Karpuls/E0005-esp32-s3-5v-controller/fab/E0005_revA/README.md

# E0005 ESP32-S3 5 V controller board, rev A: fabrication package

- Source: `E0005_controller.kicad_pcb` at commit `50c434e` (sha256 prefix `6ef8de77dd03ea71`), KiCad 10.99 (Backplane bp.4).
- Generated on 2026-10-28 by `build/scripts/fab_export.sh`. The script is deterministic: re-running it gives the same files apart from timestamps.
- Routing is final and approved by PlaceRoute at `50c434e`. That includes the USB pair at JLC's 90 Ω width (`c871ee5`) and the same-net via-in-pad fixes F-1/F-2 (`50c434e`).
- Gerber review: [`docs/gerber_review.md`](docs/gerber_review.md).

## Board
- **4 layers, 1.6 mm finished, 1 oz outer / 0.5 oz inner**, stackup **JLC04161H-3313**:
  - L1 0.035;
  - prepreg 3313 0.0994;
  - L2 0.0152;
  - core 1.265;
  - L3 0.0152;
  - prepreg 0.0994;
  - L4 0.035 mm.
- Layer use:
  - **F.Cu**: parts, most signals, power pours.
  - **In1**: solid GND, no tracks.
  - **In2**: V5 plane (west column and north port band), 3V3 plane, short slow-signal lanes.
  - **B.Cu**: signals, GND pour, holder lugs, B.Cu V5 strap, MID pours.
- **125 × 73 mm**, R3 corners, 4 × M3 holes (Ø3.2 mm plated, 4 mm corner inset).
- **Vias are tented** (board setting: tenting front and back), so there are no mask openings on vias. The only exceptions are the EP thermal vias inside U2's and U15's exposed pads.
- Vias 0.6/0.3 mm. Minimum track 0.15 mm (signals). JLC clearance rules plus the owner's via-to-pad rule are in `E0005_controller.kicad_dru`.
- Drills:
  - Plated, 701:
    - 685 × 0.30 (vias);
    - 4 × 0.60 oval slots (J11 USB-C shell);
    - 4 × 0.80 (NTC leads);
    - 4 × 1.30 (holder lugs);
    - 4 × 3.20 (M3).
  - **Non-plated, 8:**
    - 2 × 0.65 (USB-C pegs);
    - 2 × 2.40 and 4 × 3.60 (Keystone 1121 holder locating pegs).
- **USB D+/D−:** 90 Ω differential, F.Cu over In1 GND. W 0.153 mm, S 0.20 mm, coplanar with a 0.30 mm gap to the pour (see Impedance control).
- Board checks (`reports/`):
  - **DRC: 0 errors, 0 unconnected, 0 schematic-parity issues** (all severities, zones refilled). The **only** violation is the accepted U1 `lib_footprint_mismatch` warning (local override of the ESP32-S3-WROOM-1 footprint).
  - **ERC: 0 violations** (all severities).

## Files
| Path | Content |
|---|---|
| `E0005_revA_gerbers_JLC.zip` | **Upload this to JLC.** It holds 11 Gerbers (F/In1/In2/B Cu, F/B Mask, F/B Paste, F/B Silk, Edge.Cuts), the PTH and NPTH Excellon drills, and the job file |
| `gerbers/` | The same files, unzipped |
| `assembly/E0005_revA_CPL_JLC.csv` | Placement in JLC CPL format (Designator, Mid X, Mid Y, Layer T/B, Rotation; mm, absolute board coordinates). **267 fitted parts**; DNP excluded |
| `assembly/E0005_revA_BOM_JLC.csv` | BOM in JLC column format (Comment, Designator, Footprint, Manufacturer, Manufacturer Part, LCSC Part #). LCSC numbers are filled only for the LCSC-sourced GH connectors. Use it only if JLC assembles; the build plan is hand assembly |
| `assembly/E0005_revA_pos_front.csv`, `_pos_back.csv`, `_pos_all.csv` | KiCad position files (CSV, mm), including DNP |
| `assembly/E0005_revA_assembly_top.pdf`, `_bottom.pdf` | Assembly drawings: Fab layer (outlines and references, pads sketched), courtyards and board outline, with the title block. The bottom view is mirrored; DNP parts are crossed out |
| `assembly/E0005_revA_DNP.txt` | DNP list: **R60** |
| `E0005_revA_BOM.csv` | **DigiKey BOM (primary)**, generated by `build/scripts/make_bom.py` from the schematic. See [BOM_README.md](BOM_README.md) |
| `docs/E0005_revA_schematic.pdf` | Schematic |
| `docs/gerber_review.md`, `docs/gerber_review/` | Gerber review with images rendered from the gerbers, and the measured numbers (`gerber_review.json`) |
| `3d/E0005_revA.step` | Board STEP with components (DNP left out) |
| `reports/` | DRC and ERC (`.rpt` and `.json`), drill report, and PTH/NPTH drill maps (Gerber X2) |

## JLC order settings
- Layers **4**; thickness **1.6 mm**; outer copper **1 oz**, inner **0.5 oz**.
- **Impedance control: yes, stackup JLC04161H-3313.**
- Via covering: **tented**.
- Surface finish **ENIG** (as E0003; the board file's stackup finish is ENIG too). Any mask colour (E0003: any).
- Size 125 × 73 mm. Material FR-4, TG as standard.
- Remove the order number, or specify its location. There is room on the bottom between the holders.
- Bottom side: through-hole parts only (BH1/BH2 holders, RT1/RT2 NTCs), so B.Paste is empty. **Hand assembly with a stencil** (spec: Build). The holders and NTCs are hand-soldered.

### Impedance control
**90 Ω differential** for the **USB_DP / USB_DN** pair:
- on **L1 (F.Cu)**, referenced to **L2 (In1, solid GND)**;
- **W 0.153 mm / S 0.20 mm**, coplanar with a **0.30 mm gap to the pour**;
- stackup **JLC04161H-3313** (L1–L2 prepreg 3313, 0.0994 mm).

The width comes from JLC's impedance calculator (owner, 2026-10-28): 6.02 mil coplanar at S 0.20 mm. The pair has no layer changes; only the J11 B6/B7 contacts are tied over by two small vias.

## Gerber render check (summary of [docs/gerber_review.md](docs/gerber_review.md))
- **Copper:** the 4 layers match the board renders. **In1 is solid GND**: its only voids are antipads, hole clearances and the edge pullback. The **antenna keep-out has 0 copper** on all layers.
- **Mask:** openings on pads only. 685 vias are tented, apart from the EP vias and findings F-1/F-2 from the preliminary run (fixed in routing; see the gerber review).
- **Silk:** legible. **"5V" is at every port J1–J5** ("5V Jn E0001" and "5V J5 E0002"). Nothing on pads. The bottom silk is mirrored correctly.
- **Outline:** 125.0 × 73.0 mm with R3 corners. J11's shell slots are plated 0.6 mm ovals.
- **Drills:** the holder pegs (Ø3.6 / Ø2.4) and USB-C pegs are NPTH; M3, lugs and NTCs are plated.

## Notes
- **3D models not available, footprint outline only:**
  - **D12** (`Diode_SMD:D_0402_1005Metric`, TPD1E10B09);
  - **F1** (`Fuse:Fuse_Littelfuse-NANO2-451_453`);
  - **U15** (`Package_DFN_QFN:TDFN-14-1EP_3x3mm_P0.4mm_EP1.78x2.35mm`, MAX17205).

  The KiCad 3D library on this machine has no STEP for these three footprints (checked in both the 10.0.6 and 10.99 bp.4 installs). **E0003 doesn't have them either:** it uses the same F1 and U15 footprints, but its `lib/E0003_mech.3dshapes` holds only the Keystone 1121 model, and `fab/E0003_revA/3d/E0003_revA.step` has no fuse or TDFN body. The STEP is otherwise complete: board, the other parts, and the holders with cells.
- Rotations in the CPL are KiCad's. If JLC assembles, check the rotation preview at order time, as usual.

## Open before ordering
See [PREORDER.md](PREORDER.md).
