Karpuls/E0005-esp32-s3-5v-controller/fab/E0005_revA/reports/E0005_revA_drill_report.txt

Drill report for E0005_controller.kicad_pcb
Created on 2026-10-28T16:46:57

Copper Layer Stackup:
    =============================================================
    L1 :  F.Cu                      front
    L2 :  In1.Cu                    in1
    L3 :  In2.Cu                    in2
    L4 :  B.Cu                      back

Drill file 'E0005_controller-PTH.drl' contains
    plated through holes:
    =============================================================
    T1  0.300mm  0.0118"  (685 holes))
    T2  0.600mm  0.0236"  (4 holes)  (with 4 slots)
    T3  0.800mm  0.0315"  (4 holes))
    T4  1.300mm  0.0512"  (4 holes))
    T5  3.200mm  0.1260"  (4 holes))

    Total plated holes count 701

Drill file 'E0005_controller-NPTH.drl' contains
    unplated through holes:
    =============================================================
    T1  0.650mm  0.0256"  (2 holes))
    T2  2.400mm  0.0945"  (2 holes))
    T3  3.600mm  0.1417"  (4 holes))

    Total unplated holes count 8
