Karpuls/E0005-esp32-s3-5v-controller/docs/images/E0005_place_bottom.png

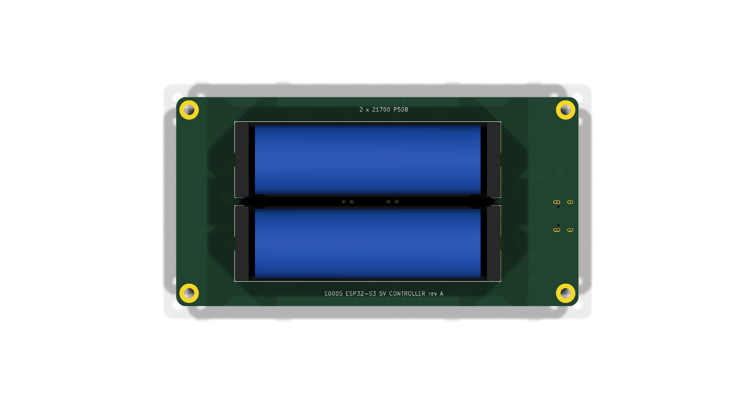
docs/images/E0005_place_bottom.png
