Karpuls/E0005-esp32-s3-5v-controller/docs/images/E0005_place_top.png

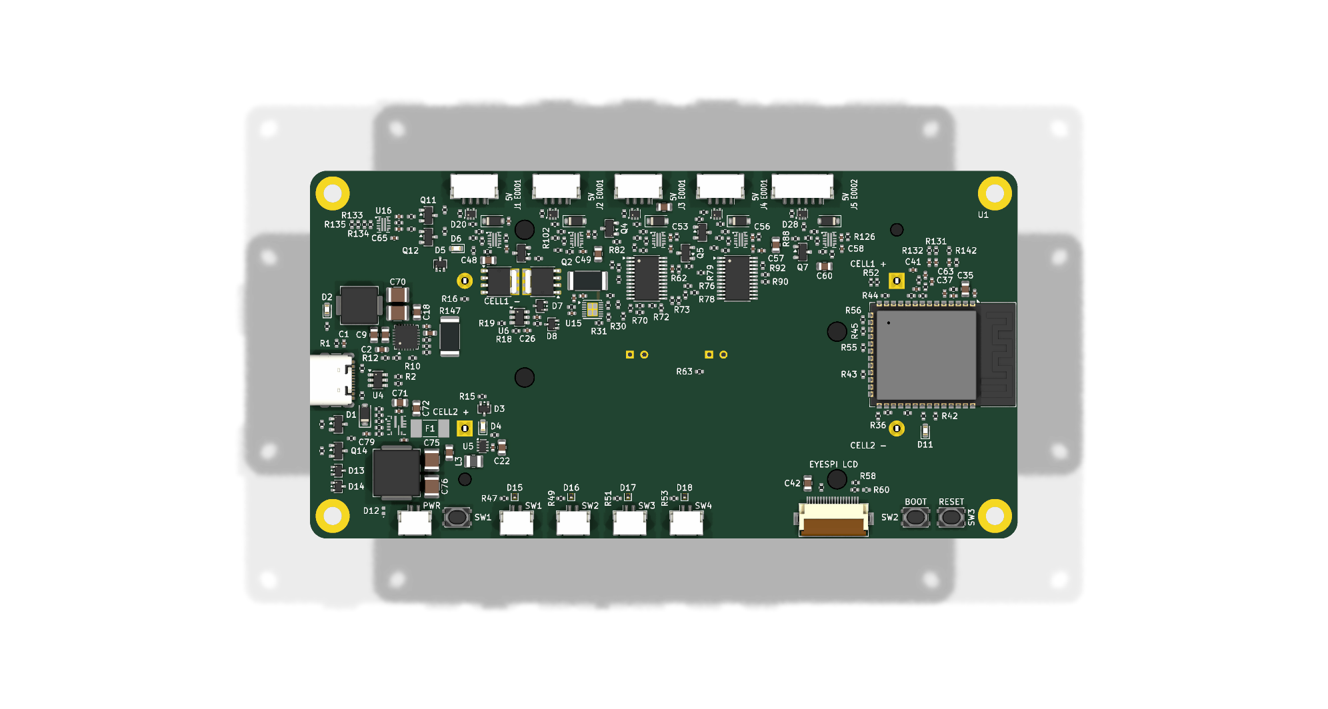
docs/images/E0005_place_top.png
