Karpuls/E0005-esp32-s3-5v-controller/fab/E0005_revA/docs/gerber_review/gerber_B_mask_vias.png

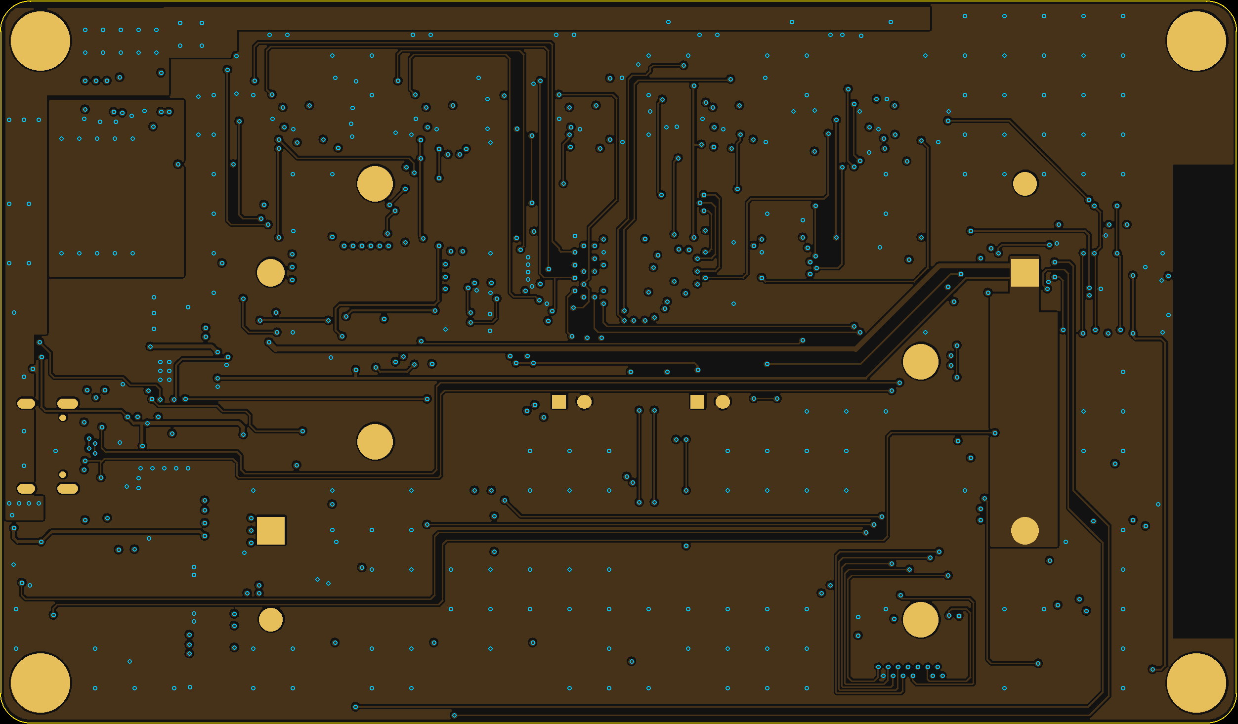
fab/E0005_revA/docs/gerber_review/gerber_B_mask_vias.png
