Karpuls/E0005-esp32-s3-5v-controller/bom/new_parts_digikey.csv

MPN | Manufacturer | SupplierPN | Stock | Lifecycle | UnitUSD | Checked | Note
BQ25887RGER | Texas Instruments | 296-53517-1-ND | 10911 | Active | 5.61 | 2026-10-27 | Cut tape 296-53517-1-ND (DigiKey API resolves it to the BQ25887RGER product page, 10 911 in stock; T&R is 296-53517-2-ND). Replaces RGET (T&R only, 211 pcs, MOQ 250) per PlaceRoute.
TPS56637RPAR | Texas Instruments | 296-TPS56637RPARTR-ND | 14313 | Active | 2.71 | 2026-10-27 | Only the T&R listing returned (14 313, MOQ 3000); cut tape (CT) PN not confirmed by the lookup: check at order time
IHLP2525CZER1R0M01 | Vishay Dale | 541-1006-1-ND | 38987 | Active | 1.11 | 2026-10-27 | 1 uH 11 A rated / 22 A sat, 10 mOhm max (TR 541-1006-2-ND)
RMCF2512FT39R0 | Stackpole Electronics Inc | RMCF2512FT39R0CT-ND | 34038 | Active | 0.25 | 2026-10-27 | 39R 1% 1 W 2512 (TR RMCF2512FT39R0TR-ND)
SMF5.0A | Littelfuse Inc. | F5748CT-ND | 21423 | Active | 0.50 | 2026-10-27 | common part E0001/E0002
TPD1E10B09DPYR | Texas Instruments | 296-30405-1-ND | 48491 | Active | 0.65 | 2026-10-27 | 9 V bidirectional ESD, X1SON-2 0402 (TR 296-30405-2-ND)
RC0402FR-07374RL | YAGEO | YAG3137CT-ND | 131070 | Active | 0.10 | 2026-10-27
RC0402FR-07300RL | YAGEO | 311-300LRCT-ND | 190616 | Active | 0.10 | 2026-10-27
RC0402FR-0714K3L | YAGEO | YAG2983CT-ND | 0 | Active | 0.10 | 2026-10-27 | STOCK 0: not used (FB divider changed to 69.8k/10k)
RC0402FR-0769K8L | YAGEO | YAG3216CT-ND | 174137 | Active | 0.10 | 2026-10-27
RC0402FR-07200KL | YAGEO | 311-200KLRCT-ND | 1264282 | Active | 0.10 | 2026-10-27
RC0402FR-0753K6L | YAGEO | 311-53.6KLRCT-ND | 86892 | Active | 0.10 | 2026-10-27
RC0402FR-076K65L | YAGEO | YAG3219CT-ND | 237279 | Active | 0.11 | 2026-10-27
RC0402FR-072K32L | YAGEO | YAG3100CT-ND | 105858 | Active | 0.10 | 2026-10-27
RC0402FR-07249KL | YAGEO | 311-249KLRCT-ND | 93250 | Active | 0.10 | 2026-10-27
RC0402FR-07390KL | YAGEO | YAG3143CT-ND | 80565 | Active | 0.11 | 2026-10-27
RC0402FR-075K1L | YAGEO | 311-5.10KLRCT-ND | 599923 | Active | 0.10 | 2026-10-27
GRM1555C1H101JA01D | Murata Electronics | 490-5922-1-ND | 107905 | Active | 0.11 | 2026-10-27 | 100 pF C0G (TR 490-5922-2-ND)
AO3401A | Alpha & Omega Semiconductor Inc. | 785-1001-1-ND | 321804 | Active | 0.52 | 2026-10-27 | common part (E0001/E0002); -30 V, VGS +-12 V, Vth -1.3 V max
RC0402FR-07402KL | YAGEO | YAG3151CT-ND | 514706 | Active | 0.11 | 2026-10-27 | port EN/UVLO (SPEC v1.1)
IHLP3232DZER3R3M11 | Vishay Dale | 541-1352-1-ND | 5904 | Active | 1.29 | 2026-10-27 | 3.3 uH 10.5 A rated / 9.7 A sat, 14.9 mOhm max, 8.64 x 8.18 x 4.0 mm; TPS56637 datasheet part (TR 541-1352-2-ND)
