Karpuls/E0005-esp32-s3-5v-controller/fab/E0005_revA/3d/E0005_revA.step

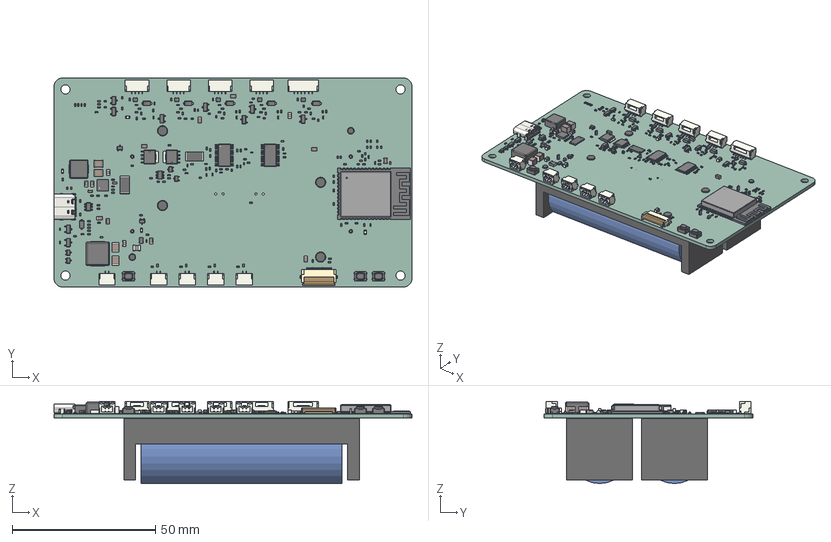
[picture p24: CAD file, 2026-10-28]
fab/E0005_revA/3d/E0005_revA.step
125.0 x 73.0 x 28.7 mm
R_0402_1005Metric x 134
L_Vishay_IHLP-3232
SOT-23 x 9
C_0402_1005Metric x 36
SW_SPST_PTS810 x 3
LED_0603_1608Metric x 4
USB_C_Receptacle_16P_TopMnt_Horizontal_GCT_USB4105-xx-A
C_0603_1608Metric x 2
SOT_553 x 5
SOT-23-6 x 2
TSSOP-24_4.4x7.8mm_P0.65mm x 2
SOT-323_SC-70 x 6
C_0805_2012Metric x 14
D_SOD_123F x 6
D_SOD-882 x 4
lock
pins
C_1210_3225Metric x 4
adbeea53-9c39-11ed-93f0-dde97e994e83_part x 2
adbeea54-9c39-11ed-93f0-dde97e994e83_part x 2
adbeea55-9c39-11ed-93f0-dde97e994e83_part x 2
JST_SM02B_GHS_TB x 5
L_1008_2520Metric
ESP32-S3-WROOM-1
JST_SM04B_GHS_TB x 4
JST_SM06B_GHS_TB
L_Vishay_IHLP-2525
R_2512_6332Metric x 2
Texas_RGE0024H_VQFN-24-1EP_4x4mm_P0.5mm_EP2.7x2.7mm
SOT-583-8
holder_fixed x 2
cell_P50B_fixed x 2
lug_neg_fixed x 2
lug_pos_fixed x 2
E0005_controller_PCB
