Karpuls/E0005-esp32-s3-5v-controller/fab/E0005_revA/assembly/E0005_revA_assembly_bottom.pdf

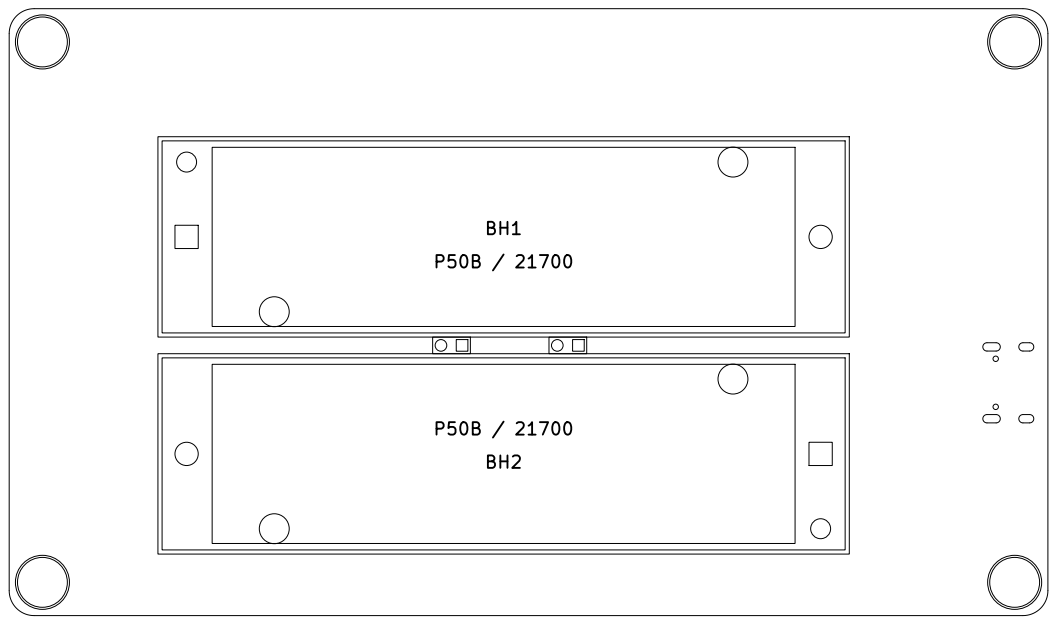
[picture p25: page 1]

4 layers 1.6 mm, JLC04161H-3313, 1 oz outer / 0.5 oz inner

Size: A4 | Rev: A
KiCad E.D.A. 10.99.0-unknown | Id: 1/1
