Karpuls/E0005-esp32-s3-5v-controller/fab/E0005_revA/docs/E0005_revA_schematic.pdf

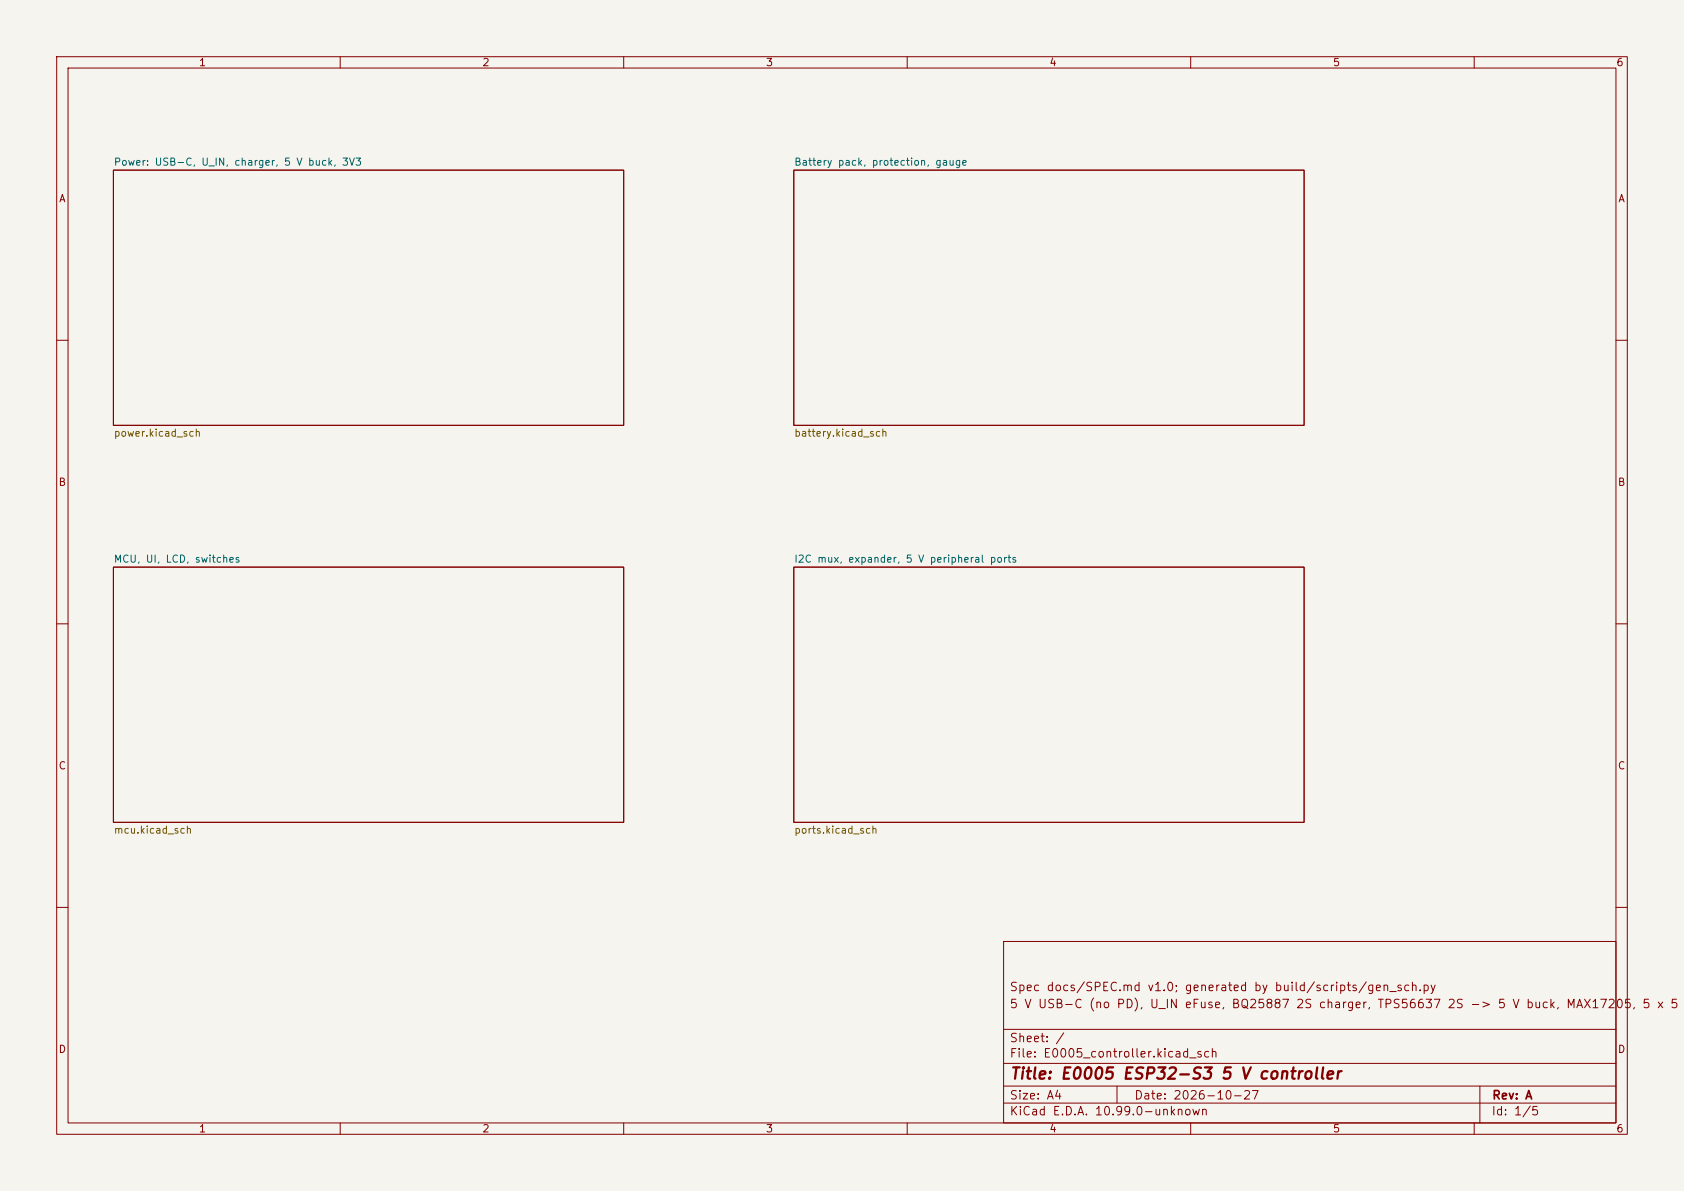
[picture p26: page 1]

Power: USB-C, U_IN, charger, 5 V buck, 3V3

Battery pack, protection, gauge battery.kicad_sch

power.kicad_sch
MCU, UI, LCD, switches mcu.kicad_sch

I2C mux, expander, 5 V peripheral ports

Spec docs/SPEC.md v1.0; generated by build/scripts/gen_sch.py
5 V USB-C (no PD), U_IN eFuse, BQ25887 2S charger, TPS56637 2S -> 5 V buck, MAX17205, 5 x 5 V ports

Size: A4 | Rev: A
KiCad E.D.A. 10.99.0-unknown | Id: 1/5

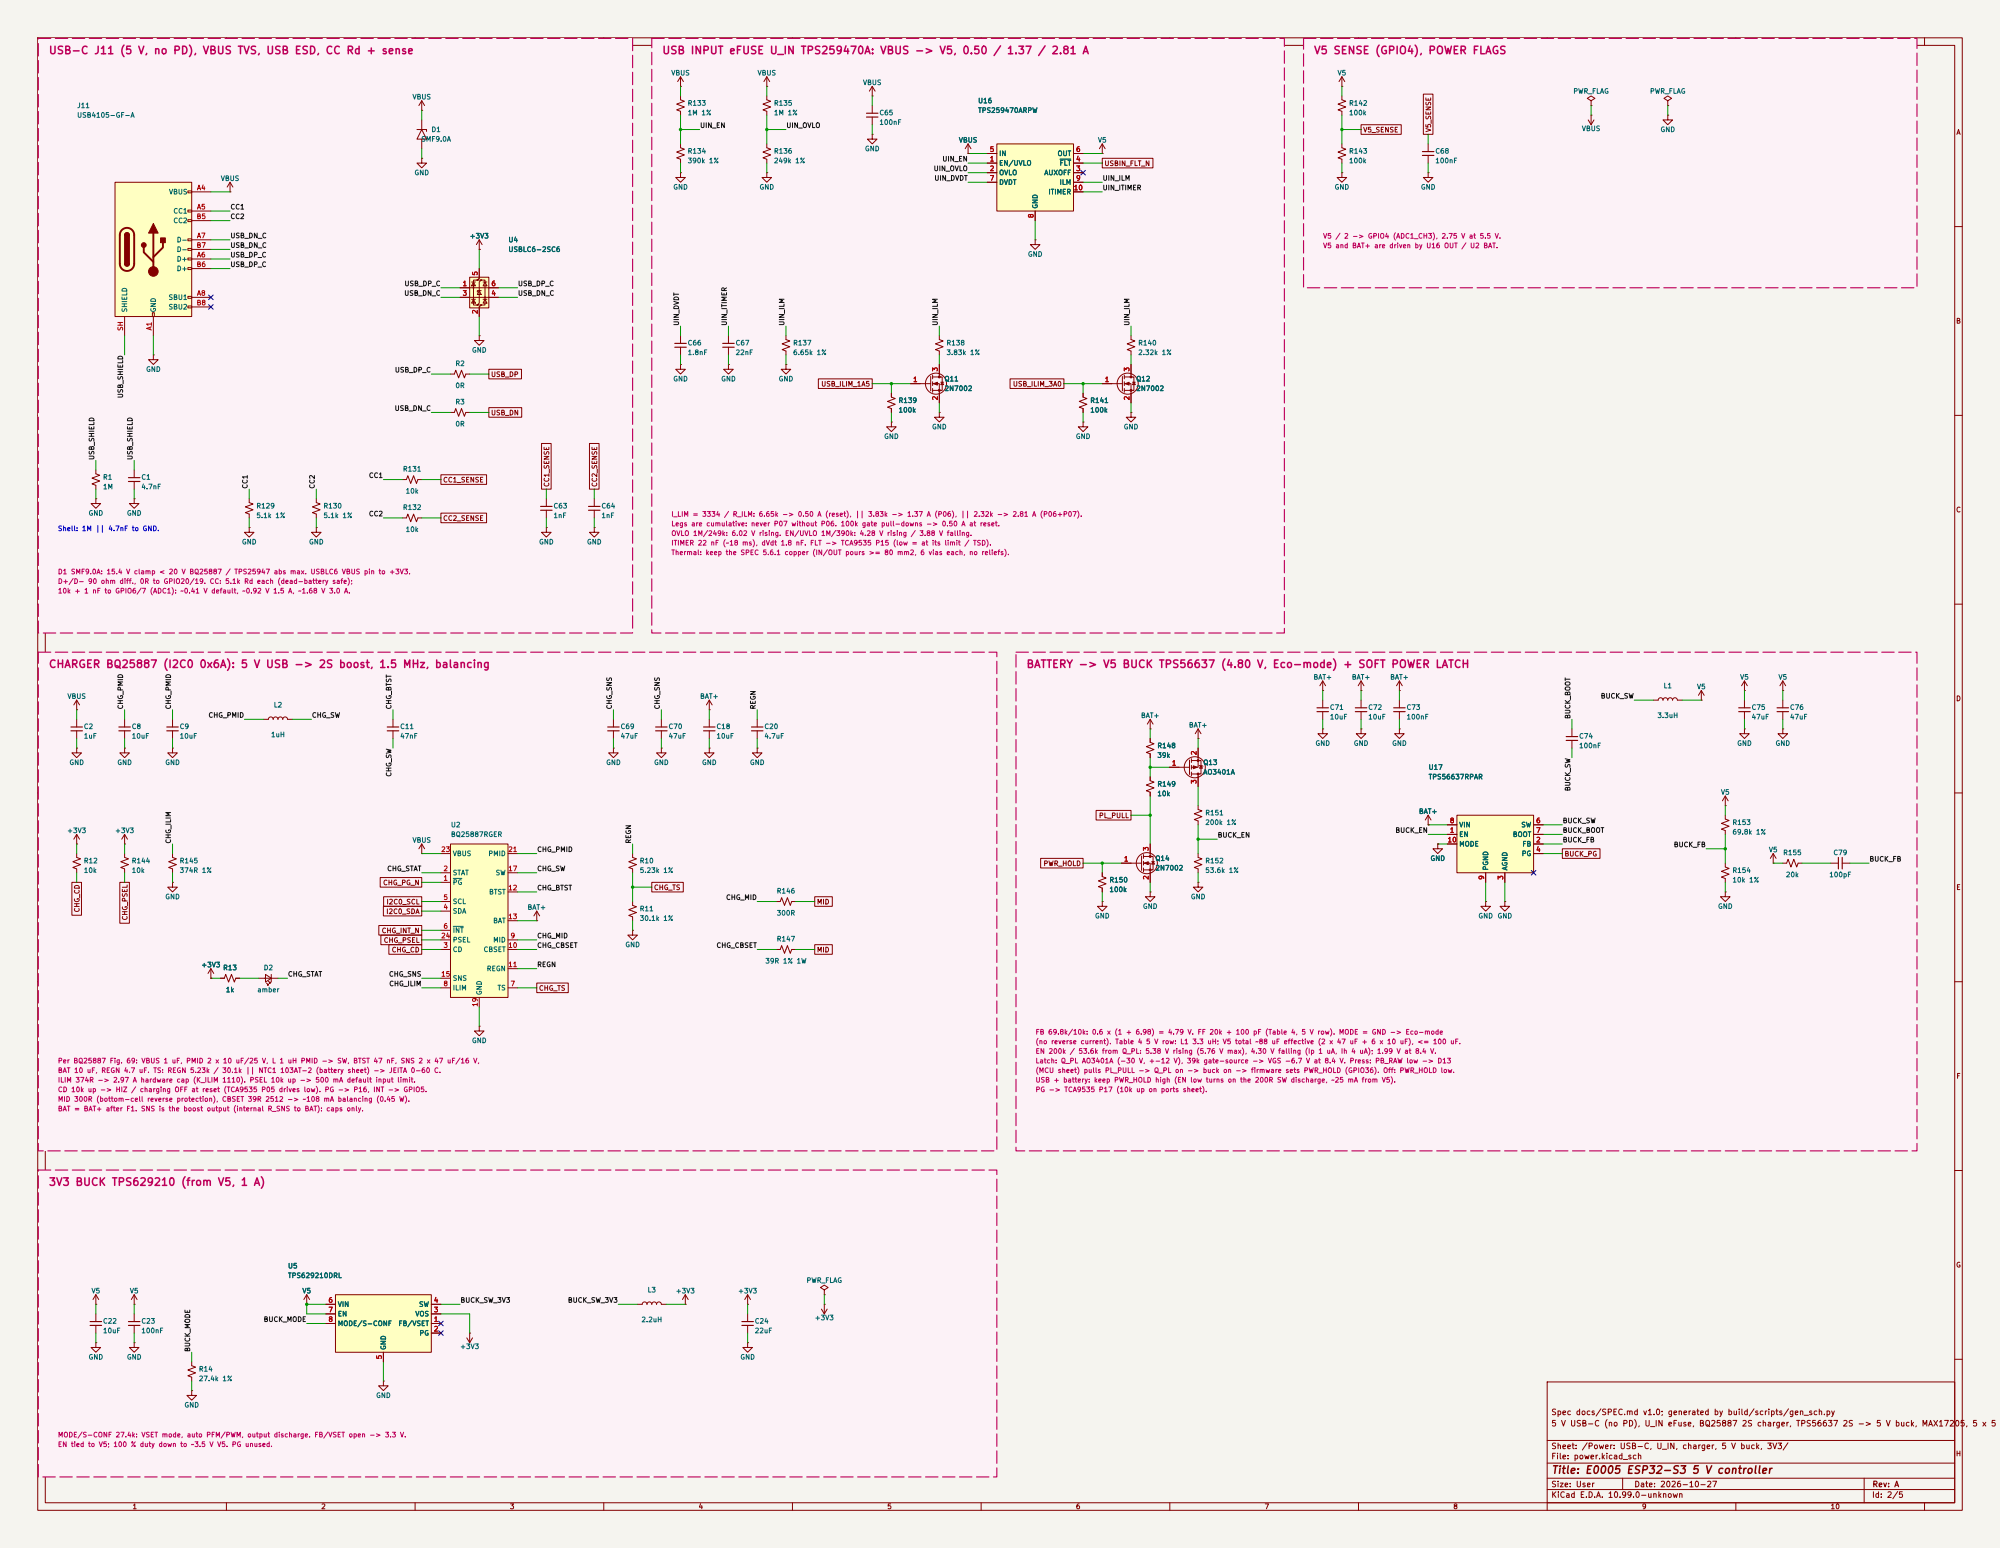
[picture p27: page 2]

V5 / 2 -> GPIO4 (ADC1_CH3), 2.75 V at 5.5 V. V5 and BAT+ are driven by U16 OUT / U2 BAT. V5 SENSE (GPIO4), POWER FLAGS
100k V5 GND

I_LIM = 3334 / R_ILM: 6.65k -> 0.50 A (reset), || 3.83k -> 1.37 A (P06), || 2.32k -> 2.81 A (P06+P07).
Legs are cumulative: never P07 without P06. 100k gate pull-downs -> 0.50 A at reset.
ITIMER 22 nF (~18 ms), dVdt 1.8 nF. FLT -> TCA9535 P15 (low = at its limit / TSD). OVLO 1M/249k: 6.02 V rising. EN/UVLO 1M/390k: 4.28 V rising / 3.88 V falling.

Shell: 1M || 4.7nF to GND. 10k + 1 nF to GPIO6/7 (ADC1): ~0.41 V default, ~0.92 V 1.5 A, ~1.68 V 3.0 A. D+/D- 90 ohm diff., 0R to GPIO20/19. CC: 5.1k Rd each (dead-battery safe); D1 SMF9.0A: 15.4 V clamp < 20 V BQ25887 / TPS25947 abs max. USBLC6 VBUS pin to +3V3.

Thermal: keep the SPEC 5.6.1 copper (IN/OUT pours >= 80 mm2, 6 vias each, no reliefs).

CHARGER BQ25887 (I2C0 0x6A): 5 V USB -> 2S boost, 1.5 MHz, balancing

BATTERY -> V5 BUCK TPS56637 (4.80 V, Eco-mode) + SOFT POWER LATCH

FB 69.8k/10k: 0.6 x (1 + 6.98) = 4.79 V. FF 20k + 100 pF (Table 4, 5 V row). MODE = GND -> Eco-mode

Per BQ25887 Fig. 69: VBUS 1 uF, PMID 2 x 10 uF/25 V, L 1 uH PMID -> SW, BTST 47 nF, SNS 2 x 47 uF/16 V, BAT 10 uF, REGN 4.7 uF. TS: REGN 5.23k / 30.1k || NTC1 103AT-2 (battery sheet) -> JEITA 0-60 C. CD 10k up -> HIZ / charging OFF at reset (TCA9535 P05 drives low). PG -> P16, INT -> GPIO5.
(MCU sheet) pulls PL_PULL -> Q_PL on -> buck on -> firmware sets PWR_HOLD (GPIO36). Off: PWR_HOLD low. EN tied to V5; 100 % duty down to ~3.5 V V5. PG unused. MODE/S-CONF 27.4k: VSET mode, auto PFM/PWM, output discharge. FB/VSET open -> 3.3 V. 3V3 BUCK TPS629210 (from V5, 1 A)
FGH
ILIM 374R -> 2.97 A hardware cap (K_ILIM 1110). PSEL 10k up -> 500 mA default input limit. MID 300R (bottom-cell reverse protection), CBSET 39R 2512 -> ~108 mA balancing (0.45 W). BAT = BAT+ after F1. SNS is the boost output (internal R_SNS to BAT): caps only.

PG -> TCA9535 P17 (10k up on ports sheet).

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

Sheet: /Power: USB-C, U_IN, charger, 5 V buck, 3V3/
File: power.kicad_sch
Title: E0005 ESP32-S3 5 V controller

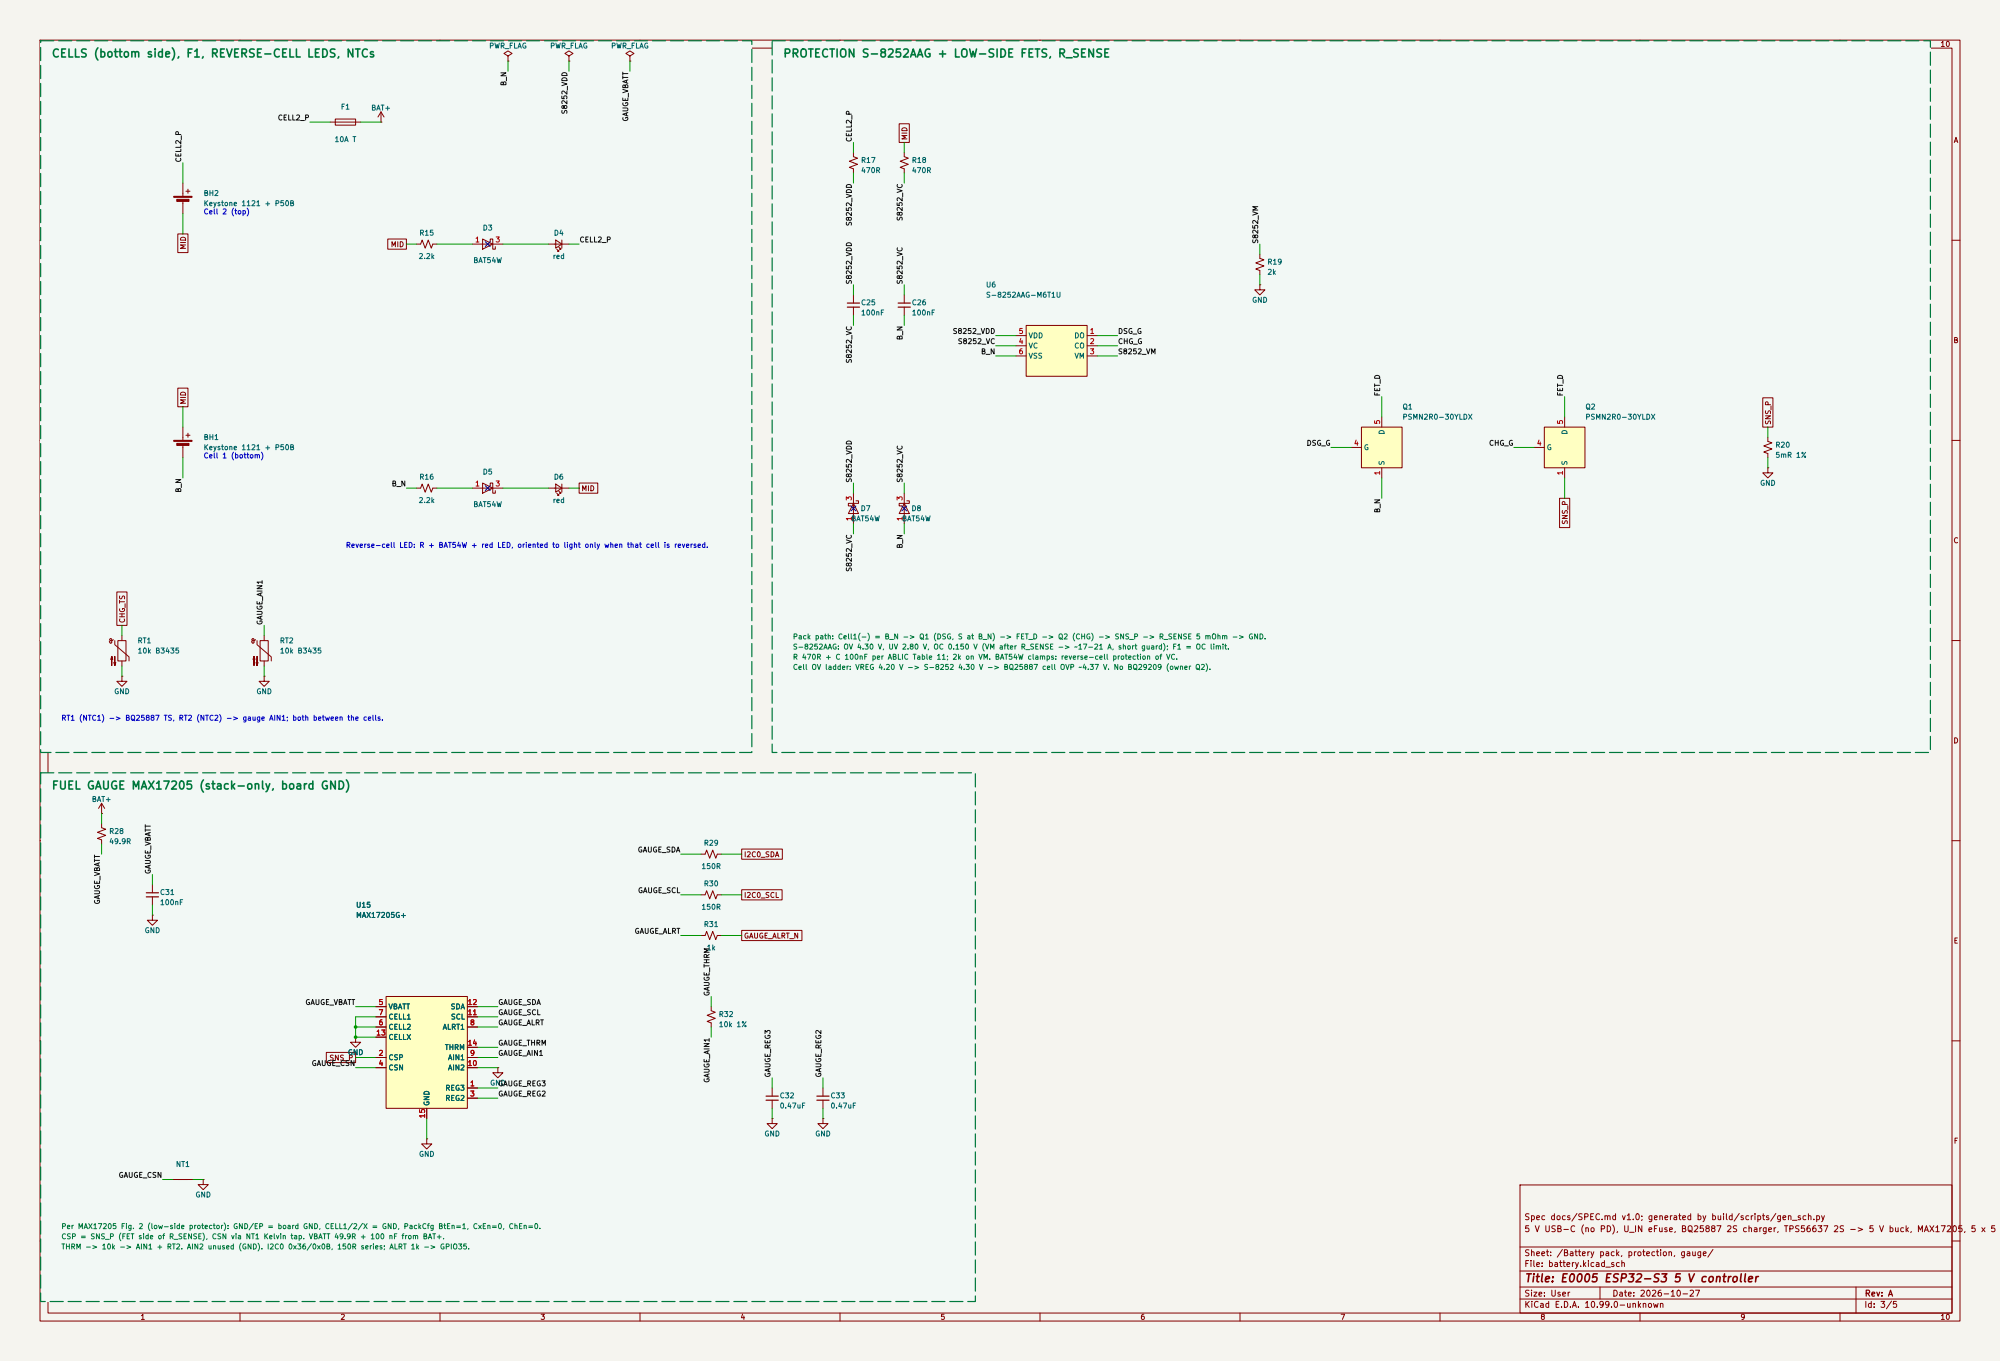
[picture p28: page 3]

R 470R + C 100nF per ABLIC Table 11; 2k on VM. BAT54W clamps: reverse-cell protection of VC. Cell OV ladder: VREG 4.20 V -> S-8252 4.30 V -> BQ25887 cell OVP ~4.37 V. No BQ29209 (owner Q2). RT1 (NTC1) -> BQ25887 TS, RT2 (NTC2) -> gauge AIN1; both between the cells. FUEL GAUGE MAX17205 (stack-only, board GND)

Spec docs/SPEC.md v1.0; generated by build/scripts/gen_sch.py GND

Per MAX17205 Fig. 2 (low-side protector): GND/EP = board GND, CELL1/2/X = GND, PackCfg BtEn=1, CxEn=0, ChEn=0. CSP = SNS_P (FET side of R_SENSE), CSN via NT1 Kelvin tap. VBATT 49.9R + 100 nF from BAT+. THRM -> 10k -> AIN1 + RT2. AIN2 unused (GND). I2C0 0x36/0x0B, 150R series; ALRT 1k -> GPIO35.

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

Sheet: /Battery pack, protection, gauge/
File: battery.kicad_sch

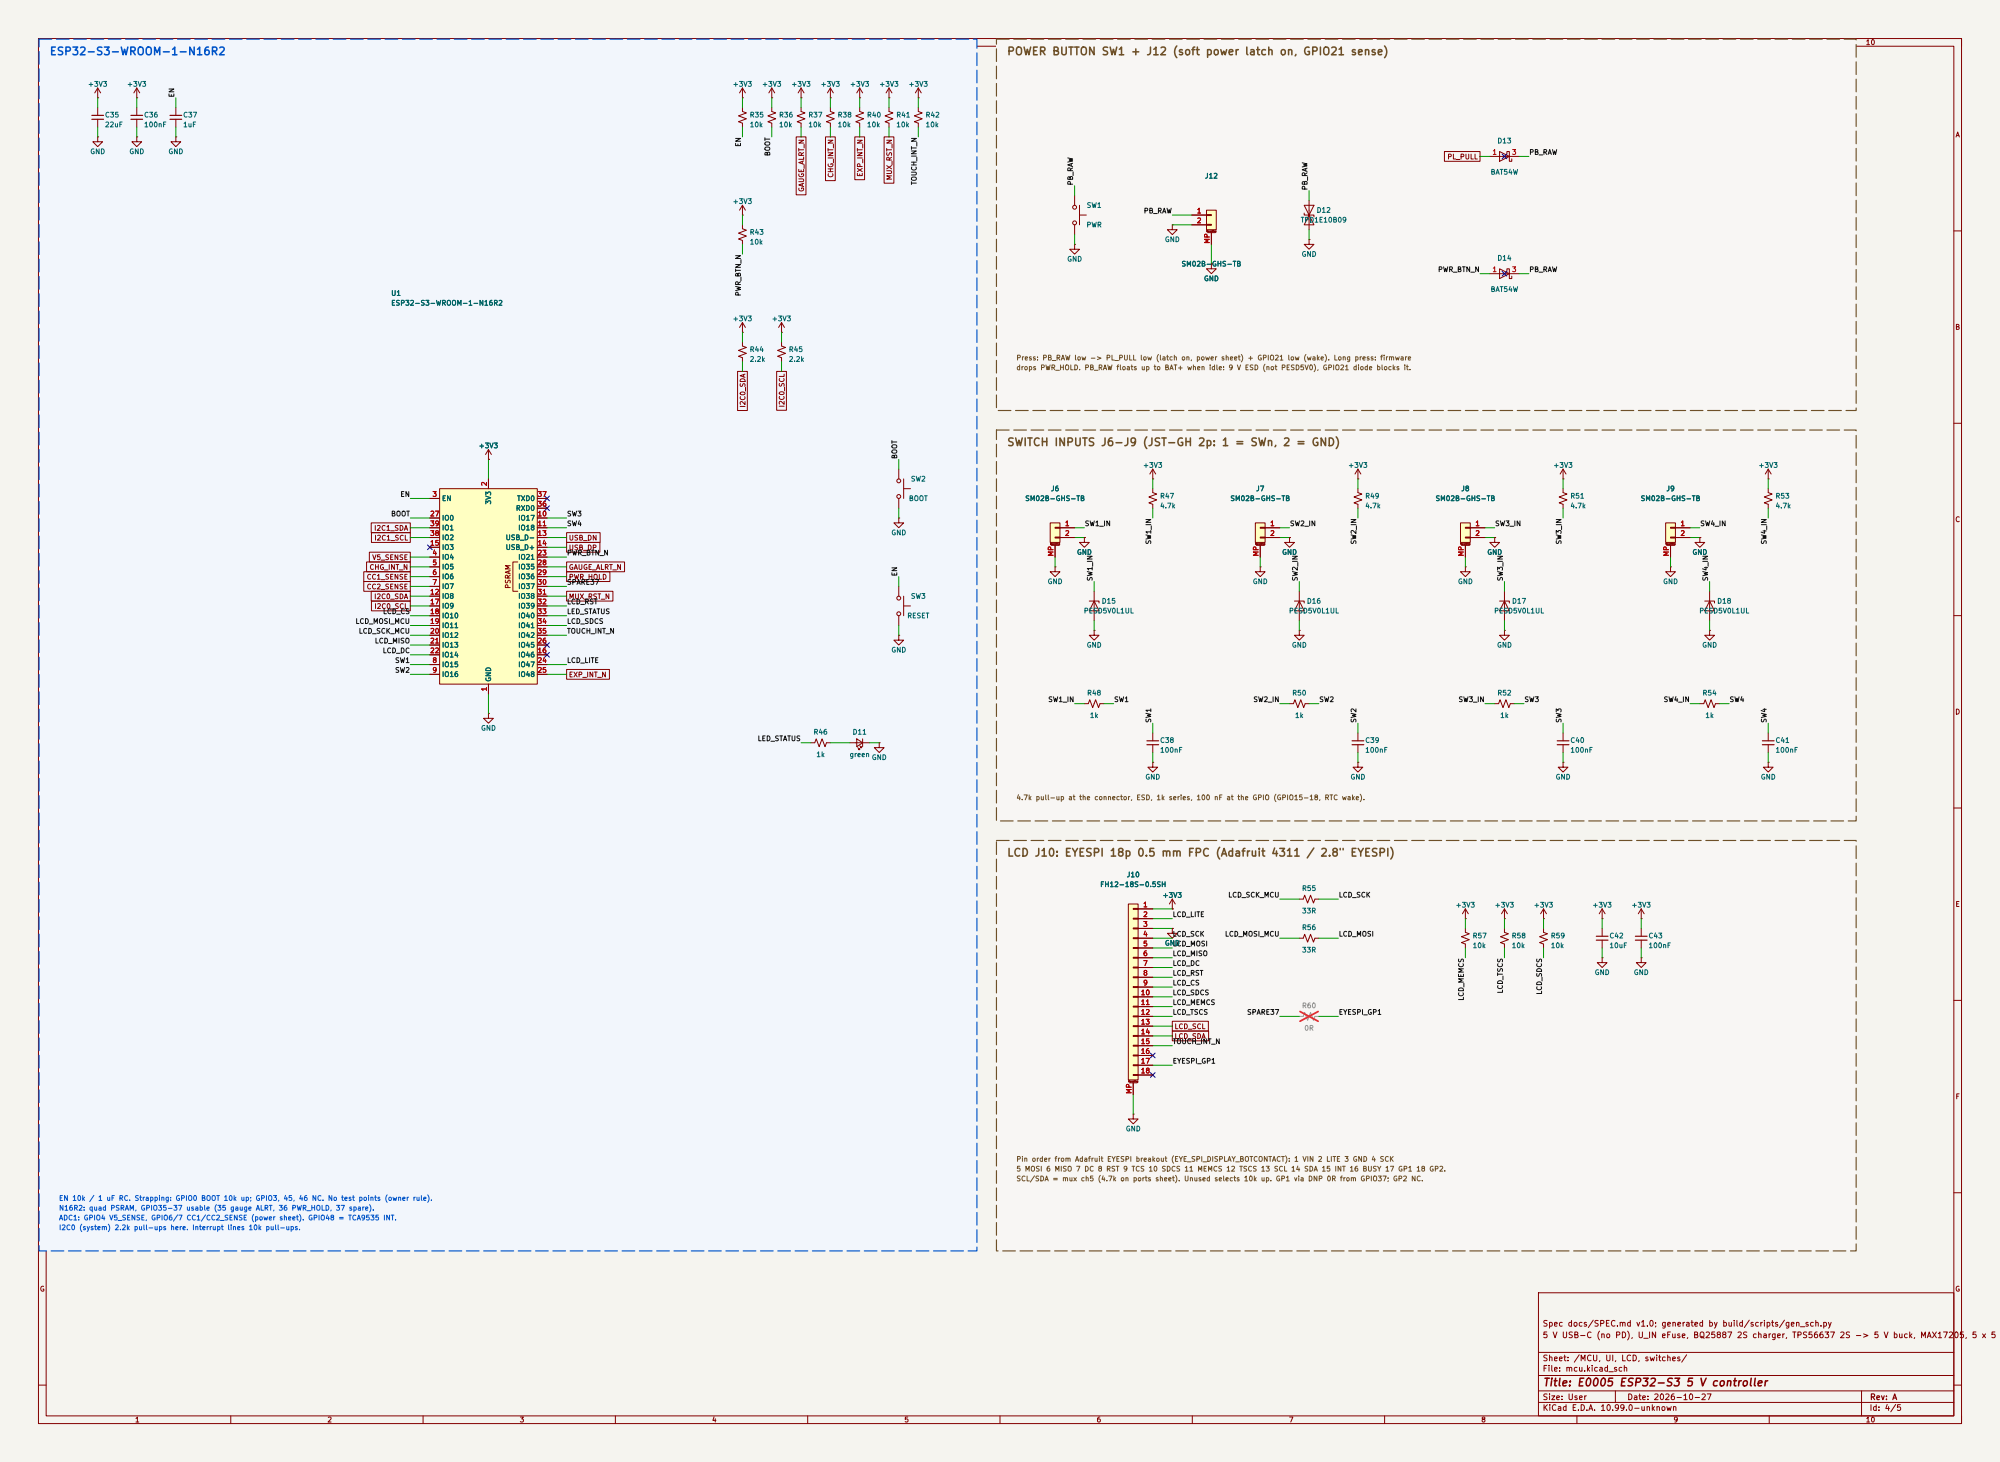
[picture p29: page 4]

POWER BUTTON SW1 + J12 (soft power latch on, GPIO21 sense)

Press: PB_RAW low -> PL_PULL low (latch on, power sheet) + GPIO21 low (wake). Long press: firmware drops PWR_HOLD. PB_RAW floats up to BAT+ when idle: 9 V ESD (not PESD5V0), GPIO21 diode blocks it. LCD J10: EYESPI 18p 0.5 mm FPC (Adafruit 4311 / 2.8" EYESPI)

SWITCH INPUTS J6-J9 (JST-GH 2p: 1 = SWn, 2 = GND)

SCL/SDA = mux ch5 (4.7k on ports sheet). Unused selects 10k up. GP1 via DNP 0R from GPIO37; GP2 NC. 5 MOSI 6 MISO 7 DC 8 RST 9 TCS 10 SDCS 11 MEMCS 12 TSCS 13 SCL 14 SDA 15 INT 16 BUSY 17 GP1 18 GP2. Pin order from Adafruit EYESPI breakout (EYE_SPI_DISPLAY_BOTCONTACT): 1 VIN 2 LITE 3 GND 4 SCK

EN 10k / 1 uF RC. Strapping: GPIO0 BOOT 10k up; GPIO3, 45, 46 NC. No test points (owner rule). N16R2: quad PSRAM, GPIO35-37 usable (35 gauge ALRT, 36 PWR_HOLD, 37 spare).

ADC1: GPIO4 V5_SENSE, GPIO6/7 CC1/CC2_SENSE (power sheet). GPIO48 = TCA9535 INT.
I2C0 (system) 2.2k pull-ups here. Interrupt lines 10k pull-ups.

Spec docs/SPEC.md v1.0; generated by build/scripts/gen_sch.py

Sheet: /MCU, UI, LCD, switches/
File: mcu.kicad_sch

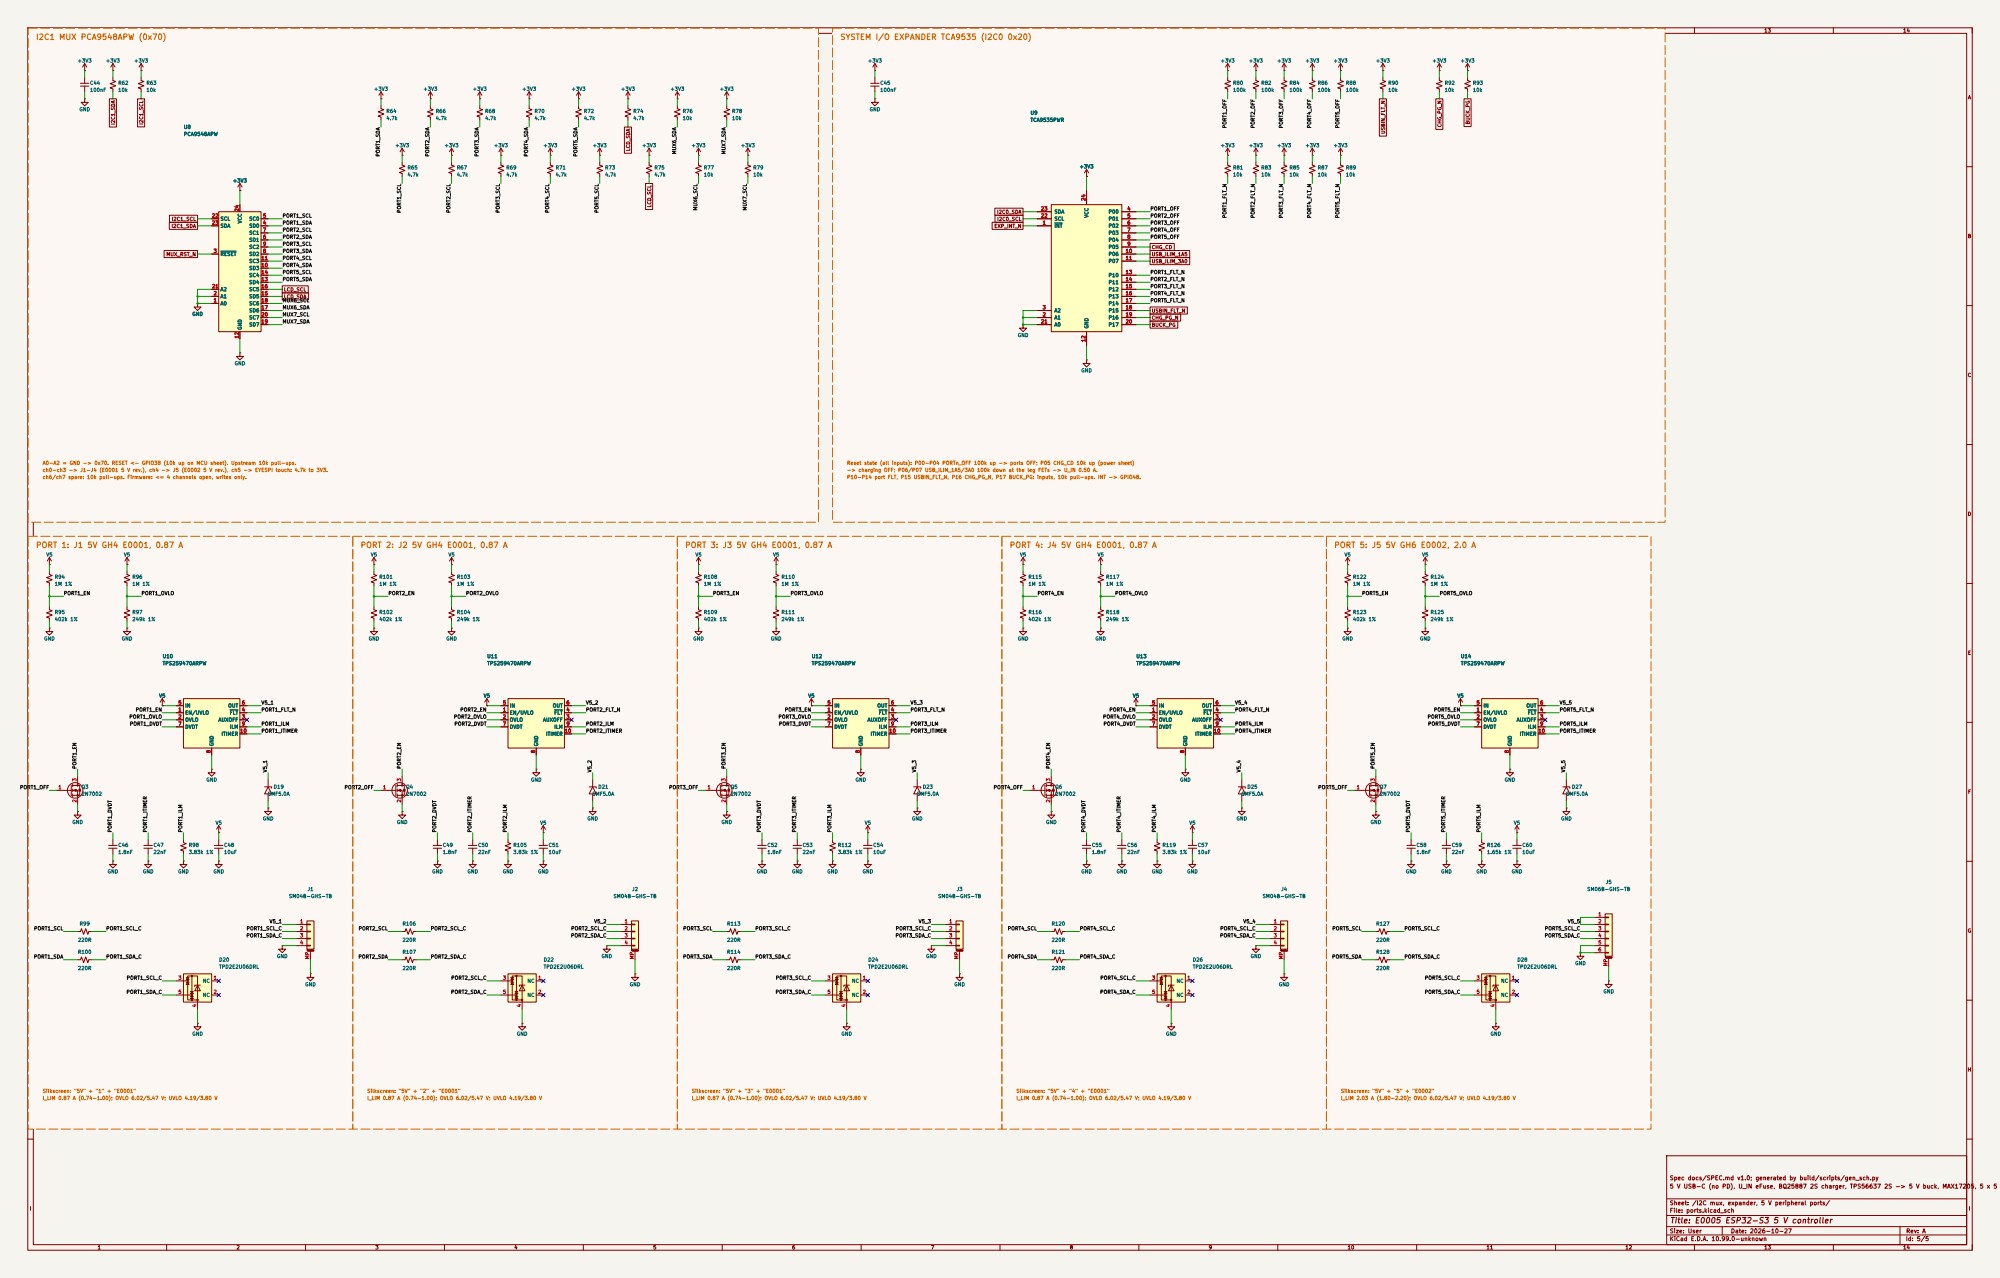
[picture p30: page 5]

ch6/ch7 spare: 10k pull-ups. Firmware: <= 4 channels open, writes only. ch0-ch3 -> J1-J4 (E0001 5 V rev.), ch4 -> J5 (E0002 5 V rev.), ch5 -> EYESPI touch: 4.7k to 3V3. A0-A2 = GND -> 0x70. RESET <- GPIO38 (10k up on MCU sheet). Upstream 10k pull-ups.

P10-P14 port FLT, P15 USBIN_FLT_N, P16 CHG_PG_N, P17 BUCK_PG: inputs, 10k pull-ups. INT -> GPIO48. Reset state (all inputs): P00-P04 PORTn_OFF 100k up -> ports OFF; P05 CHG_CD 10k up (power sheet) -> charging OFF; P06/P07 USB_ILIM_1A5/3A0 100k down at the leg FETs -> U_IN 0.50 A.

Spec docs/SPEC.md v1.0; generated by build/scripts/gen_sch.py

Sheet: /I2C mux, expander, 5 V peripheral ports/
File: ports.kicad_sch
