Karpuls/E0005-esp32-s3-5v-controller/E0005_controller.kicad_pcb

## KiCad design E0005_controller.kicad_pcb (2026-10-28)

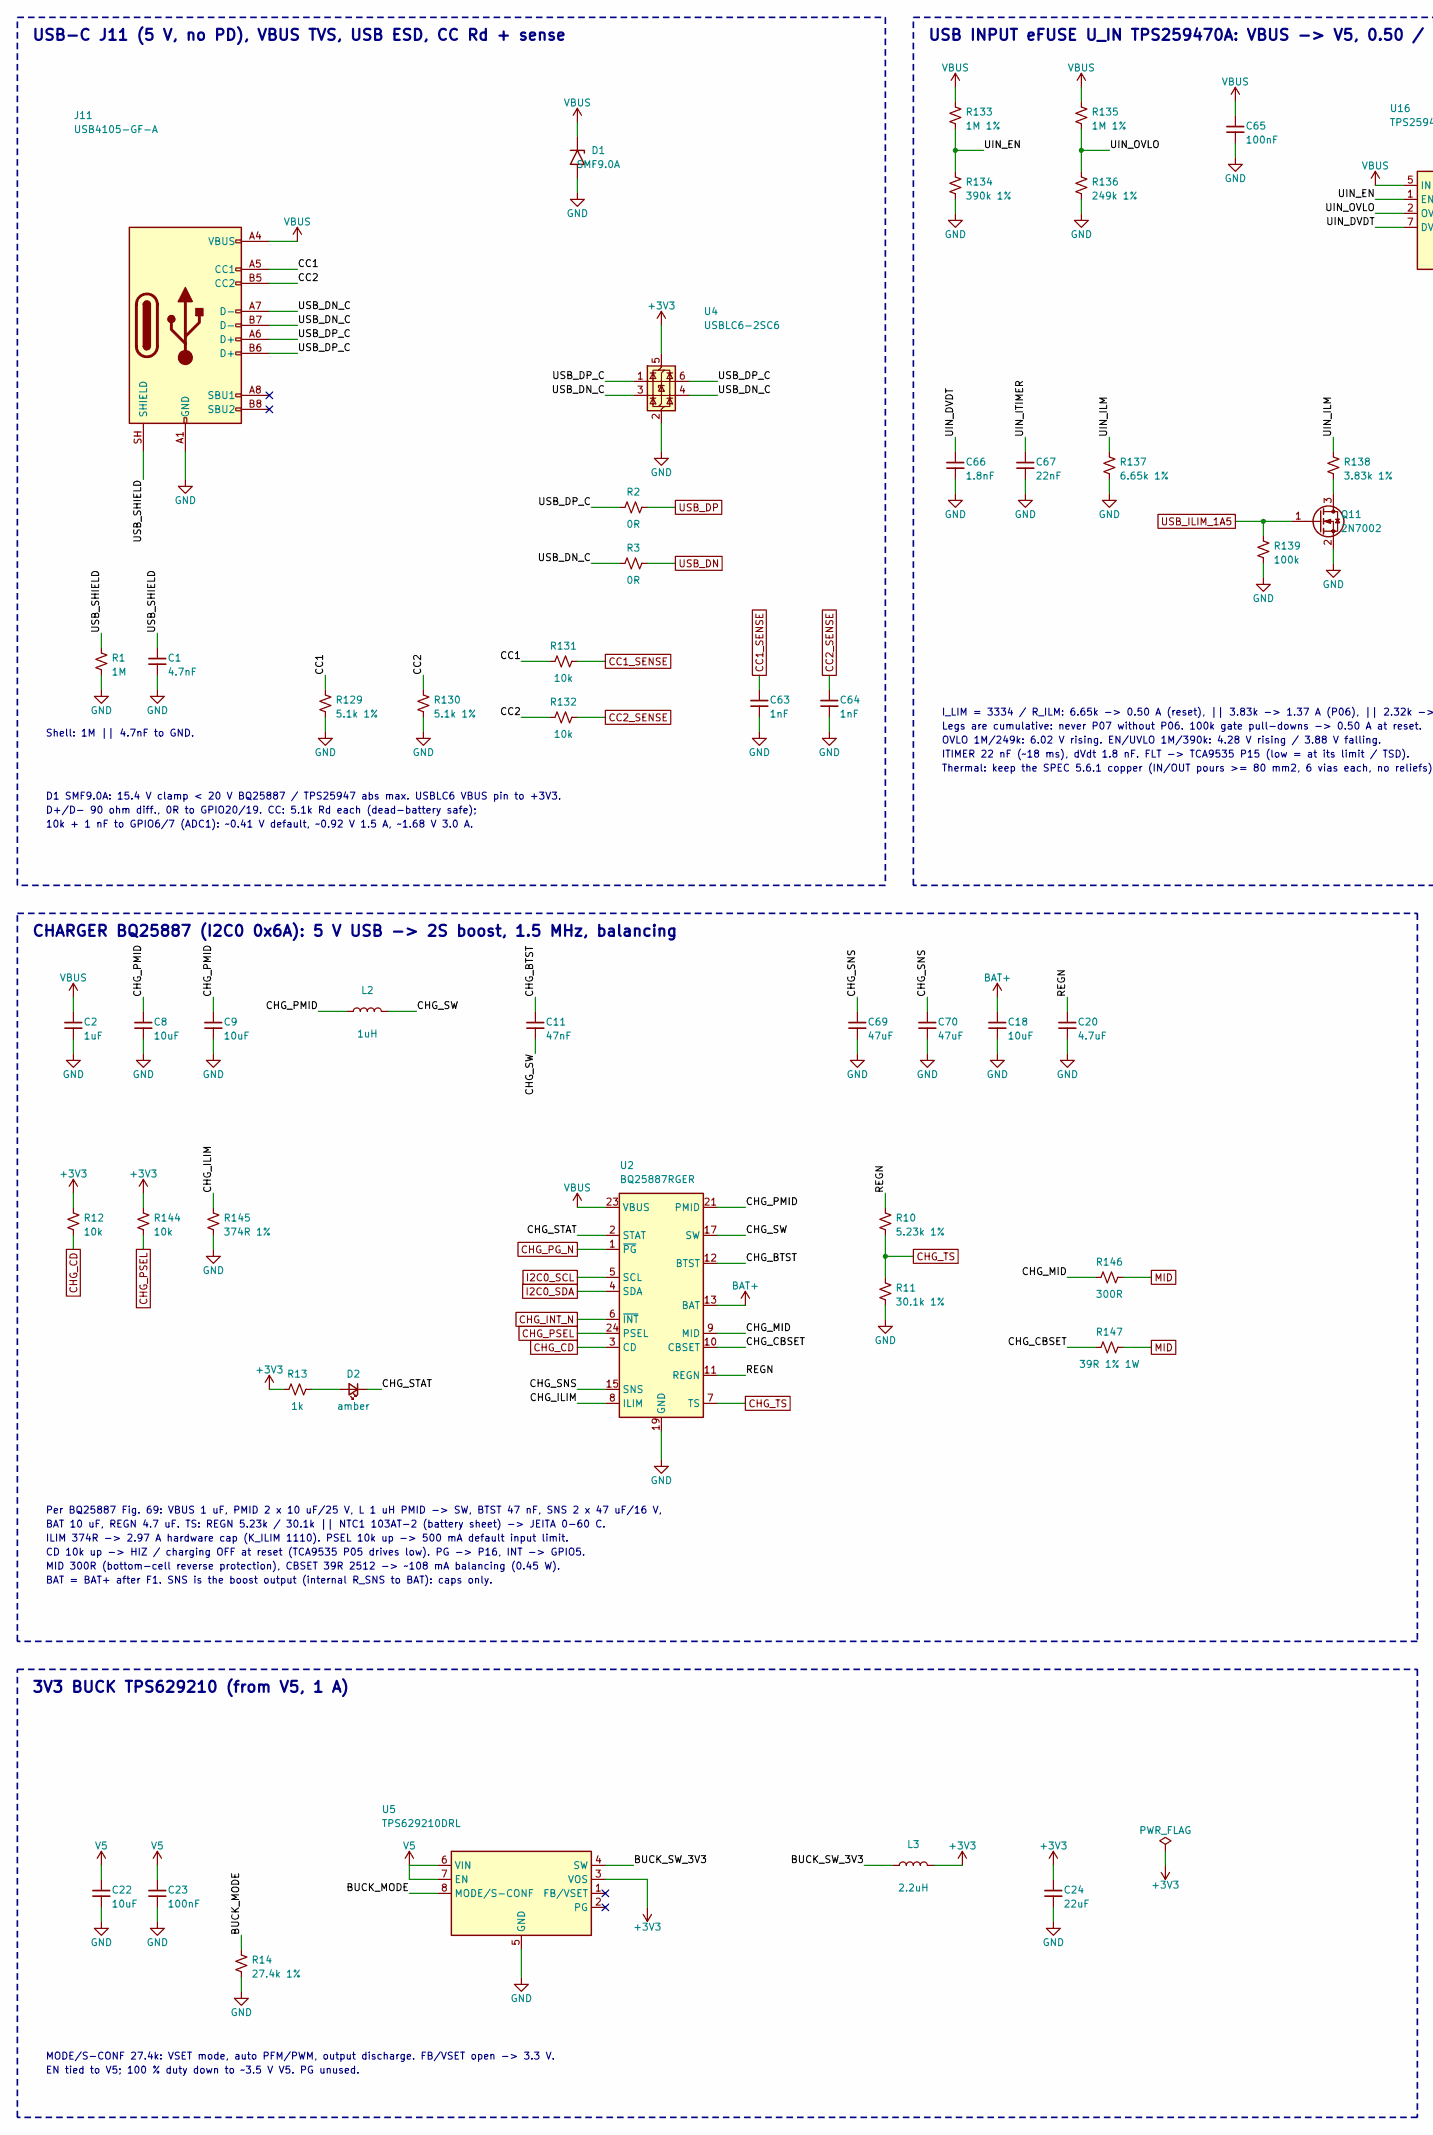
[picture p31: schematic power.kicad_sch, E0005 ESP32-S3 5 V controller, part in row 1, column 1]

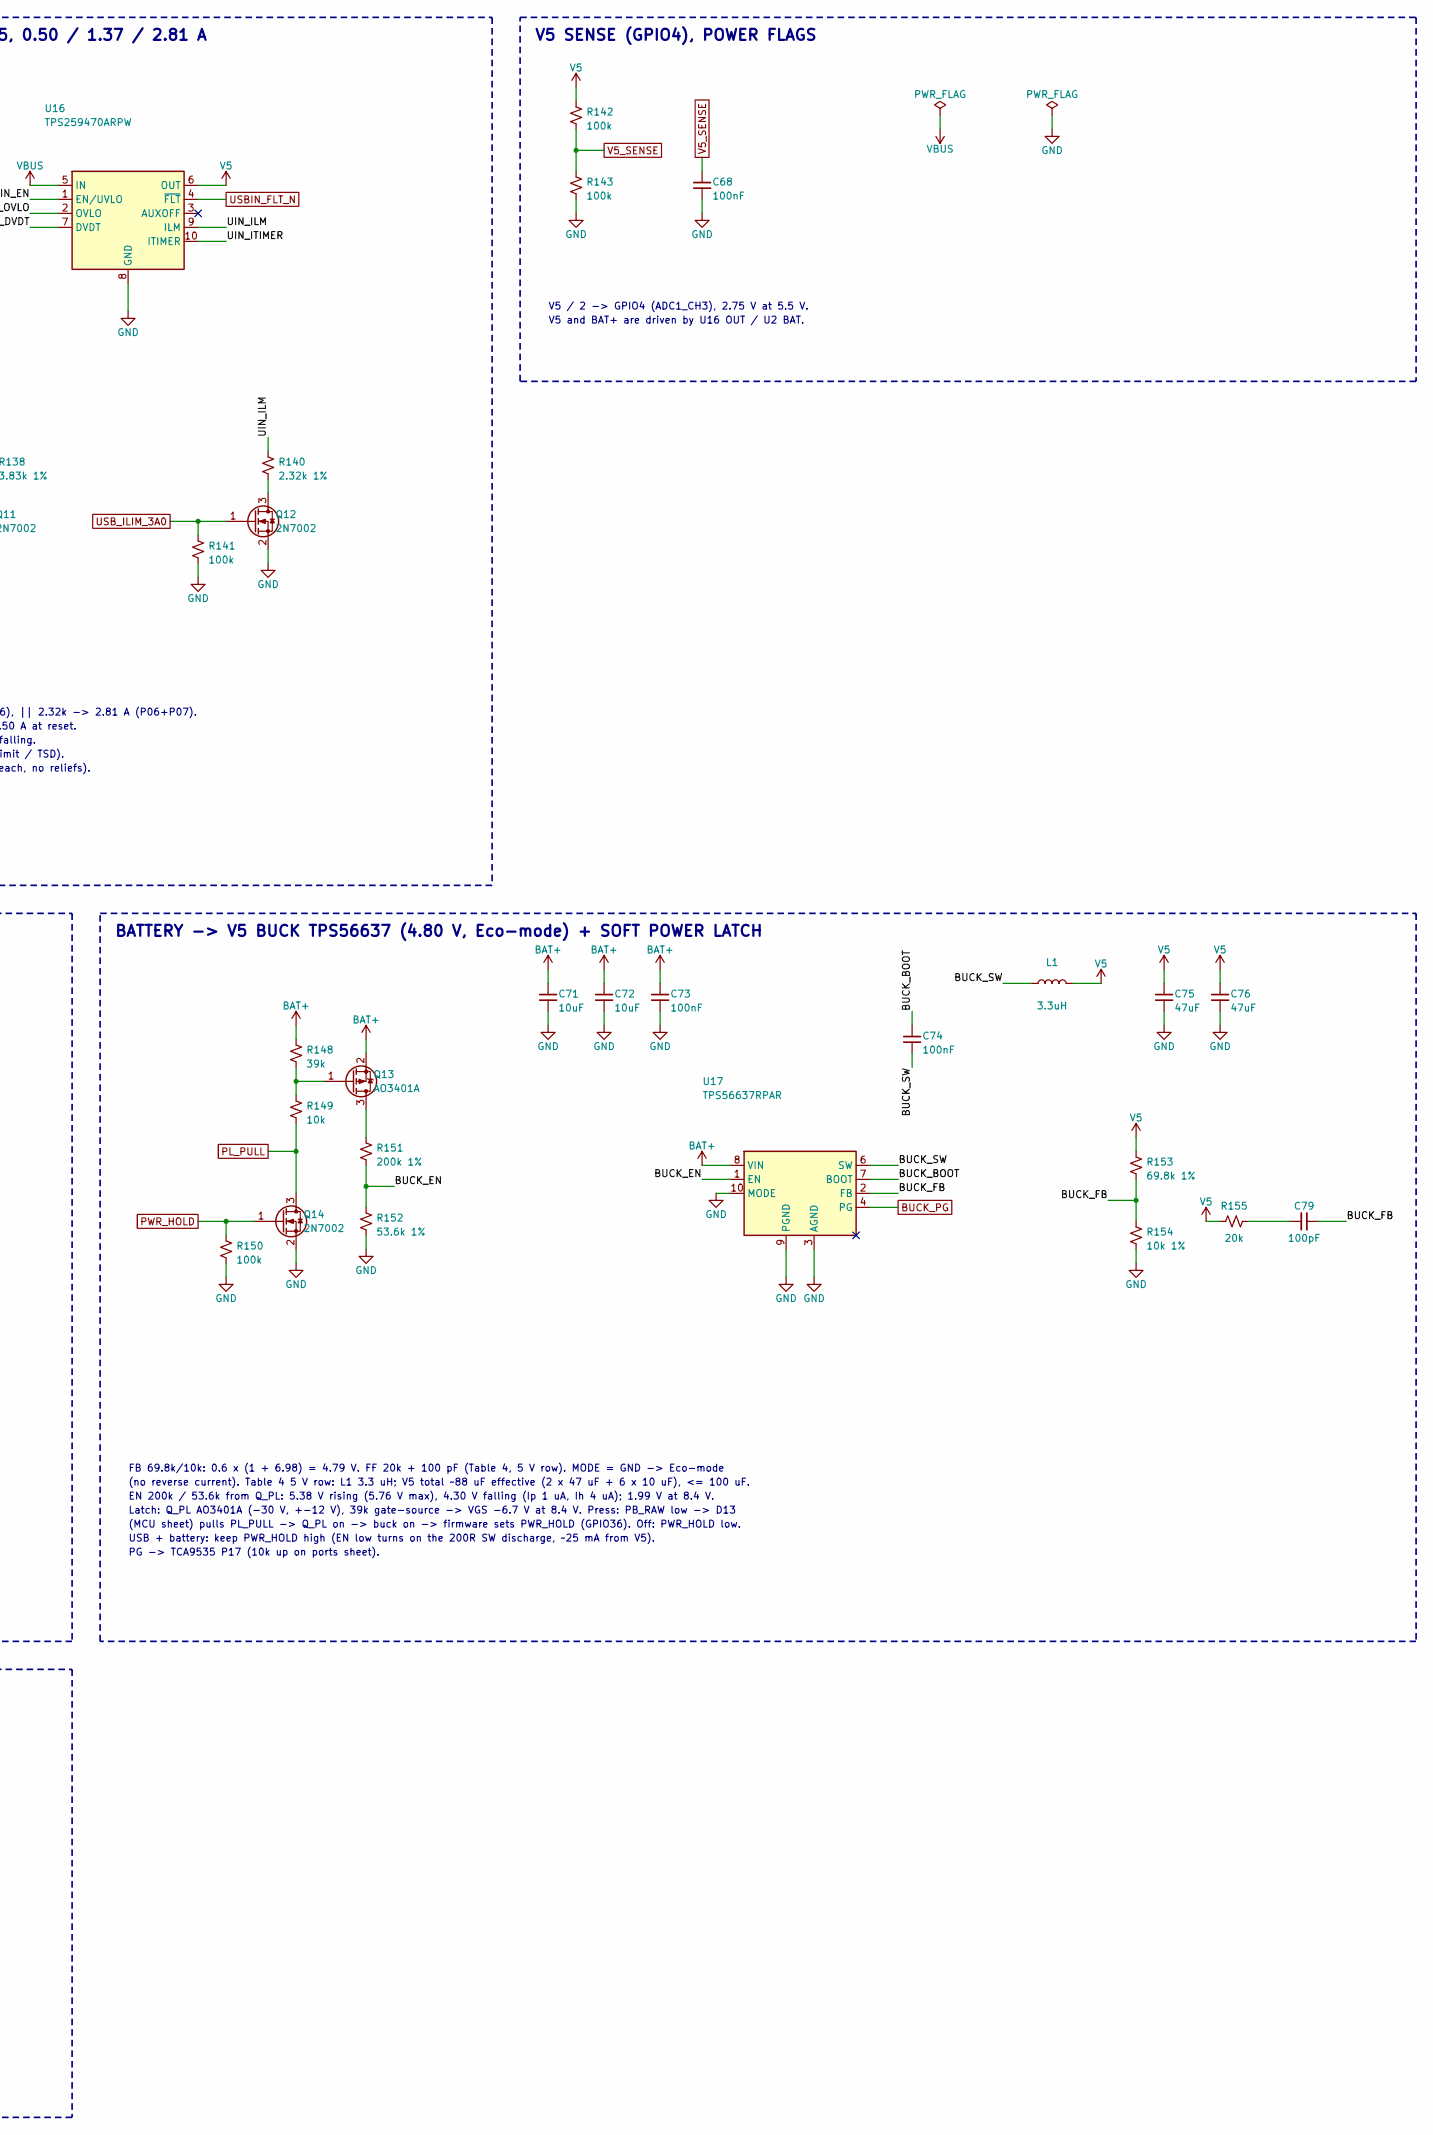
[picture p32: schematic power.kicad_sch, E0005 ESP32-S3 5 V controller, part in row 1, column 2]

Parts:
C1: 4.7nF; C_0402_1005Metric; Voltage 50V; MPN GRM155R71H472KA01J
C2: 1uF; C_0603_1608Metric; Voltage 50V; MPN C1608X7R1H105K080AB
C8, C9, C18, C22, C71, C72: 10uF; C_0805_2012Metric; Voltage 25V; MPN TMK212BBJ106MG-T
C11: 47nF; C_0402_1005Metric; Voltage 50V; MPN GRM155R71H473KE14D
C20: 4.7uF; C_0603_1608Metric; Voltage 25V; MPN GRM188R61E475KE11D
C23, C65, C68, C73, C74: 100nF; C_0402_1005Metric; Voltage 50V; MPN GRM155R71H104KE14D
C24: 22uF; C_0805_2012Metric; Voltage 6.3V; MPN CL21A226KQCLRNC
C63, C64: 1nF; C_0402_1005Metric; MPN GRM155R71H102KA01D
C66: 1.8nF; C_0402_1005Metric; Voltage 50V; MPN C0402C182K5RACTU
C67: 22nF; C_0402_1005Metric; Voltage 50V; MPN GRM155R71H223KA12D
C69, C70, C75, C76: 47uF; C_1210_3225Metric; Voltage 16V; MPN CL32A476KOJNNNE
C79: 100pF; C_0402_1005Metric; MPN GRM1555C1H101JA01D
D1: SMF9.0A; D_SOD-123F; MPN SMF9.0A
D2: amber; LED_0603_1608Metric; MPN LTST-C191KSKT
J11: USB4105-GF-A; USB_C_Receptacle_GCT_USB4105-xx-A_16P_TopMnt_Horizontal; MPN USB4105-GF-A
L1: 3.3uH; L_Vishay_IHLP-3232; MPN IHLP3232DZER3R3M11
L2: 1uH; L_Vishay_IHLP-2525; MPN IHLP2525CZER1R0M01
L3: 2.2uH; L_1008_2520Metric; MPN DFE252012PD-2R2M=P2
Q11, Q12, Q14: 2N7002; SOT-23; MPN 2N7002-7-F
Q13: AO3401A; SOT-23; MPN AO3401A
R1: 1M; R_0402_1005Metric; MPN RC0402FR-071ML
R2, R3: 0R; R_0402_1005Metric; MPN RC0402JR-070RL
R10: 5.23k 1%; R_0402_1005Metric; MPN RC0402FR-075K23L
R11: 30.1k 1%; R_0402_1005Metric; MPN RC0402FR-0730K1L
R12, R131, R132, R144, R149: 10k; R_0402_1005Metric; MPN RC0402FR-0710KL
R13: 1k; R_0402_1005Metric; MPN RC0402FR-071KL
R14: 27.4k 1%; R_0402_1005Metric; MPN RC0402FR-0727K4L
R129, R130: 5.1k 1%; R_0402_1005Metric; MPN RC0402FR-075K1L
R133, R135: 1M 1%; R_0402_1005Metric; MPN RC0402FR-071ML
R134: 390k 1%; R_0402_1005Metric; MPN RC0402FR-07390KL
R136: 249k 1%; R_0402_1005Metric; MPN RC0402FR-07249KL
R137: 6.65k 1%; R_0402_1005Metric; MPN RC0402FR-076K65L
R138: 3.83k 1%; R_0402_1005Metric; MPN RC0402FR-073K83L
R139, R141, R142, R143, R150: 100k; R_0402_1005Metric; MPN RC0402FR-07100KL
R140: 2.32k 1%; R_0402_1005Metric; MPN RC0402FR-072K32L
R145: 374R 1%; R_0402_1005Metric; MPN RC0402FR-07374RL
R146: 300R; R_0402_1005Metric; MPN RC0402FR-07300RL
R147: 39R 1% 1W; R_2512_6332Metric; MPN RMCF2512FT39R0
R148: 39k; R_0402_1005Metric; MPN RC0402FR-0739KL
R151: 200k 1%; R_0402_1005Metric; MPN RC0402FR-07200KL
R152: 53.6k 1%; R_0402_1005Metric; MPN RC0402FR-0753K6L
R153: 69.8k 1%; R_0402_1005Metric; MPN RC0402FR-0769K8L
R154: 10k 1%; R_0402_1005Metric; MPN RC0402FR-0710KL
R155: 20k; R_0402_1005Metric; MPN RC0402FR-0720KL
U2: BQ25887RGER; Texas_RGE0024H_VQFN-24-1EP_4x4mm_P0.5mm_EP2.7x2.7mm; MPN BQ25887RGER
U4: USBLC6-2SC6; SOT-23-6; MPN USBLC6-2SC6
U5: TPS629210DRL; SOT-583-8; MPN TPS629210DRLR
U16: TPS259470ARPW; TI_RPW0010A_VQFN-HR-10_2x2mm_P0.475mm; MPN TPS259470ARPWR
U17: TPS56637RPAR; TI_RPA0010A_VQFN-HR-10_3x3mm; MPN TPS56637RPAR

Connections:
+3V3: C24.1, L3.2, R12.1, R13.1, R144.1, U4.5 (VBUS), U5.3 (VOS); also elsewhere on the board
/Power: USB-C, U_IN, charger, 5 V buck, 3V3/BUCK_BOOT: C74.1, U17.7 (BOOT)
/Power: USB-C, U_IN, charger, 5 V buck, 3V3/BUCK_EN: R151.2, R152.1, U17.1 (EN)
/Power: USB-C, U_IN, charger, 5 V buck, 3V3/BUCK_FB: C79.2, R153.2, R154.1, U17.2 (FB)
/Power: USB-C, U_IN, charger, 5 V buck, 3V3/BUCK_MODE: R14.1, U5.8 (MODE/S-CONF)
/Power: USB-C, U_IN, charger, 5 V buck, 3V3/BUCK_SW: C74.2, L1.1, U17.6 (SW)
/Power: USB-C, U_IN, charger, 5 V buck, 3V3/BUCK_SW_3V3: L3.1, U5.4 (SW)
/Power: USB-C, U_IN, charger, 5 V buck, 3V3/CC1: J11.A5 (CC1), R129.1, R131.1
/Power: USB-C, U_IN, charger, 5 V buck, 3V3/CC2: J11.B5 (CC2), R130.1, R132.1
/Power: USB-C, U_IN, charger, 5 V buck, 3V3/CHG_BTST: C11.1, U2.12 (BTST)
/Power: USB-C, U_IN, charger, 5 V buck, 3V3/CHG_CBSET: R147.1, U2.10 (CBSET)
/Power: USB-C, U_IN, charger, 5 V buck, 3V3/CHG_ILIM: R145.1, U2.8 (ILIM)
/Power: USB-C, U_IN, charger, 5 V buck, 3V3/CHG_MID: R146.1, U2.9 (MID)
/Power: USB-C, U_IN, charger, 5 V buck, 3V3/CHG_PMID: C8.1, C9.1, L2.1, U2.21 (PMID), U2.22 (PMID)
/Power: USB-C, U_IN, charger, 5 V buck, 3V3/CHG_SNS: C69.1, C70.1, U2.15 (SNS), U2.16 (SNS)
/Power: USB-C, U_IN, charger, 5 V buck, 3V3/CHG_STAT: D2.1 (K), U2.2 (STAT)
/Power: USB-C, U_IN, charger, 5 V buck, 3V3/CHG_SW: C11.2, L2.2, U2.17 (SW), U2.18 (SW)
/Power: USB-C, U_IN, charger, 5 V buck, 3V3/REGN: C20.1, R10.1, U2.11 (REGN)
/Power: USB-C, U_IN, charger, 5 V buck, 3V3/UIN_DVDT: C66.1, U16.7 (DVDT)
/Power: USB-C, U_IN, charger, 5 V buck, 3V3/UIN_EN: R133.2, R134.1, U16.1 (EN/UVLO)
/Power: USB-C, U_IN, charger, 5 V buck, 3V3/UIN_ILM: R137.1, R138.1, R140.1, U16.9 (ILM)
/Power: USB-C, U_IN, charger, 5 V buck, 3V3/UIN_ITIMER: C67.1, U16.10 (ITIMER)
/Power: USB-C, U_IN, charger, 5 V buck, 3V3/UIN_OVLO: R135.2, R136.1, U16.2 (OVLO)
/Power: USB-C, U_IN, charger, 5 V buck, 3V3/USB_DN_C: J11.A7 (D-), J11.B7 (D-), R3.1, U4.3 (I/O2), U4.4 (I/O2)
/Power: USB-C, U_IN, charger, 5 V buck, 3V3/USB_DP_C: J11.A6 (D+), J11.B6 (D+), R2.1, U4.1 (I/O1), U4.6 (I/O1)
/Power: USB-C, U_IN, charger, 5 V buck, 3V3/USB_SHIELD: C1.1, J11.SH (SHIELD), R1.1
BAT+: C18.1, C71.1, C72.1, C73.1, Q13.2 (S), R148.1, U2.13 (BAT), U2.14 (BAT), U17.8 (VIN); also elsewhere on the board
BUCK_PG: U17.4 (PG); also elsewhere on the board
CC1_SENSE: C63.1, R131.2; also elsewhere on the board
CC2_SENSE: C64.1, R132.2; also elsewhere on the board
CHG_CD: R12.2, U2.3 (CD); also elsewhere on the board
CHG_INT_N: U2.6 (~INT); also elsewhere on the board
CHG_PG_N: U2.1 (~PG); also elsewhere on the board
CHG_PSEL: R144.2, U2.24 (PSEL)
CHG_TS: R10.2, R11.1, U2.7 (TS); also elsewhere on the board
GND: C1.2, C2.2, C8.2, C9.2, C18.2, C20.2, C22.2, C23.2, C24.2, C63.2, C64.2, C65.2, C66.2, C67.2, C68.2, C69.2, C70.2, C71.2, C72.2, C73.2, C75.2, C76.2, D1.2 (A2), J11.A1 (GND), J11.A12 (GND), J11.B1 (GND), J11.B12 (GND), Q11.2 (S), Q12.2 (S), Q14.2 (S), R1.2, R11.2, R14.2, R129.2, R130.2, R134.2, R136.2, R137.2, R139.2, R141.2, R143.2, R145.2, R150.2, R152.2, R154.2, U2.19 (GND), U2.20 (GND), U2.25 (GND), U4.2 (GND), U5.5 (GND), U16.8 (GND), U17.3 (AGND), U17.9 (PGND), U17.10 (MODE); also elsewhere on the board
I2C0_SCL: U2.5 (SCL); also elsewhere on the board
I2C0_SDA: U2.4 (SDA); also elsewhere on the board
MID: R146.2, R147.2; also elsewhere on the board
unnamed: C79.1, R155.2
unnamed: D2.2 (A), R13.2
unnamed: Q11.3 (D), R138.2
unnamed: Q12.3 (D), R140.2
unnamed: Q13.3 (D), R151.1
unnamed: Q13.1 (G), R148.2, R149.1
PL_PULL: Q14.3 (D), R149.2; also elsewhere on the board
PWR_HOLD: Q14.1 (G), R150.1; also elsewhere on the board
USBIN_FLT_N: U16.4 (~FLT); also elsewhere on the board
USB_DN: R3.2; also elsewhere on the board
USB_DP: R2.2; also elsewhere on the board
USB_ILIM_1A5: Q11.1 (G), R139.1; also elsewhere on the board
USB_ILIM_3A0: Q12.1 (G), R141.1; also elsewhere on the board
V5: C22.1, C23.1, C75.1, C76.1, L1.2, R142.1, R153.1, R155.1, U5.6 (VIN), U5.7 (EN), U16.6 (OUT); also elsewhere on the board
V5_SENSE: C68.1, R142.2, R143.1; also elsewhere on the board
VBUS: C2.1, C65.1, D1.1 (A1), J11.A4 (VBUS), J11.A9 (VBUS), J11.B4 (VBUS), J11.B9 (VBUS), R133.1, R135.1, U2.23 (VBUS), U16.5 (IN)

Notes on the sheet:
USB-C J11 (5 V, no PD), VBUS TVS, USB ESD, CC Rd + sense
Shell: 1M || 4.7nF to GND.
D1 SMF9.0A: 15.4 V clamp < 20 V BQ25887 / TPS25947 abs max. USBLC6 VBUS pin to +3V3.
D+/D- 90 ohm diff., 0R to GPIO20/19. CC: 5.1k Rd each (dead-battery safe);
10k + 1 nF to GPIO6/7 (ADC1): ~0.41 V default, ~0.92 V 1.5 A, ~1.68 V 3.0 A.
USB INPUT eFUSE U_IN TPS259470A: VBUS -> V5, 0.50 / 1.37 / 2.81 A
I_LIM = 3334 / R_ILM: 6.65k -> 0.50 A (reset), || 3.83k -> 1.37 A (P06), || 2.32k -> 2.81 A (P06+P07).
Legs are cumulative: never P07 without P06. 100k gate pull-downs -> 0.50 A at reset.
OVLO 1M/249k: 6.02 V rising. EN/UVLO 1M/390k: 4.28 V rising / 3.88 V falling.
ITIMER 22 nF (~18 ms), dVdt 1.8 nF. FLT -> TCA9535 P15 (low = at its limit / TSD).
Thermal: keep the SPEC 5.6.1 copper (IN/OUT pours >= 80 mm2, 6 vias each, no reliefs).
V5 SENSE (GPIO4), POWER FLAGS
V5 / 2 -> GPIO4 (ADC1_CH3), 2.75 V at 5.5 V.
V5 and BAT+ are driven by U16 OUT / U2 BAT.
CHARGER BQ25887 (I2C0 0x6A): 5 V USB -> 2S boost, 1.5 MHz, balancing
Per BQ25887 Fig. 69: VBUS 1 uF, PMID 2 x 10 uF/25 V, L 1 uH PMID -> SW, BTST 47 nF, SNS 2 x 47 uF/16 V,
BAT 10 uF, REGN 4.7 uF. TS: REGN 5.23k / 30.1k || NTC1 103AT-2 (battery sheet) -> JEITA 0-60 C.
ILIM 374R -> 2.97 A hardware cap (K_ILIM 1110). PSEL 10k up -> 500 mA default input limit.
CD 10k up -> HIZ / charging OFF at reset (TCA9535 P05 drives low). PG -> P16, INT -> GPIO5.
MID 300R (bottom-cell reverse protection), CBSET 39R 2512 -> ~108 mA balancing (0.45 W).
BAT = BAT+ after F1. SNS is the boost output (internal R_SNS to BAT): caps only.
BATTERY -> V5 BUCK TPS56637 (4.80 V, Eco-mode) + SOFT POWER LATCH
FB 69.8k/10k: 0.6 x (1 + 6.98) = 4.79 V. FF 20k + 100 pF (Table 4, 5 V row). MODE = GND -> Eco-mode
(no reverse current). Table 4 5 V row: L1 3.3 uH; V5 total ~88 uF effective (2 x 47 uF + 6 x 10 uF), <= 100 uF.
EN 200k / 53.6k from Q_PL: 5.38 V rising (5.76 V max), 4.30 V falling (Ip 1 uA, Ih 4 uA); 1.99 V at 8.4 V.
Latch: Q_PL AO3401A (-30 V, +-12 V), 39k gate-source -> VGS -6.7 V at 8.4 V. Press: PB_RAW low -> D13
(MCU sheet) pulls PL_PULL -> Q_PL on -> buck on -> firmware sets PWR_HOLD (GPIO36). Off: PWR_HOLD low.
USB + battery: keep PWR_HOLD high (EN low turns on the 200R SW discharge, ~25 mA from V5).
PG -> TCA9535 P17 (10k up on ports sheet).
3V3 BUCK TPS629210 (from V5, 1 A)
MODE/S-CONF 27.4k: VSET mode, auto PFM/PWM, output discharge. FB/VSET open -> 3.3 V.
EN tied to V5; 100 % duty down to ~3.5 V V5. PG unused.

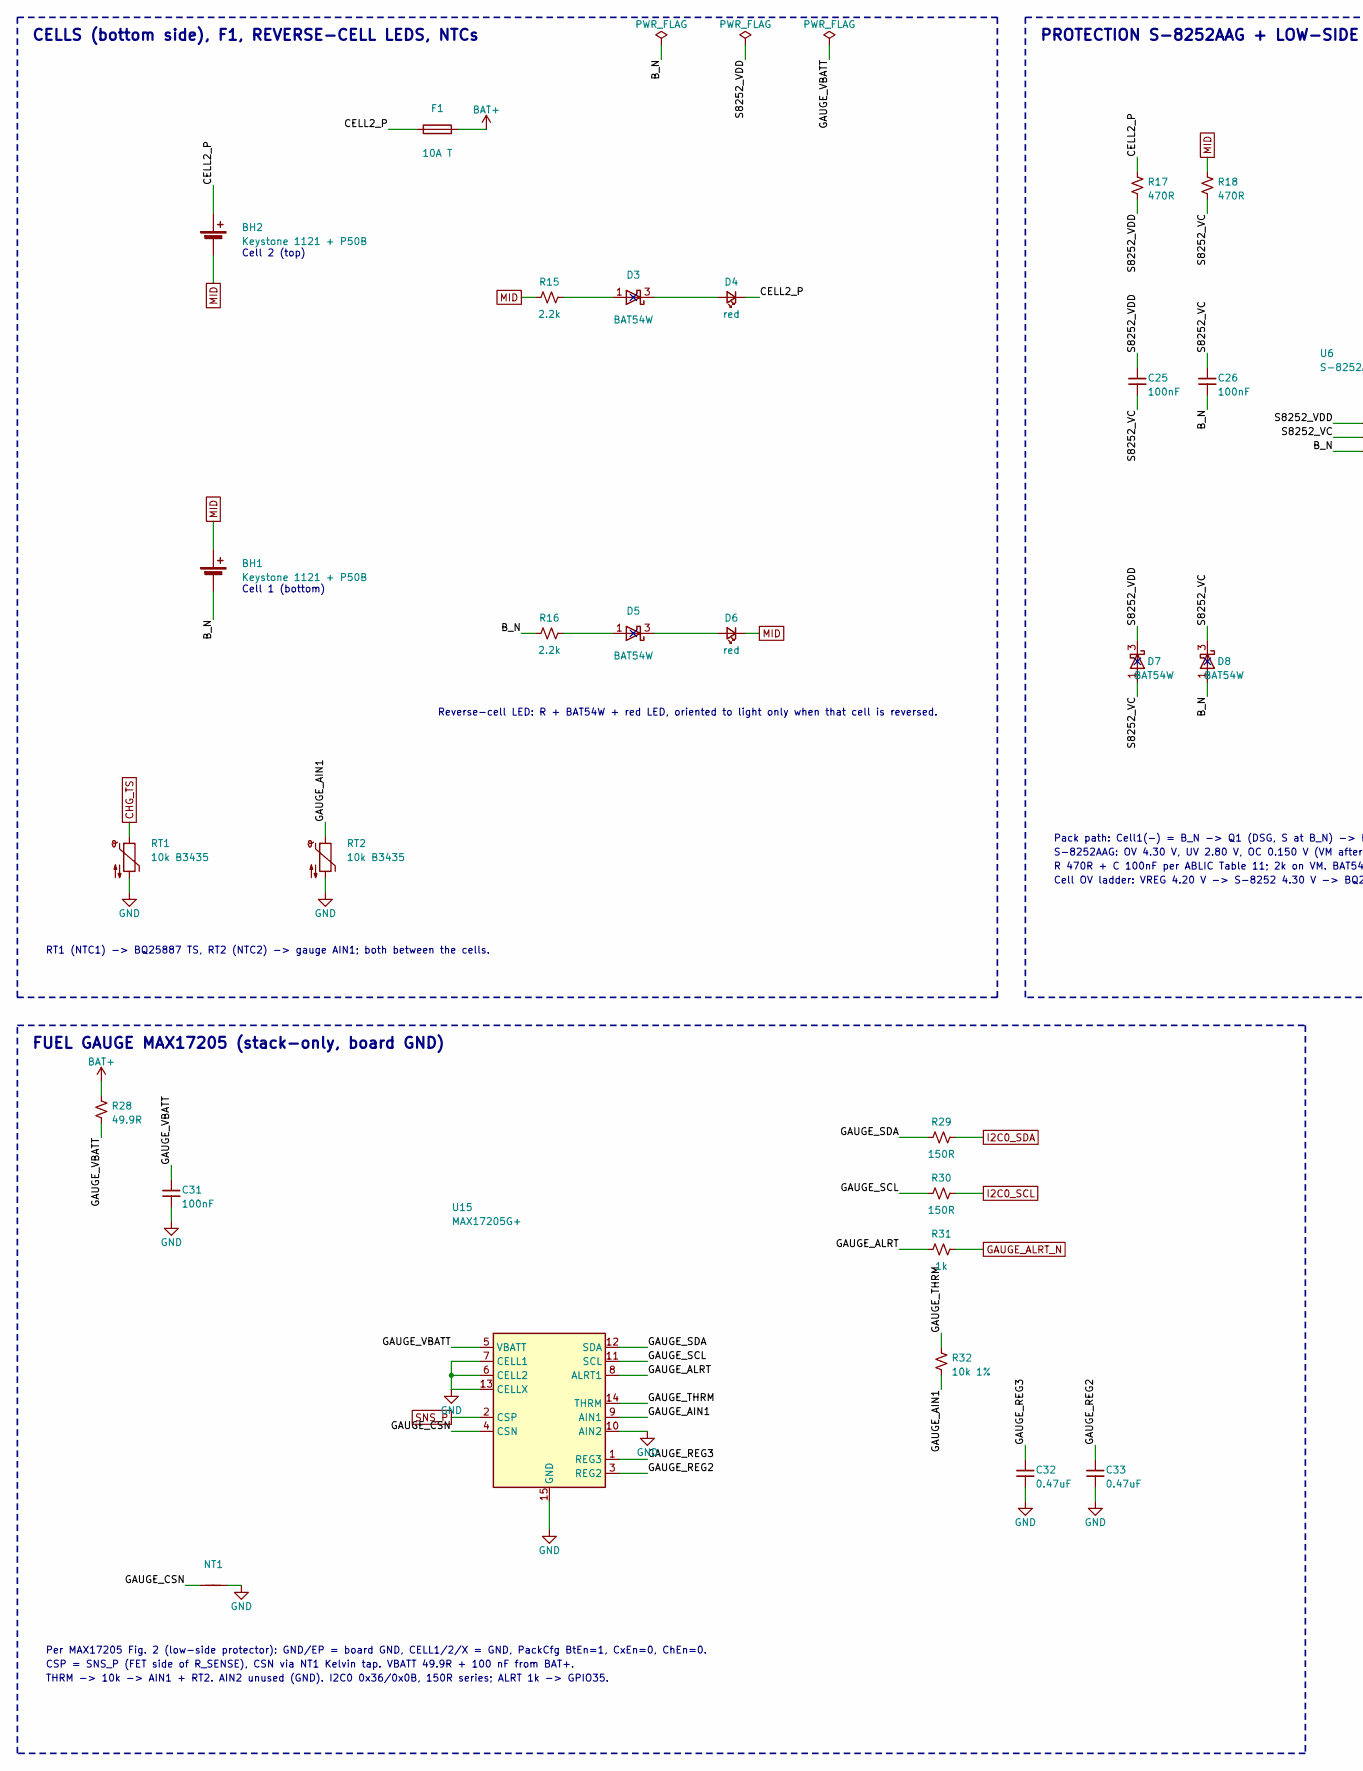
[picture p33: schematic battery.kicad_sch, E0005 ESP32-S3 5 V controller, part in row 1, column 1]

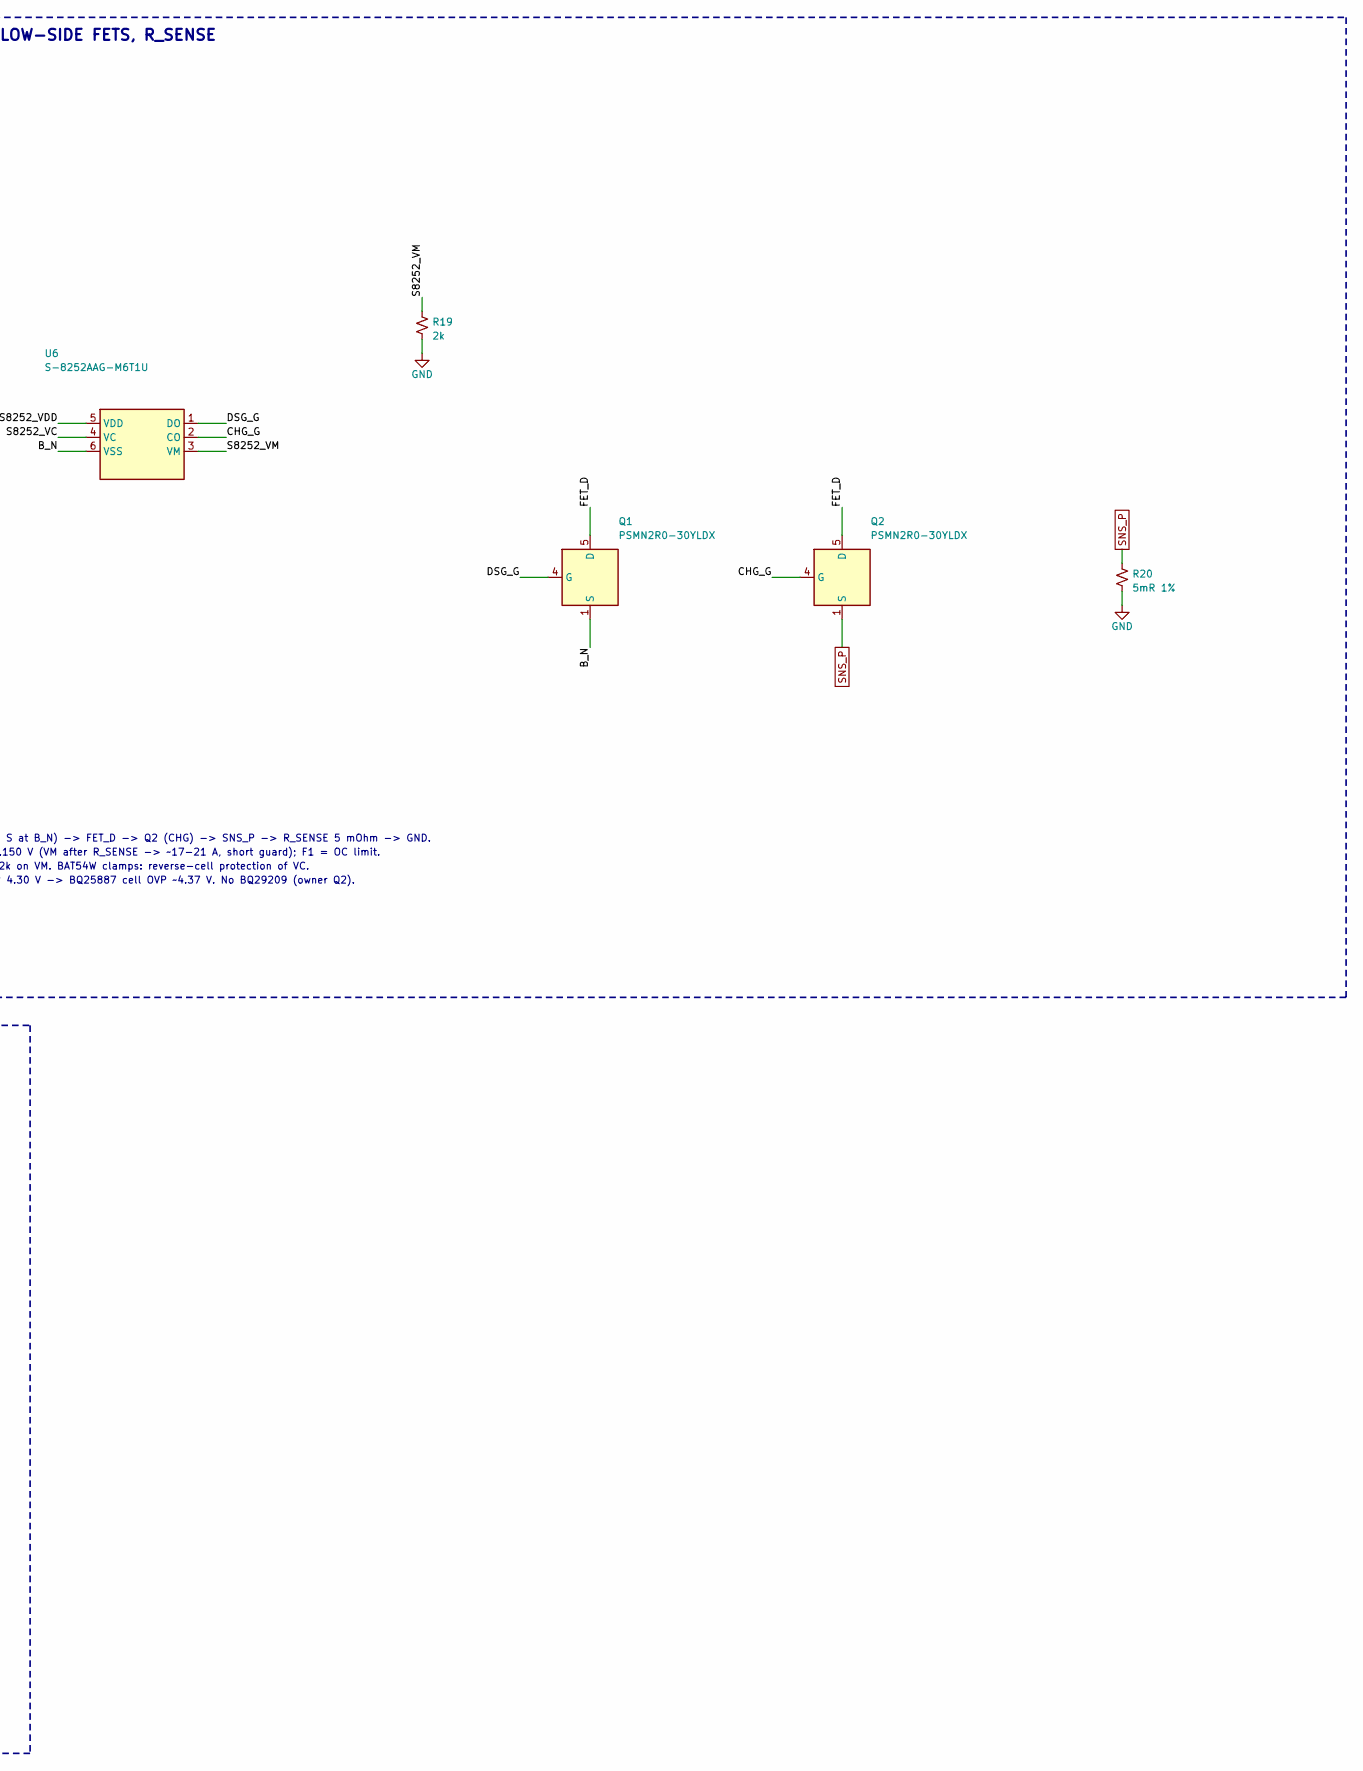
[picture p34: schematic battery.kicad_sch, E0005 ESP32-S3 5 V controller, part in row 1, column 2]

Parts:
BH1, BH2: Keystone 1121 + P50B; Keystone_1121_1x21700_THM; MPN 1121
C25, C26, C31: 100nF; C_0402_1005Metric; Voltage 50V; MPN GRM155R71H104KE14D
C32, C33: 0.47uF; C_0402_1005Metric; MPN GRM155R61A474KE15D
D3, D5, D7, D8: BAT54W; SOT-323_SC-70; MPN BAT54W,135
D4, D6: red; LED_0603_1608Metric; MPN LTST-C191KRKT
F1: 10A T; Fuse_Littelfuse-NANO2-451_453; MPN 0452010.MRL
NT1: NetTie_2; NetTie-2_SMD_Pad0.5mm
Q1, Q2: PSMN2R0-30YLDX; LFPAK56; MPN PSMN2R0-30YLDX
R15, R16: 2.2k; R_0402_1005Metric; MPN RC0402FR-072K2L
R17, R18: 470R; R_0402_1005Metric; MPN RC0402FR-07470RL
R19: 2k; R_0402_1005Metric; MPN RK73H1ETTP2001F
R20: 5mR 1%; R_2512_6332Metric; MPN CRF2512-FZ-R005ELF
R28: 49.9R; R_0402_1005Metric; MPN RC0402FR-0749R9L
R29, R30: 150R; R_0402_1005Metric; MPN RC0402FR-07150RL
R31: 1k; R_0402_1005Metric; MPN RC0402FR-071KL
R32: 10k 1%; R_0402_1005Metric; MPN RC0402FR-0710KL
RT1, RT2: 10k B3435; NTC_Leaded_THT_P2.54mm_Drill0.8mm; MPN 103AT-2
U6: S-8252AAG-M6T1U; SOT-23-6; MPN S-8252AAG-M6T1U
U15: MAX17205G+; TDFN-14-1EP_3x3mm_P0.4mm_EP1.78x2.35mm; MPN MAX17205G+T

Connections:
/Battery pack, protection, gauge/B_N: BH1.2 (-), C26.2, D8.1 (A), Q1.1 (S), Q1.2 (S), Q1.3 (S), R16.1, U6.6 (VSS)
/Battery pack, protection, gauge/CELL2_P: BH2.1 (+), D4.1 (K), F1.1, R17.1
/Battery pack, protection, gauge/CHG_G: Q2.4 (G), U6.2 (CO)
/Battery pack, protection, gauge/DSG_G: Q1.4 (G), U6.1 (DO)
/Battery pack, protection, gauge/FET_D: Q1.5 (D), Q2.5 (D)
/Battery pack, protection, gauge/GAUGE_AIN1: R32.2, RT2.1, U15.9 (AIN1)
/Battery pack, protection, gauge/GAUGE_ALRT: R31.1, U15.8 (ALRT1)
/Battery pack, protection, gauge/GAUGE_CSN: NT1.1, U15.4 (CSN)
/Battery pack, protection, gauge/GAUGE_REG2: C33.1, U15.3 (REG2)
/Battery pack, protection, gauge/GAUGE_REG3: C32.1, U15.1 (REG3)
/Battery pack, protection, gauge/GAUGE_SCL: R30.1, U15.11 (SCL)
/Battery pack, protection, gauge/GAUGE_SDA: R29.1, U15.12 (SDA)
/Battery pack, protection, gauge/GAUGE_THRM: R32.1, U15.14 (THRM)
/Battery pack, protection, gauge/GAUGE_VBATT: C31.1, R28.2, U15.5 (VBATT)
/Battery pack, protection, gauge/S8252_VC: C25.2, C26.1, D7.1 (A), D8.3 (K), R18.2, U6.4 (VC)
/Battery pack, protection, gauge/S8252_VDD: C25.1, D7.3 (K), R17.2, U6.5 (VDD)
/Battery pack, protection, gauge/S8252_VM: R19.1, U6.3 (VM)
BAT+: F1.2, R28.1; also elsewhere on the board
CHG_TS: RT1.1; also elsewhere on the board
GAUGE_ALRT_N: R31.2; also elsewhere on the board
GND: C31.2, C32.2, C33.2, NT1.2, R19.2, R20.2, RT1.2, RT2.2, U15.6 (CELL2), U15.7 (CELL1), U15.10 (AIN2), U15.13 (CELLX), U15.15 (GND); also elsewhere on the board
I2C0_SCL: R30.2; also elsewhere on the board
I2C0_SDA: R29.2; also elsewhere on the board
MID: BH1.1 (+), BH2.2 (-), D6.1 (K), R15.1, R18.1; also elsewhere on the board
unnamed: D3.1 (A), R15.2
unnamed: D3.3 (K), D4.2 (A)
unnamed: D5.1 (A), R16.2
unnamed: D5.3 (K), D6.2 (A)
SNS_P: Q2.1 (S), Q2.2 (S), Q2.3 (S), R20.1, U15.2 (CSP)

Notes on the sheet:
CELLS (bottom side), F1, REVERSE-CELL LEDS, NTCs
Cell 2 (top)
Cell 1 (bottom)
Reverse-cell LED: R + BAT54W + red LED, oriented to light only when that cell is reversed.
RT1 (NTC1) -> BQ25887 TS, RT2 (NTC2) -> gauge AIN1; both between the cells.
PROTECTION S-8252AAG + LOW-SIDE FETS, R_SENSE
Pack path: Cell1(-) = B_N -> Q1 (DSG, S at B_N) -> FET_D -> Q2 (CHG) -> SNS_P -> R_SENSE 5 mOhm -> GND.
S-8252AAG: OV 4.30 V, UV 2.80 V, OC 0.150 V (VM after R_SENSE -> ~17-21 A, short guard); F1 = OC limit.
R 470R + C 100nF per ABLIC Table 11; 2k on VM. BAT54W clamps: reverse-cell protection of VC.
Cell OV ladder: VREG 4.20 V -> S-8252 4.30 V -> BQ25887 cell OVP ~4.37 V. No BQ29209 (owner Q2).
FUEL GAUGE MAX17205 (stack-only, board GND)
Per MAX17205 Fig. 2 (low-side protector): GND/EP = board GND, CELL1/2/X = GND, PackCfg BtEn=1, CxEn=0, ChEn=0.
CSP = SNS_P (FET side of R_SENSE), CSN via NT1 Kelvin tap. VBATT 49.9R + 100 nF from BAT+.
THRM -> 10k -> AIN1 + RT2. AIN2 unused (GND). I2C0 0x36/0x0B, 150R series; ALRT 1k -> GPIO35.
