Karpuls/E0005-esp32-s3-5v-controller/E0005_controller.kicad_pcb

## KiCad design E0005_controller.kicad_pcb (continued)

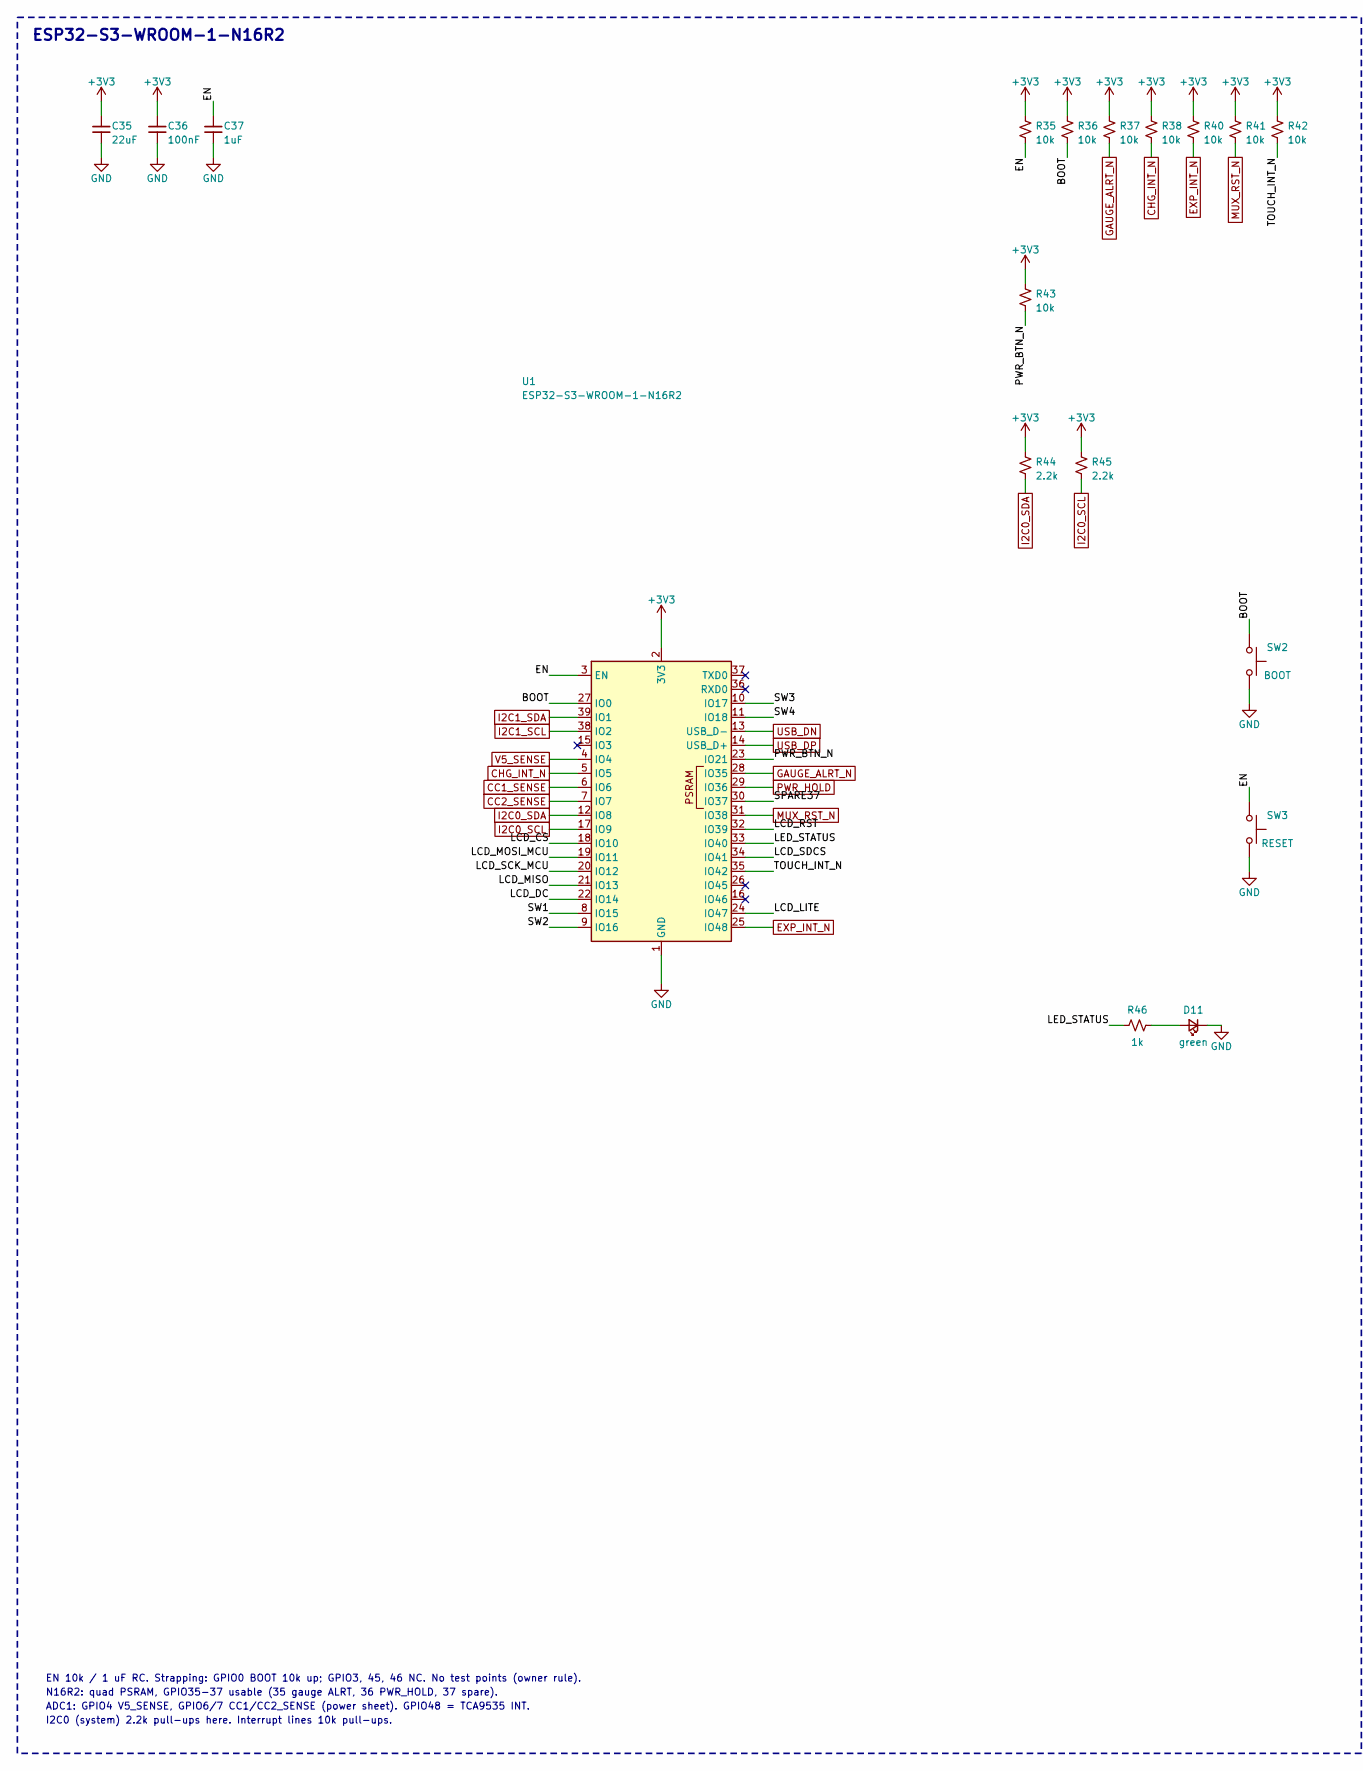
[picture p35: schematic mcu.kicad_sch, E0005 ESP32-S3 5 V controller, part in row 1, column 1]

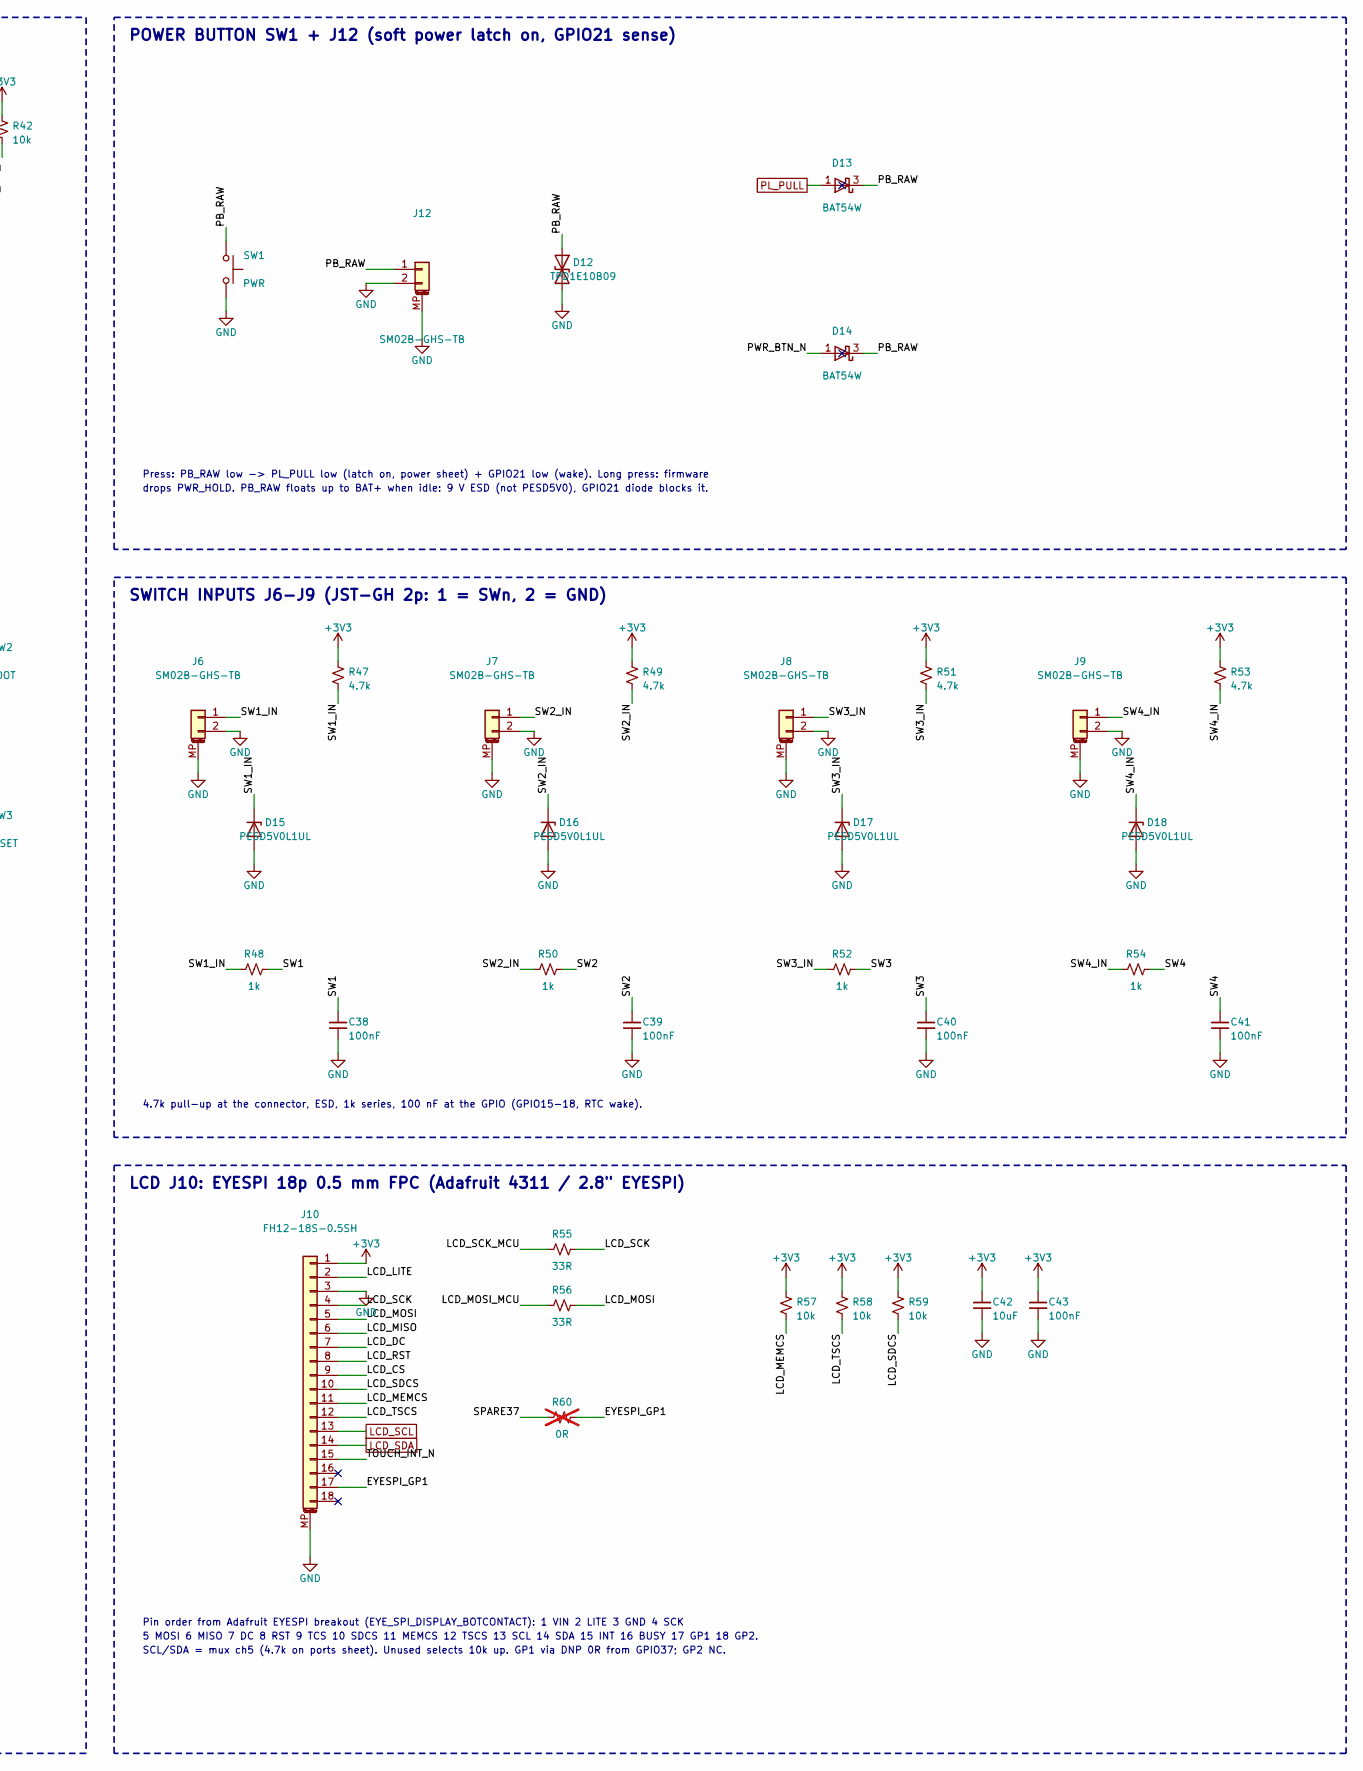
[picture p36: schematic mcu.kicad_sch, E0005 ESP32-S3 5 V controller, part in row 1, column 2]

Parts:
C35: 22uF; C_0805_2012Metric; Voltage 6.3V; MPN CL21A226KQCLRNC
C36, C38, C39, C40, C41, C43: 100nF; C_0402_1005Metric; Voltage 50V; MPN GRM155R71H104KE14D
C37: 1uF; C_0402_1005Metric; MPN CL05A105KP5NNNC
C42: 10uF; C_0805_2012Metric; Voltage 25V; MPN TMK212BBJ106MG-T
D11: green; LED_0603_1608Metric; MPN LTST-C191KGKT
D12: TPD1E10B09; D_0402_1005Metric; MPN TPD1E10B09DPYR
D13, D14: BAT54W; SOT-323_SC-70; MPN BAT54W,135
D15, D16, D17, D18: PESD5V0L1UL; D_SOD-882; MPN PESD5V0L1UL,315
J6, J7, J8, J9, J12: SM02B-GHS-TB; JST_GH_SM02B-GHS-TB_1x02-1MP_P1.25mm_Horizontal; MPN SM02B-GHS-TB
J10: FH12-18S-0.5SH; Hirose_FH12-18S-0.5SH_1x18-1MP_P0.50mm_Horizontal; MPN FH12-18S-0.5SH(55)
R35, R36, R37, R38, R40, R41, R42, R43, R57, R58, R59: 10k; R_0402_1005Metric; MPN RC0402FR-0710KL
R44, R45: 2.2k; R_0402_1005Metric; MPN RC0402FR-072K2L
R46, R48, R50, R52, R54: 1k; R_0402_1005Metric; MPN RC0402FR-071KL
R47, R49, R51, R53: 4.7k; R_0402_1005Metric; MPN RK73H1ETTP4701F
R55, R56: 33R; R_0402_1005Metric; MPN RC0402FR-0733RL
R60: 0R; R_0402_1005Metric; MPN RC0402JR-070RL; not fitted
SW1: PWR; SW_SPST_PTS810; MPN PTS810SJM250SMTR LFS
SW2: BOOT; SW_SPST_PTS810; MPN PTS810SJM250SMTR LFS
SW3: RESET; SW_SPST_PTS810; MPN PTS810SJM250SMTR LFS
U1: ESP32-S3-WROOM-1-N16R2; ESP32-S3-WROOM-1; MPN ESP32-S3-WROOM-1-N16R2

Connections:
+3V3: C35.1, C36.1, C42.1, C43.1, J10.1, R35.1, R36.1, R37.1, R38.1, R40.1, R41.1, R42.1, R43.1, R44.1, R45.1, R47.1, R49.1, R51.1, R53.1, R57.1, R58.1, R59.1, U1.2 (3V3); also elsewhere on the board
/MCU, UI, LCD, switches/BOOT: R36.2, SW2.1, U1.27 (IO0)
/MCU, UI, LCD, switches/EN: C37.1, R35.2, SW3.1, U1.3 (EN)
/MCU, UI, LCD, switches/EYESPI_GP1: J10.17, R60.2
/MCU, UI, LCD, switches/LCD_CS: J10.9, U1.18 (IO10)
/MCU, UI, LCD, switches/LCD_DC: J10.7, U1.22 (IO14)
/MCU, UI, LCD, switches/LCD_LITE: J10.2, U1.24 (IO47)
/MCU, UI, LCD, switches/LCD_MEMCS: J10.11, R57.2
/MCU, UI, LCD, switches/LCD_MISO: J10.6, U1.21 (IO13)
/MCU, UI, LCD, switches/LCD_MOSI: J10.5, R56.2
/MCU, UI, LCD, switches/LCD_MOSI_MCU: R56.1, U1.19 (IO11)
/MCU, UI, LCD, switches/LCD_RST: J10.8, U1.32 (IO39)
/MCU, UI, LCD, switches/LCD_SCK: J10.4, R55.2
/MCU, UI, LCD, switches/LCD_SCK_MCU: R55.1, U1.20 (IO12)
/MCU, UI, LCD, switches/LCD_SDCS: J10.10, R59.2, U1.34 (IO41)
/MCU, UI, LCD, switches/LCD_TSCS: J10.12, R58.2
/MCU, UI, LCD, switches/LED_STATUS: R46.1, U1.33 (IO40)
/MCU, UI, LCD, switches/PB_RAW: D12.1 (A1), D13.3 (K), D14.3 (K), J12.1, SW1.1
/MCU, UI, LCD, switches/PWR_BTN_N: D14.1 (A), R43.2, U1.23 (IO21)
/MCU, UI, LCD, switches/SPARE37: R60.1, U1.30 (IO37)
/MCU, UI, LCD, switches/SW1: C38.1, R48.2, U1.8 (IO15)
/MCU, UI, LCD, switches/SW1_IN: D15.1 (K), J6.1, R47.2, R48.1
/MCU, UI, LCD, switches/SW2: C39.1, R50.2, U1.9 (IO16)
/MCU, UI, LCD, switches/SW2_IN: D16.1 (K), J7.1, R49.2, R50.1
/MCU, UI, LCD, switches/SW3: C40.1, R52.2, U1.10 (IO17)
/MCU, UI, LCD, switches/SW3_IN: D17.1 (K), J8.1, R51.2, R52.1
/MCU, UI, LCD, switches/SW4: C41.1, R54.2, U1.11 (IO18)
/MCU, UI, LCD, switches/SW4_IN: D18.1 (K), J9.1, R53.2, R54.1
/MCU, UI, LCD, switches/TOUCH_INT_N: J10.15, R42.2, U1.35 (IO42)
CC1_SENSE: U1.6 (IO6); also elsewhere on the board
CC2_SENSE: U1.7 (IO7); also elsewhere on the board
CHG_INT_N: R38.2, U1.5 (IO5); also elsewhere on the board
EXP_INT_N: R40.2, U1.25 (IO48); also elsewhere on the board
GAUGE_ALRT_N: R37.2, U1.28 (IO35); also elsewhere on the board
GND: C35.2, C36.2, C37.2, C38.2, C39.2, C40.2, C41.2, C42.2, C43.2, D11.1 (K), D12.2 (A2), D15.2 (A), D16.2 (A), D17.2 (A), D18.2 (A), J6.2, J6.MP (MountPin), J7.2, J7.MP (MountPin), J8.2, J8.MP (MountPin), J9.2, J9.MP (MountPin), J10.3, J10.MP (MountPin), J12.2, J12.MP (MountPin), SW1.2, SW2.2, SW3.2, U1.1 (GND), U1.40 (GND), U1.41 (GND); also elsewhere on the board
I2C0_SCL: R45.2, U1.17 (IO9); also elsewhere on the board
I2C0_SDA: R44.2, U1.12 (IO8); also elsewhere on the board
I2C1_SCL: U1.38 (IO2); also elsewhere on the board
I2C1_SDA: U1.39 (IO1); also elsewhere on the board
LCD_SCL: J10.13; also elsewhere on the board
LCD_SDA: J10.14; also elsewhere on the board
MUX_RST_N: R41.2, U1.31 (IO38); also elsewhere on the board
unnamed: D11.2 (A), R46.2
PL_PULL: D13.1 (A); also elsewhere on the board
PWR_HOLD: U1.29 (IO36); also elsewhere on the board
USB_DN: U1.13 (USB_D-); also elsewhere on the board
USB_DP: U1.14 (USB_D+); also elsewhere on the board
V5_SENSE: U1.4 (IO4); also elsewhere on the board

Notes on the sheet:
ESP32-S3-WROOM-1-N16R2
EN 10k / 1 uF RC. Strapping: GPIO0 BOOT 10k up; GPIO3, 45, 46 NC. No test points (owner rule).
N16R2: quad PSRAM, GPIO35-37 usable (35 gauge ALRT, 36 PWR_HOLD, 37 spare).
ADC1: GPIO4 V5_SENSE, GPIO6/7 CC1/CC2_SENSE (power sheet). GPIO48 = TCA9535 INT.
I2C0 (system) 2.2k pull-ups here. Interrupt lines 10k pull-ups.
POWER BUTTON SW1 + J12 (soft power latch on, GPIO21 sense)
Press: PB_RAW low -> PL_PULL low (latch on, power sheet) + GPIO21 low (wake). Long press: firmware
drops PWR_HOLD. PB_RAW floats up to BAT+ when idle: 9 V ESD (not PESD5V0), GPIO21 diode blocks it.
SWITCH INPUTS J6-J9 (JST-GH 2p: 1 = SWn, 2 = GND)
4.7k pull-up at the connector, ESD, 1k series, 100 nF at the GPIO (GPIO15-18, RTC wake).
LCD J10: EYESPI 18p 0.5 mm FPC (Adafruit 4311 / 2.8" EYESPI)
Pin order from Adafruit EYESPI breakout (EYE_SPI_DISPLAY_BOTCONTACT): 1 VIN 2 LITE 3 GND 4 SCK
5 MOSI 6 MISO 7 DC 8 RST 9 TCS 10 SDCS 11 MEMCS 12 TSCS 13 SCL 14 SDA 15 INT 16 BUSY 17 GP1 18 GP2.
SCL/SDA = mux ch5 (4.7k on ports sheet). Unused selects 10k up. GP1 via DNP 0R from GPIO37; GP2 NC.

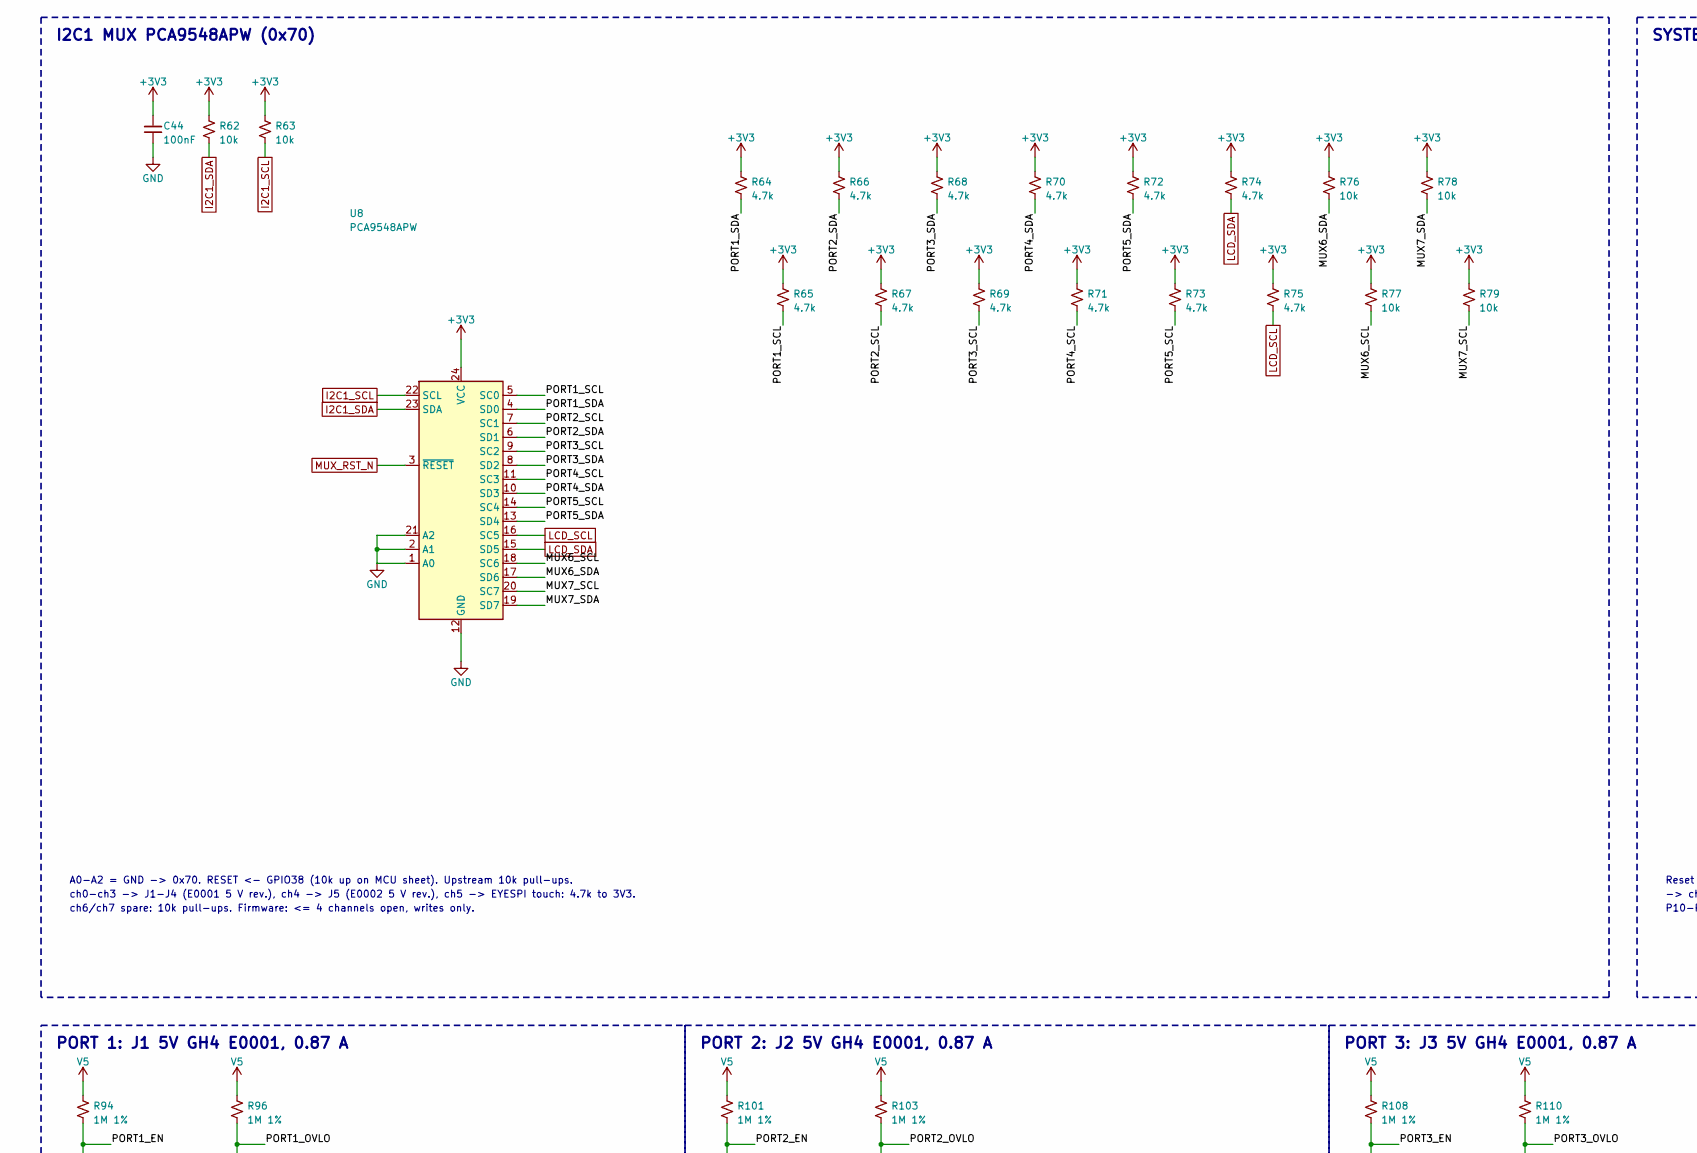
[picture p37: schematic ports.kicad_sch, E0005 ESP32-S3 5 V controller, part in row 1, column 1]

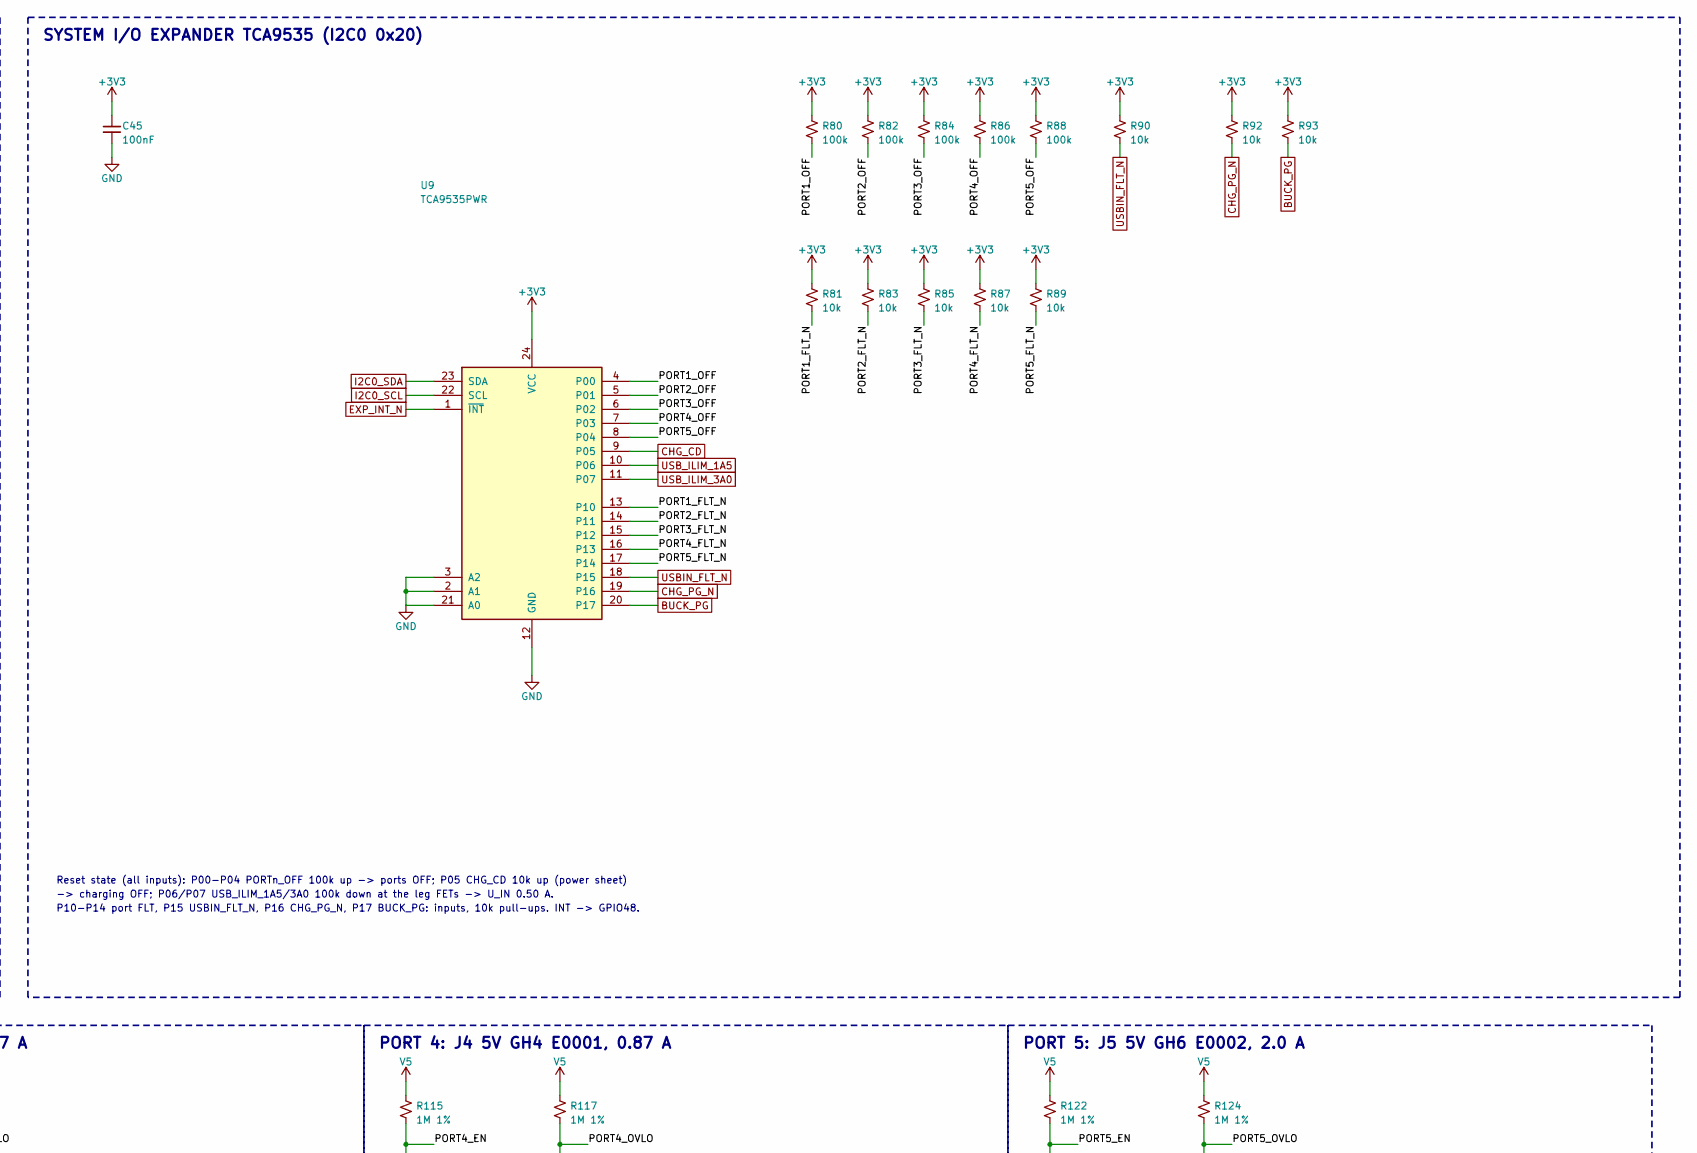
[picture p38: schematic ports.kicad_sch, E0005 ESP32-S3 5 V controller, part in row 1, column 2]

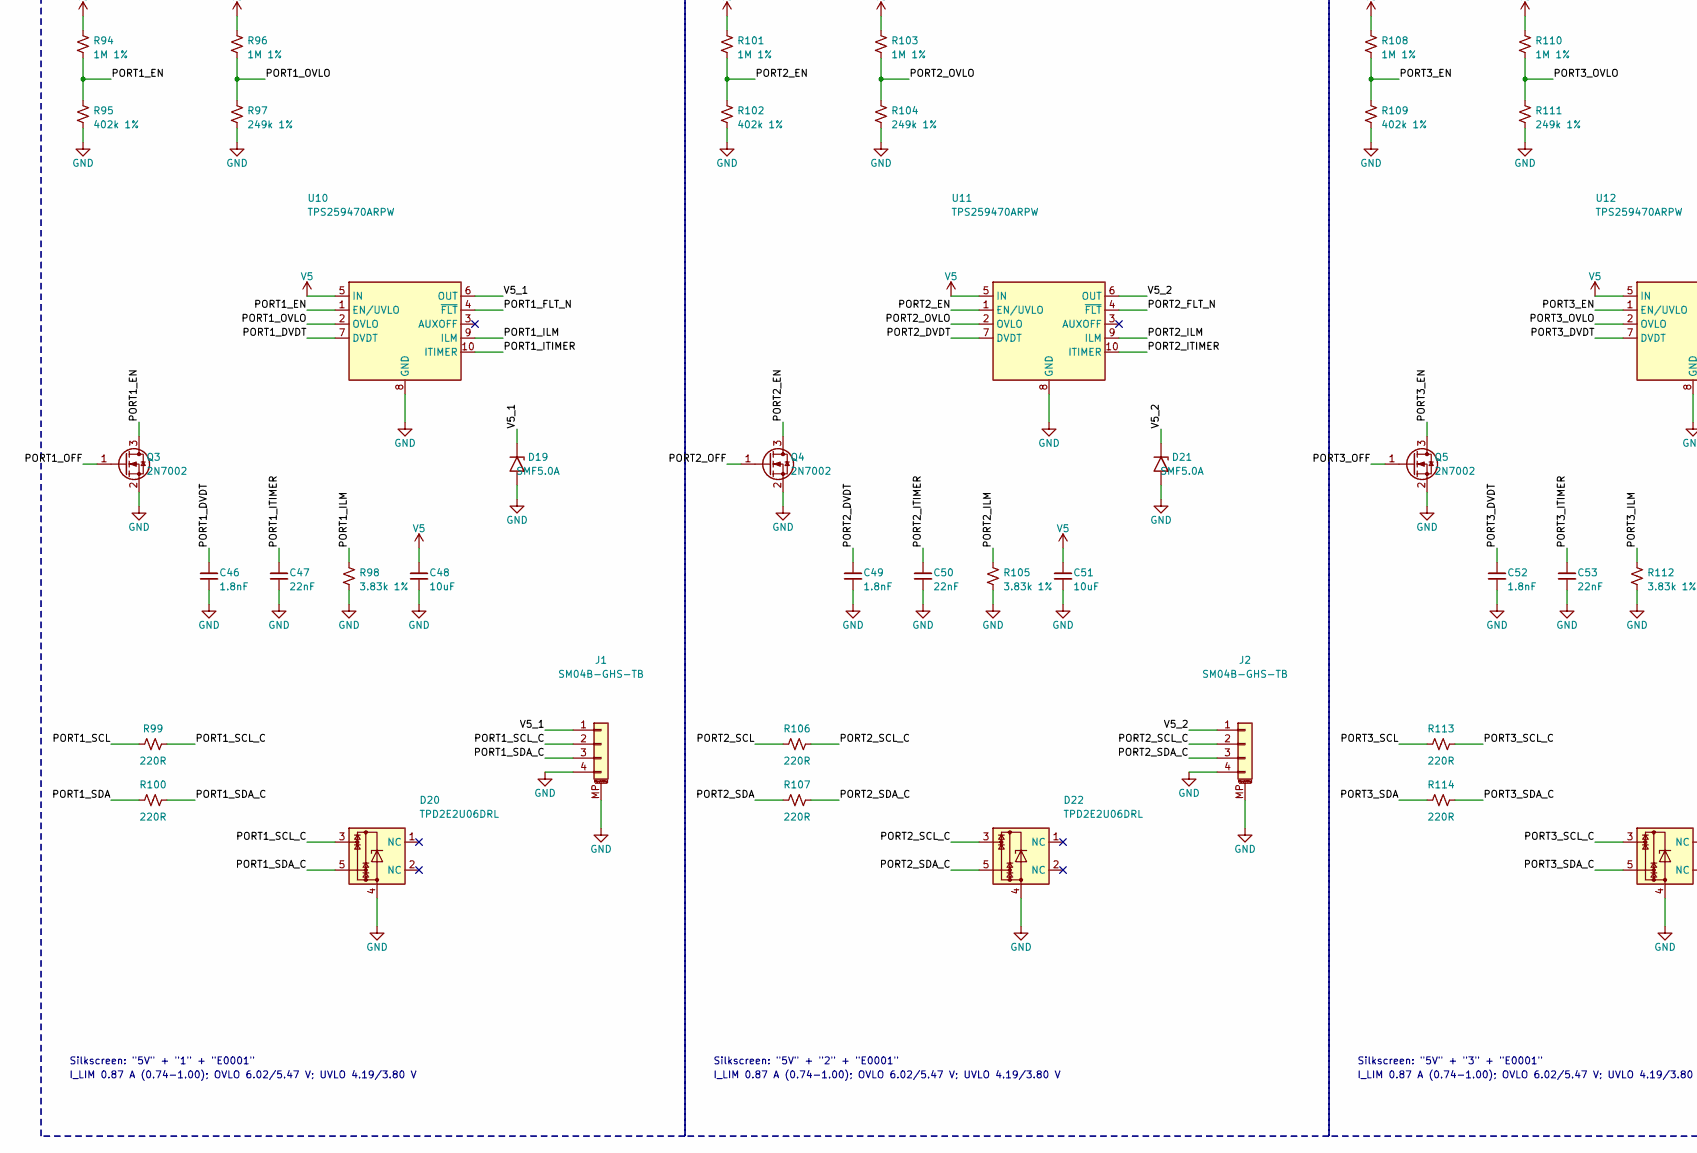
[picture p39: schematic ports.kicad_sch, E0005 ESP32-S3 5 V controller, part in row 2, column 1]

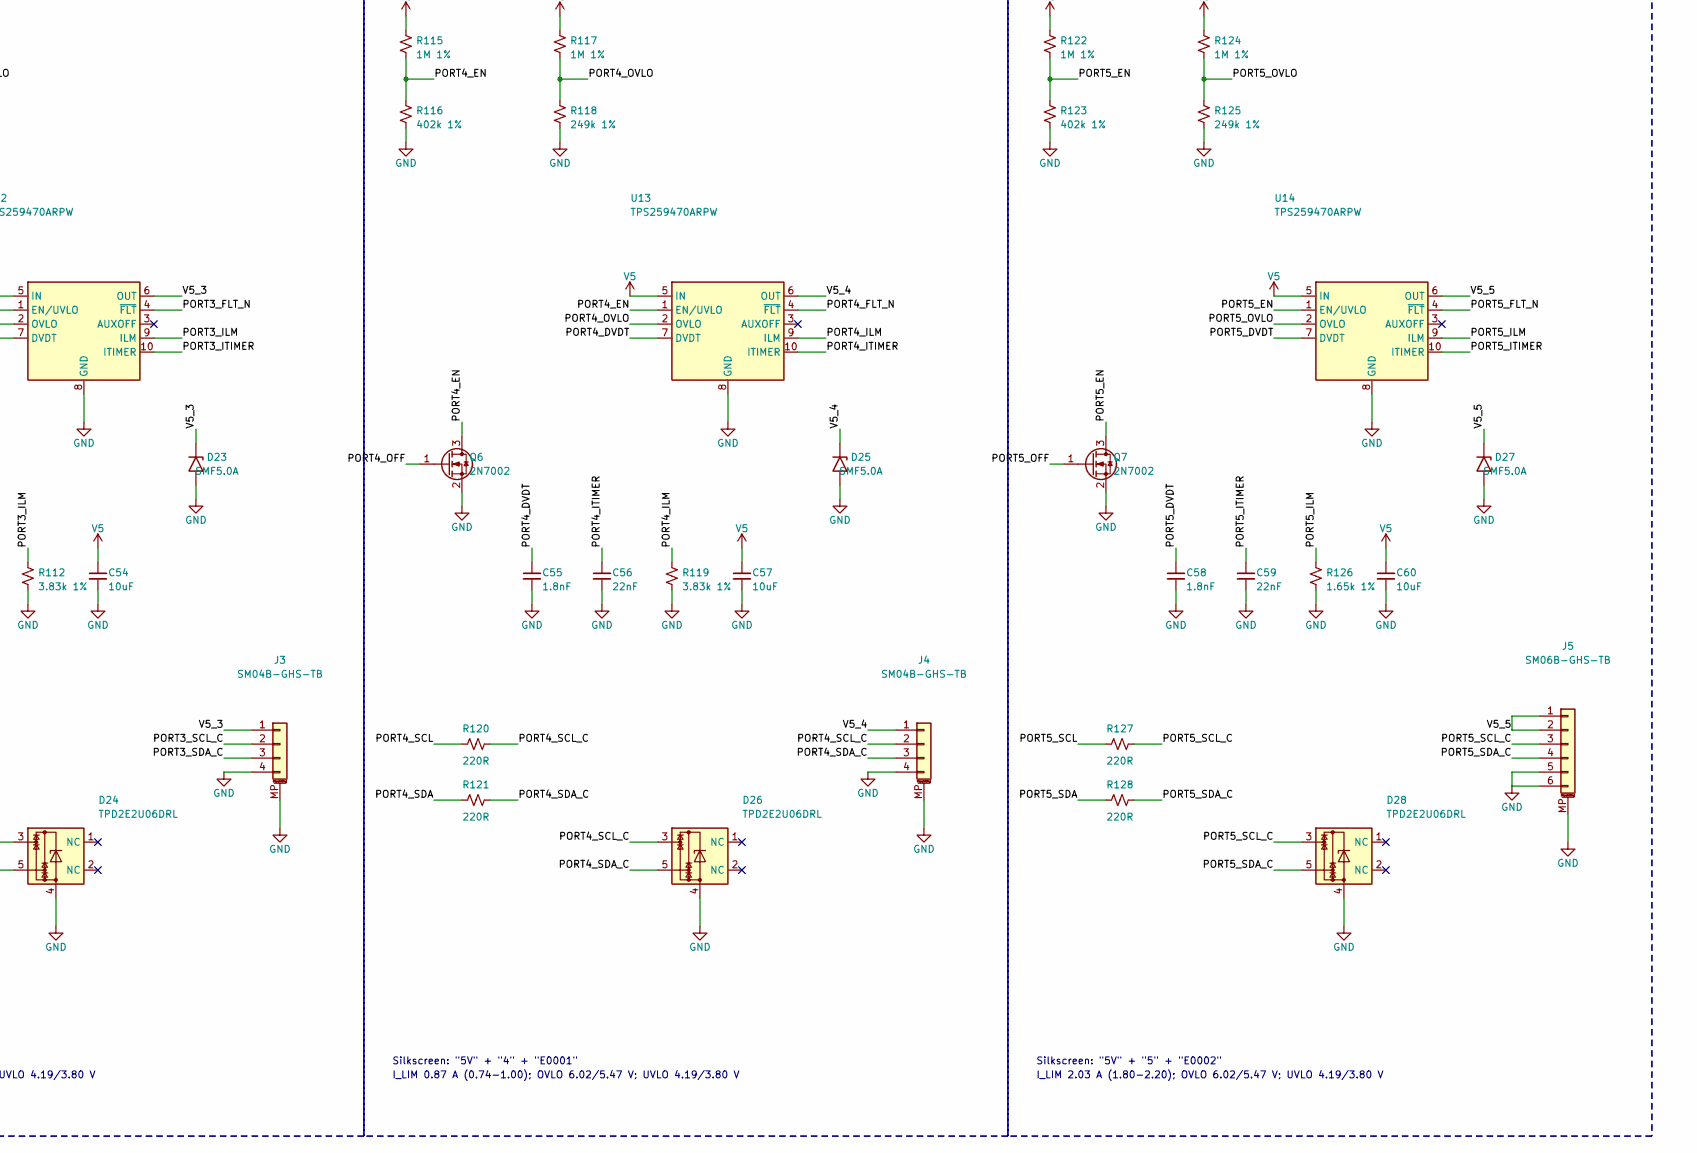
[picture p40: schematic ports.kicad_sch, E0005 ESP32-S3 5 V controller, part in row 2, column 2]

Parts:
C44, C45: 100nF; C_0402_1005Metric; Voltage 50V; MPN GRM155R71H104KE14D
C46, C49, C52, C55, C58: 1.8nF; C_0402_1005Metric; Voltage 50V; MPN C0402C182K5RACTU
C47, C50, C53, C56, C59: 22nF; C_0402_1005Metric; Voltage 50V; MPN GRM155R71H223KA12D
C48, C51, C54, C57, C60: 10uF; C_0805_2012Metric; Voltage 25V; MPN TMK212BBJ106MG-T
D19, D21, D23, D25, D27: SMF5.0A; D_SOD-123F; MPN SMF5.0A
D20, D22, D24, D26, D28: TPD2E2U06DRL; SOT-553; MPN TPD2E2U06DRLR
J1, J2, J3, J4: SM04B-GHS-TB; JST_GH_SM04B-GHS-TB_1x04-1MP_P1.25mm_Horizontal; MPN SM04B-GHS-TB
J5: SM06B-GHS-TB; JST_GH_SM06B-GHS-TB_1x06-1MP_P1.25mm_Horizontal; MPN SM06B-GHS-TB(LF)(SN)
Q3, Q4, Q5, Q6, Q7: 2N7002; SOT-23; MPN 2N7002-7-F
R62, R63, R76, R77, R78, R79, R81, R83, R85, R87, R89, R90, R92, R93: 10k; R_0402_1005Metric; MPN RC0402FR-0710KL
R64, R65, R66, R67, R68, R69, R70, R71, R72, R73, R74, R75: 4.7k; R_0402_1005Metric; MPN RK73H1ETTP4701F
R80, R82, R84, R86, R88: 100k; R_0402_1005Metric; MPN RC0402FR-07100KL
R94, R96, R101, R103, R108, R110, R115, R117, R122, R124: 1M 1%; R_0402_1005Metric; MPN RC0402FR-071ML
R95, R102, R109, R116, R123: 402k 1%; R_0402_1005Metric; MPN RC0402FR-07402KL
R97, R104, R111, R118, R125: 249k 1%; R_0402_1005Metric; MPN RC0402FR-07249KL
R98, R105, R112, R119: 3.83k 1%; R_0402_1005Metric; MPN RC0402FR-073K83L
R99, R100, R106, R107, R113, R114, R120, R121, R127, R128: 220R; R_0402_1005Metric; MPN RC0402FR-07220RL
R126: 1.65k 1%; R_0402_1005Metric; MPN RC0402FR-071K65L
U8: PCA9548APW; TSSOP-24_4.4x7.8mm_P0.65mm; MPN PCA9548APW,118
U9: TCA9535PWR; TSSOP-24_4.4x7.8mm_P0.65mm; MPN TCA9535PWR
U10, U11, U12, U13, U14: TPS259470ARPW; TI_RPW0010A_VQFN-HR-10_2x2mm_P0.475mm; MPN TPS259470ARPWR

Connections:
+3V3: C44.1, C45.1, R62.1, R63.1, R64.1, R65.1, R66.1, R67.1, R68.1, R69.1, R70.1, R71.1, R72.1, R73.1, R74.1, R75.1, R76.1, R77.1, R78.1, R79.1, R80.1, R81.1, R82.1, R83.1, R84.1, R85.1, R86.1, R87.1, R88.1, R89.1, R90.1, R92.1, R93.1, U8.24 (VCC), U9.24 (VCC); also elsewhere on the board
/I2C mux, expander, 5 V peripheral ports/MUX6_SCL: R77.2, U8.18 (SC6)
/I2C mux, expander, 5 V peripheral ports/MUX6_SDA: R76.2, U8.17 (SD6)
/I2C mux, expander, 5 V peripheral ports/MUX7_SCL: R79.2, U8.20 (SC7)
/I2C mux, expander, 5 V peripheral ports/MUX7_SDA: R78.2, U8.19 (SD7)
/I2C mux, expander, 5 V peripheral ports/PORT1_DVDT: C46.1, U10.7 (DVDT)
/I2C mux, expander, 5 V peripheral ports/PORT1_EN: Q3.3 (D), R94.2, R95.1, U10.1 (EN/UVLO)
/I2C mux, expander, 5 V peripheral ports/PORT1_FLT_N: R81.2, U9.13 (P10), U10.4 (~FLT)
/I2C mux, expander, 5 V peripheral ports/PORT1_ILM: R98.1, U10.9 (ILM)
/I2C mux, expander, 5 V peripheral ports/PORT1_ITIMER: C47.1, U10.10 (ITIMER)
/I2C mux, expander, 5 V peripheral ports/PORT1_OFF: Q3.1 (G), R80.2, U9.4 (P00)
/I2C mux, expander, 5 V peripheral ports/PORT1_OVLO: R96.2, R97.1, U10.2 (OVLO)
/I2C mux, expander, 5 V peripheral ports/PORT1_SCL: R65.2, R99.1, U8.5 (SC0)
/I2C mux, expander, 5 V peripheral ports/PORT1_SCL_C: D20.3, J1.2, R99.2
/I2C mux, expander, 5 V peripheral ports/PORT1_SDA: R64.2, R100.1, U8.4 (SD0)
/I2C mux, expander, 5 V peripheral ports/PORT1_SDA_C: D20.5, J1.3, R100.2
/I2C mux, expander, 5 V peripheral ports/PORT2_DVDT: C49.1, U11.7 (DVDT)
/I2C mux, expander, 5 V peripheral ports/PORT2_EN: Q4.3 (D), R101.2, R102.1, U11.1 (EN/UVLO)
/I2C mux, expander, 5 V peripheral ports/PORT2_FLT_N: R83.2, U9.14 (P11), U11.4 (~FLT)
/I2C mux, expander, 5 V peripheral ports/PORT2_ILM: R105.1, U11.9 (ILM)
/I2C mux, expander, 5 V peripheral ports/PORT2_ITIMER: C50.1, U11.10 (ITIMER)
/I2C mux, expander, 5 V peripheral ports/PORT2_OFF: Q4.1 (G), R82.2, U9.5 (P01)
/I2C mux, expander, 5 V peripheral ports/PORT2_OVLO: R103.2, R104.1, U11.2 (OVLO)
/I2C mux, expander, 5 V peripheral ports/PORT2_SCL: R67.2, R106.1, U8.7 (SC1)
/I2C mux, expander, 5 V peripheral ports/PORT2_SCL_C: D22.3, J2.2, R106.2
/I2C mux, expander, 5 V peripheral ports/PORT2_SDA: R66.2, R107.1, U8.6 (SD1)
/I2C mux, expander, 5 V peripheral ports/PORT2_SDA_C: D22.5, J2.3, R107.2
/I2C mux, expander, 5 V peripheral ports/PORT3_DVDT: C52.1, U12.7 (DVDT)
/I2C mux, expander, 5 V peripheral ports/PORT3_EN: Q5.3 (D), R108.2, R109.1, U12.1 (EN/UVLO)
/I2C mux, expander, 5 V peripheral ports/PORT3_FLT_N: R85.2, U9.15 (P12), U12.4 (~FLT)
/I2C mux, expander, 5 V peripheral ports/PORT3_ILM: R112.1, U12.9 (ILM)
/I2C mux, expander, 5 V peripheral ports/PORT3_ITIMER: C53.1, U12.10 (ITIMER)
/I2C mux, expander, 5 V peripheral ports/PORT3_OFF: Q5.1 (G), R84.2, U9.6 (P02)
/I2C mux, expander, 5 V peripheral ports/PORT3_OVLO: R110.2, R111.1, U12.2 (OVLO)
/I2C mux, expander, 5 V peripheral ports/PORT3_SCL: R69.2, R113.1, U8.9 (SC2)
/I2C mux, expander, 5 V peripheral ports/PORT3_SCL_C: D24.3, J3.2, R113.2
/I2C mux, expander, 5 V peripheral ports/PORT3_SDA: R68.2, R114.1, U8.8 (SD2)
/I2C mux, expander, 5 V peripheral ports/PORT3_SDA_C: D24.5, J3.3, R114.2
/I2C mux, expander, 5 V peripheral ports/PORT4_DVDT: C55.1, U13.7 (DVDT)
/I2C mux, expander, 5 V peripheral ports/PORT4_EN: Q6.3 (D), R115.2, R116.1, U13.1 (EN/UVLO)
/I2C mux, expander, 5 V peripheral ports/PORT4_FLT_N: R87.2, U9.16 (P13), U13.4 (~FLT)
/I2C mux, expander, 5 V peripheral ports/PORT4_ILM: R119.1, U13.9 (ILM)
/I2C mux, expander, 5 V peripheral ports/PORT4_ITIMER: C56.1, U13.10 (ITIMER)
/I2C mux, expander, 5 V peripheral ports/PORT4_OFF: Q6.1 (G), R86.2, U9.7 (P03)
/I2C mux, expander, 5 V peripheral ports/PORT4_OVLO: R117.2, R118.1, U13.2 (OVLO)
/I2C mux, expander, 5 V peripheral ports/PORT4_SCL: R71.2, R120.1, U8.11 (SC3)
/I2C mux, expander, 5 V peripheral ports/PORT4_SCL_C: D26.3, J4.2, R120.2
/I2C mux, expander, 5 V peripheral ports/PORT4_SDA: R70.2, R121.1, U8.10 (SD3)
/I2C mux, expander, 5 V peripheral ports/PORT4_SDA_C: D26.5, J4.3, R121.2
/I2C mux, expander, 5 V peripheral ports/PORT5_DVDT: C58.1, U14.7 (DVDT)
/I2C mux, expander, 5 V peripheral ports/PORT5_EN: Q7.3 (D), R122.2, R123.1, U14.1 (EN/UVLO)
/I2C mux, expander, 5 V peripheral ports/PORT5_FLT_N: R89.2, U9.17 (P14), U14.4 (~FLT)
/I2C mux, expander, 5 V peripheral ports/PORT5_ILM: R126.1, U14.9 (ILM)
/I2C mux, expander, 5 V peripheral ports/PORT5_ITIMER: C59.1, U14.10 (ITIMER)
/I2C mux, expander, 5 V peripheral ports/PORT5_OFF: Q7.1 (G), R88.2, U9.8 (P04)
/I2C mux, expander, 5 V peripheral ports/PORT5_OVLO: R124.2, R125.1, U14.2 (OVLO)
/I2C mux, expander, 5 V peripheral ports/PORT5_SCL: R73.2, R127.1, U8.14 (SC4)
/I2C mux, expander, 5 V peripheral ports/PORT5_SCL_C: D28.3, J5.3, R127.2
/I2C mux, expander, 5 V peripheral ports/PORT5_SDA: R72.2, R128.1, U8.13 (SD4)
/I2C mux, expander, 5 V peripheral ports/PORT5_SDA_C: D28.5, J5.4, R128.2
/I2C mux, expander, 5 V peripheral ports/V5_1: D19.1 (A1), J1.1, U10.6 (OUT)
/I2C mux, expander, 5 V peripheral ports/V5_2: D21.1 (A1), J2.1, U11.6 (OUT)
/I2C mux, expander, 5 V peripheral ports/V5_3: D23.1 (A1), J3.1, U12.6 (OUT)
/I2C mux, expander, 5 V peripheral ports/V5_4: D25.1 (A1), J4.1, U13.6 (OUT)
/I2C mux, expander, 5 V peripheral ports/V5_5: D27.1 (A1), J5.1, J5.2, U14.6 (OUT)
BUCK_PG: R93.2, U9.20 (P17); also elsewhere on the board
CHG_CD: U9.9 (P05); also elsewhere on the board
CHG_PG_N: R92.2, U9.19 (P16); also elsewhere on the board
EXP_INT_N: U9.1 (~INT); also elsewhere on the board
GND: C44.2, C45.2, C46.2, C47.2, C48.2, C49.2, C50.2, C51.2, C52.2, C53.2, C54.2, C55.2, C56.2, C57.2, C58.2, C59.2, C60.2, D19.2 (A2), D20.4, D21.2 (A2), D22.4, D23.2 (A2), D24.4, D25.2 (A2), D26.4, D27.2 (A2), D28.4, J1.4, J1.MP (MountPin), J2.4, J2.MP (MountPin), J3.4, J3.MP (MountPin), J4.4, J4.MP (MountPin), J5.5, J5.6, J5.MP (MountPin), Q3.2 (S), Q4.2 (S), Q5.2 (S), Q6.2 (S), Q7.2 (S), R95.2, R97.2, R98.2, R102.2, R104.2, R105.2, R109.2, R111.2, R112.2, R116.2, R118.2, R119.2, R123.2, R125.2, R126.2, U8.1 (A0), U8.2 (A1), U8.12 (GND), U8.21 (A2), U9.2 (A1), U9.3 (A2), U9.12 (GND), U9.21 (A0), U10.8 (GND), U11.8 (GND), U12.8 (GND), U13.8 (GND), U14.8 (GND); also elsewhere on the board
I2C0_SCL: U9.22 (SCL); also elsewhere on the board
I2C0_SDA: U9.23 (SDA); also elsewhere on the board
I2C1_SCL: R63.2, U8.22 (SCL); also elsewhere on the board
I2C1_SDA: R62.2, U8.23 (SDA); also elsewhere on the board
LCD_SCL: R75.2, U8.16 (SC5); also elsewhere on the board
LCD_SDA: R74.2, U8.15 (SD5); also elsewhere on the board
MUX_RST_N: U8.3 (~RESET); also elsewhere on the board
USBIN_FLT_N: R90.2, U9.18 (P15); also elsewhere on the board
USB_ILIM_1A5: U9.10 (P06); also elsewhere on the board
USB_ILIM_3A0: U9.11 (P07); also elsewhere on the board
V5: C48.1, C51.1, C54.1, C57.1, C60.1, R94.1, R96.1, R101.1, R103.1, R108.1, R110.1, R115.1, R117.1, R122.1, R124.1, U10.5 (IN), U11.5 (IN), U12.5 (IN), U13.5 (IN), U14.5 (IN); also elsewhere on the board

Notes on the sheet:
I2C1 MUX PCA9548APW (0x70)
A0-A2 = GND -> 0x70. RESET <- GPIO38 (10k up on MCU sheet). Upstream 10k pull-ups.
ch0-ch3 -> J1-J4 (E0001 5 V rev.), ch4 -> J5 (E0002 5 V rev.), ch5 -> EYESPI touch: 4.7k to 3V3.
ch6/ch7 spare: 10k pull-ups. Firmware: <= 4 channels open, writes only.
SYSTEM I/O EXPANDER TCA9535 (I2C0 0x20)
Reset state (all inputs): P00-P04 PORTn_OFF 100k up -> ports OFF; P05 CHG_CD 10k up (power sheet)
-> charging OFF; P06/P07 USB_ILIM_1A5/3A0 100k down at the leg FETs -> U_IN 0.50 A.
P10-P14 port FLT, P15 USBIN_FLT_N, P16 CHG_PG_N, P17 BUCK_PG: inputs, 10k pull-ups. INT -> GPIO48.
PORT 1: J1 5V GH4 E0001, 0.87 A
Silkscreen: "5V" + "1" + "E0001"
I_LIM 0.87 A (0.74-1.00); OVLO 6.02/5.47 V; UVLO 4.19/3.80 V
PORT 2: J2 5V GH4 E0001, 0.87 A
Silkscreen: "5V" + "2" + "E0001"
PORT 3: J3 5V GH4 E0001, 0.87 A
Silkscreen: "5V" + "3" + "E0001"
PORT 4: J4 5V GH4 E0001, 0.87 A
Silkscreen: "5V" + "4" + "E0001"
PORT 5: J5 5V GH6 E0002, 2.0 A
Silkscreen: "5V" + "5" + "E0002"
I_LIM 2.03 A (1.80-2.20); OVLO 6.02/5.47 V; UVLO 4.19/3.80 V
