Karpuls/E0005-esp32-s3-5v-controller/E0005_controller.kicad_pcb

## KiCad design E0005_controller.kicad_pcb (continued)

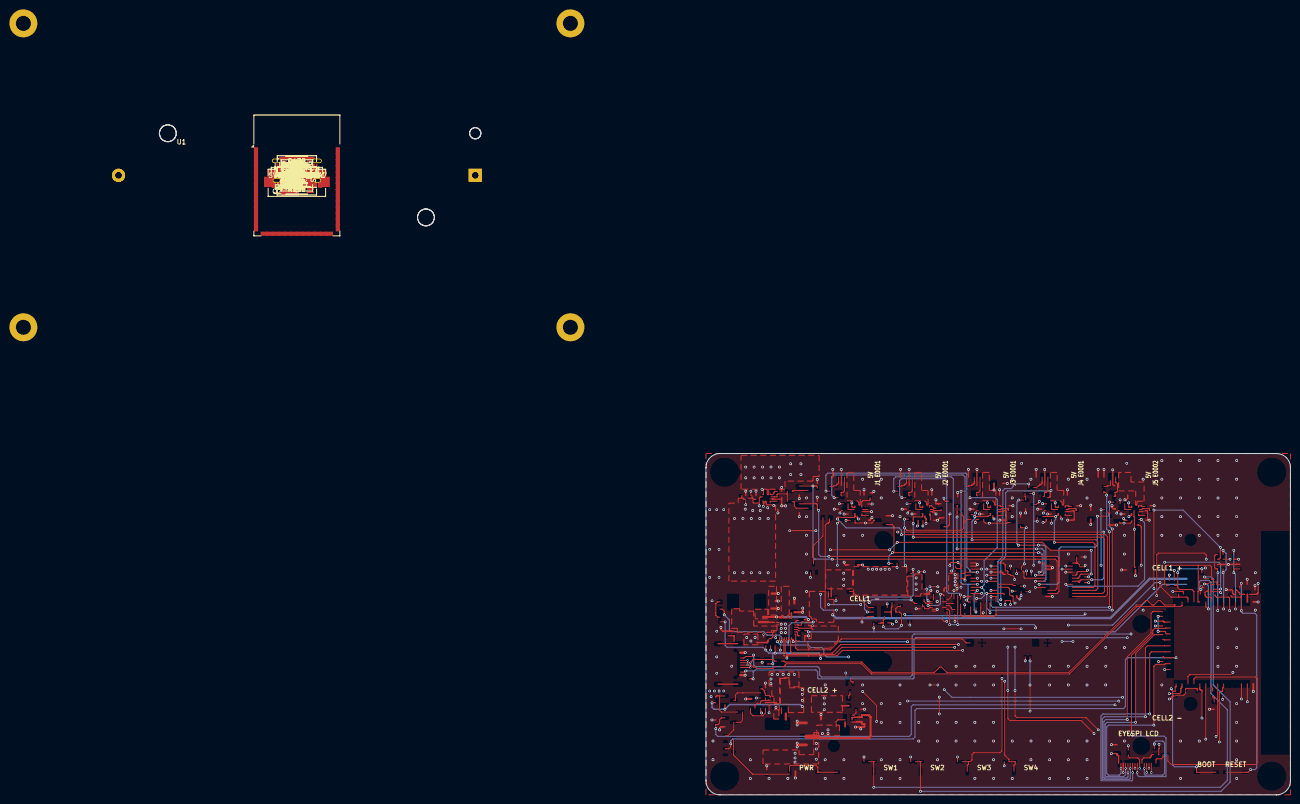
[picture p41: board E0005_controller.kicad_pcb from above]

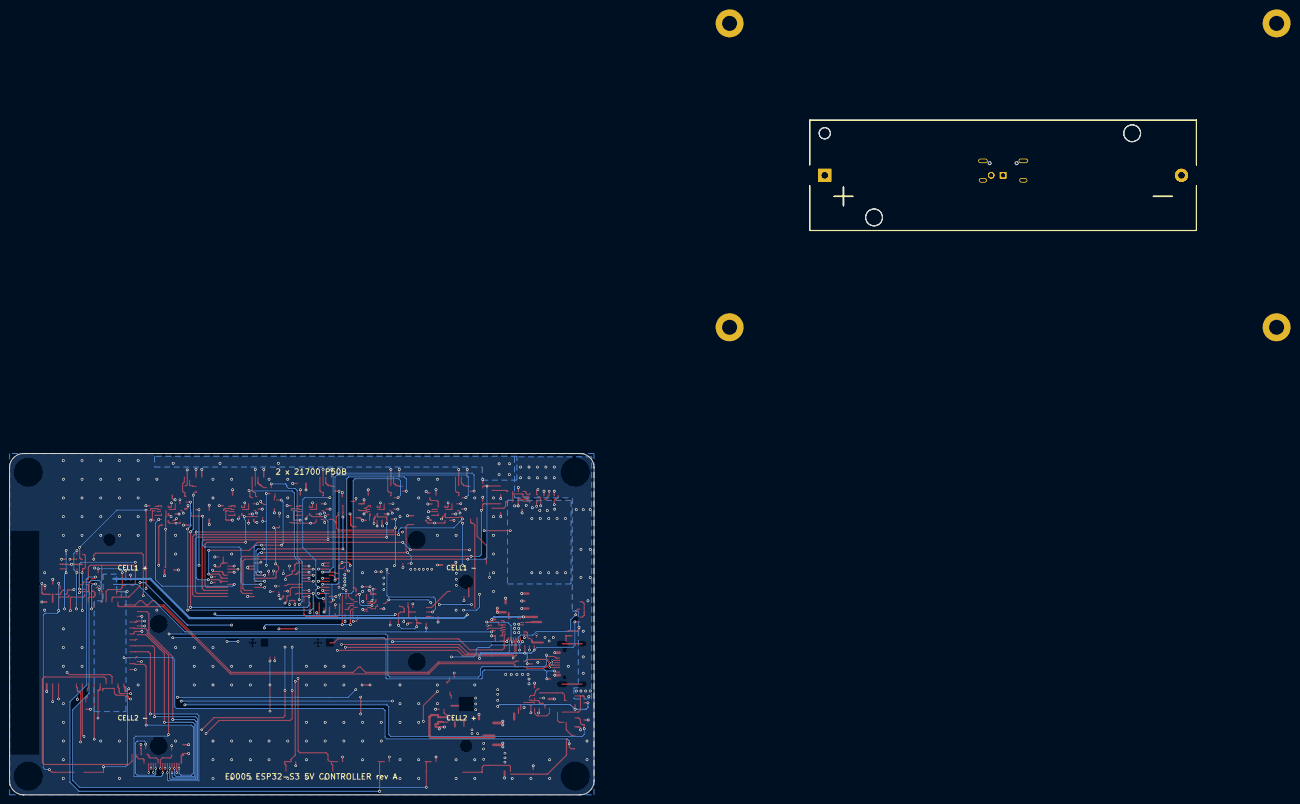
[picture p42: board E0005_controller.kicad_pcb from below]

Board: 4 copper layers, 125.0 x 73.0 mm, 270 parts (4 on the bottom side), 177 nets.

Other parts of the board:
OUT1: Holes_4xM3_125x73
