Karpuls/E0005-esp32-s3-5v-controller/(commit log)

2026-10-27 E0005 spec v0.2: PlaceRoute review items (U_IN 3 levels, VBUS budget, thermal, unplug dip, ADC fallback)
2026-10-27 E0005 schematic phase: copy E0003 project, sheets, libraries (renamed E0005/E0005_mech) and generator scripts
    [E0005_controller.kicad_sch, battery.kicad_sch, mcu.kicad_sch, ports.kicad_sch, power.kicad_sch]
2026-10-27 E0005 schematic: all four sheets captured for SPEC v1.0, ERC 0
    - power: USB-C CC Rd + ADC sense, U_IN TPS259470A with 3-level ILM legs, BQ25887 charger,
    TPS56637 2S->5 V buck with soft power latch, V5 sense, TPS629210 3V3 from V5
    - battery: BQ29209/OV2/MID divider removed (owner Q2)
    - mcu: SPEC 7 pin map (GPIO4/6/7 ADC, GPIO36 PWR_HOLD, GPIO48 EXP_INT_N), 9 V ESD on PB_RAW
    - ports: 5 V OVLO/UVLO dividers, SMF5.0A, 10 uF at each eFuse input
    - lib: TPS56637 symbol + TI RPA0010A footprint; E0003 references kept for unchanged parts
    [E0005_controller.kicad_sch, battery.kicad_sch, mcu.kicad_sch, new_parts_digikey.csv, ports.kicad_sch, power.kicad_sch]
2026-10-27 E0005 schematic: DigiKey BOM, schematic notes (checklist, deviations), placement notes, ERC 0
    [E0005_digikey_bom.csv, new_parts_digikey.csv]
2026-10-27 E0005 spec v1.1: TPS56637 L/C per datasheet Table 4, port UVLO 3.8 V, PWR_HOLD and low-pack derating rules
2026-10-27 E0005 schematic for SPEC v1.1: TPS56637 L1 3.3 uH IHLP3232 + V5 bulk 2 x 47 uF (~88 uF eff.), port UVLO 1M/402k, USB-only back-feed analysis, ERC 0
    - remove C61/C62 and the v1.0 extra buck caps (C77/C78 left unused); V5 effective-C table from Samsung DC-bias data
    - port EN/UVLO 402k on all 5 ports (4.19/3.80 V), TPS629210 dropout check at 3.8 V
    - O-1 closed, O-2 closed as SPEC v1.1 8.5/13; new section: V5 -> BAT+ back-feed with no battery (a)-(e)
    - BOM regenerated; placement notes updated for the 8.6 x 8.2 mm inductor
    [E0005_digikey_bom.csv, new_parts_digikey.csv, ports.kicad_sch, power.kicad_sch]
2026-10-27 E0005 spec v1.2: no-battery back-feed analysis (5.1.2), battery-detect rule 5.6 V + precharge probe (8.4)
2026-10-27 E0005: U2 BQ25887RGET -> BQ25887RGER cut tape (296-53517-1-ND), BOM regenerated, ERC 0
    [E0005_digikey_bom.csv, new_parts_digikey.csv, power.kicad_sch]
2026-10-27 E0005 board created from schematic: 269 parts + outline, E0003 stackup/setup (JLC04161H-3313), parity 0
    [E0005_controller.kicad_pcb]
2026-10-27 E0005 placement: power stage (U16 NW, U2/L2 west, U17/L1 SW, U5 3V3), port caps, CC/V5 sense placed; outline to board-level Edge.Cuts (holes-only fp)
    [E0005_controller.kicad_pcb]
2026-10-27 E0005: project file as saved by KiCad (board settings serialized, no rule changes)
2026-10-27 E0005 placement: WIP, paused for holder check
    All 269 parts placed; antenna keep-out rule area, U16 reservation markers, port/cell silk added;
    silk pass (refs where they fit, else Fab). Placement DRC: 0 courtyard/clearance, 17 silk_overlap
    (port/cell labels: kipy dropped the 90 deg text angle), 1 lib_footprint_mismatch (U1 EP vias, as E0003).
    [E0005_controller.kicad_pcb]
2026-10-27 E0005: fix Keystone 1121 3D model (mirrored Y, lug geometry) and add top-side keep-out rings around holder lugs/pegs
    Footprint verified against Keystone K75 p.30; only the model was wrong.
    DRC now flags 15 top-side parts crowding the holder lugs/pegs.
    [E0005_controller.kicad_pcb]
2026-10-27 E0005 placement: parts moved clear of BH1/BH2 top-side keep-out rings (15 overlaps -> 0), silk text angles fixed
    [E0005_controller.kicad_pcb]
2026-10-27 E0005 placement: silkscreen pass (refs where they fit, CELL2+ label moved), DRC silk 0
    [E0005_controller.kicad_pcb]
2026-10-27 E0005 placement ready for review: DRC 0 (all severities, parity 0; U1 lib mismatch as E0003), audits/route checks per IC, renders
    [E0005_controller.kicad_pcb]
2026-10-27 E0005: subthread briefs (schematic, placement, routing incl. board-size decision)
2026-10-27 E0005 routing milestone 1: power stage (U16 U_IN pours, U17 buck hot loop, U2 charger loop/fan-out, U5 3V3); hand/IPC routing scripts in build/route
    [E0005_controller.kicad_pcb]
2026-10-27 E0005 routing milestone 2: battery path (B_N/FET_D/SNS_P pours F.Cu+In2, CELL2_P, MID link B.Cu+In2, MID/CBSET sense traces from the lug), S-8252 and MAX17205 with Kelvin CSP/CSN from R20; nudges R28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
    [E0005_controller.kicad_pcb]
2026-10-27 E0005 routing: port eFuses U10-U14 local routing (EN trees on In2, V5_k pours, ESD/connector), In2 split V5/3V3; nudges R98, R85
    [E0005_controller.kicad_pcb]
2026-10-27 E0005 routing: U8/U9 fan-out, CHG_G/BAT+ reroute, In2 V5 band narrowed (top In2 strip free for signals)
    [E0005_controller.kicad_pcb]
2026-10-27 E0005 routing: U8 pull-up network, 3V3 rail, port fan-out fixes
    [E0005_controller.kicad_pcb]
2026-10-27 E0005 routing WIP: port 1/2 I2C to U8, MUX6/7 pull-ups, V5 top bus for ports 4/5, probe/grid helpers
    [E0005_controller.kicad_pcb]
2026-10-27 E0005 routing: U1 north pin-row cluster (pull-ups, sense dividers, SW RC), USB D+/D- 90 ohm pair (W0.19/S0.20, skew <0.01 mm), MID pour cut back east of BH1 lug for y<-9
    [E0005_controller.kicad_pcb]
2026-10-27 E0005 routing: U1 west column, LCD J10 via comb + F/B LCD bus (MOSI/SCK/MISO/DC/LITE/CS/TSCS), J10 pull-ups
    [E0005_controller.kicad_pcb]
2026-10-27 E0005 routing: U1 south row (BOOT/EN switches, LED, pull-ups, In2 starts of west-going lines), LCD RST/SDCS/TOUCH In2 to J10 comb
    [E0005_controller.kicad_pcb]
2026-10-27 E0005 routing: west-going long lines from U1 (GAUGE_ALRT_N, CHG_INT_N, PWR_HOLD, PWR_BTN_N; MUX_RST/I2C1 partial), eFuse split-pin and switch twin-pad links
    [E0005_controller.kicad_pcb]
2026-10-27 E0005 routing: CC1/CC2 from the U1 sense dividers to the USB-C resistors; CHG_INT_N In2 hop
    [E0005_controller.kicad_pcb]
2026-10-27 E0005 routing: USB-C side D+/D- (J11 -> U4 ESD -> R2/R3, B-row pins tied with 0.45 vias)
    [E0005_controller.kicad_pcb]
2026-10-27 E0005 routing: outline enlarged to 125 × 73 mm (8 mm north: port band + U16 moved with the edge; 4xM3 holes kept 4 mm from the corners via E0005_board:Holes_4xM3_125x73)
    [E0005_controller.kicad_pcb]
2026-10-27 E0005 routing: band routes from U9 (OFF lines, CD/ILIM under-body, PORT5_OFF east, EXP_INT_N In2 to U1/R40)
    [E0005_controller.kicad_pcb]
2026-10-27 E0005 routing: C45 back next to U9 (decoupling), PORT2_EN link off In2 (V5 band continuous), EXP_INT_N In2 lane in a 3V3 strip
    [E0005_controller.kicad_pcb]
2026-10-27 E0005 routing: PORT1-5_OFF through the new band, port-internal links pulled out of the band, pad endpoints use current positions
    [E0005_controller.kicad_pcb]
2026-10-27 E0005 routing: band junction fixes (e5qc PASS)
    [E0005_controller.kicad_pcb]
2026-10-27 E0005 routing: USB_ILIM x2 to Q11/Q12 gates, PORT1_OFF pull-up hop, PORT1_EN fix
    [E0005_controller.kicad_pcb]
2026-10-28 E0005 spec v1.3: outline 125 x 73 mm (8 mm north for the port band)
2026-10-28 E0005 routing: U2 bundle (CHG_TS/CD, I2C0 to gauge), I2C0 to U1 via the MID B channel, AIN1 reroute, MUX6_SCL on B, R20 GND vias
    [E0005_controller.kicad_pcb]
2026-10-28 E0005 routing: PORT1-5_FLT_N from U9 through the band (F columns/lanes, B legs), PORT2_OFF B column, C45/Q7 GND vias fixed after the enlargement
    [E0005_controller.kicad_pcb]
2026-10-28 E0005 routing: USBIN_FLT_N U9 -> band -> In2 -> U16 (split pin joined), band lanes at 0.55 pitch, R90.1 own 3V3 via, PORT3_OFF via moved
    [E0005_controller.kicad_pcb]
2026-10-28 E0005 routing: CHG_PG_N and BUCK_PG from U9 to the west power stage (band / west corridor; centre B lane + In2), R92.1 own 3V3 via, BUCK_PG pin link hugs U9
    [E0005_controller.kicad_pcb]
2026-10-28 E0005 routing: PORT5_SCL/SDA U8 -> south B lanes -> F columns -> port 5 pull-ups; Q7.2 GND via, BUCK_PG via shift; probe resolves pads in the final frame
    [E0005_controller.kicad_pcb]
2026-10-28 E0005 routing: PORT3/4 SCL/SDA through U8 channels and band B columns to the port pull-ups, MUX6_SCL link on In2, R64.1 3V3 via moved
    [E0005_controller.kicad_pcb]
2026-10-28 E0005 routing: LCD_SCL/SDA U8 -> J10 (In2 columns, B under USB, F diagonals), PORT4/PORT3_SCL/LCD vias, 3V3 rail via moved
    [E0005_controller.kicad_pcb]
2026-10-28 E0005 routing: MUX_RST_N U8 -> west In2 column -> U1 B lane; U15 EP via (-12,-7.15) dropped
    [E0005_controller.kicad_pcb]
2026-10-28 E0005 routing: SW1-4_IN U1 pull-ups -> J6-J9 (B under U1 east / south edge; In2 west of U1 + F), connector-side links
    [E0005_controller.kicad_pcb]
2026-10-28 E0005 routing: BAT+ C18 vias into the In2 strip, gauge VBATT sense feed to R28.1
    [E0005_controller.kicad_pcb]
2026-10-28 E0005 routing: I2C1 pair U8 -> west In2 loop -> U1 lanes, R62/R63 pull-ups joined; LCD F lanes moved south
    [E0005_controller.kicad_pcb]
2026-10-28 E0005 routing: F/B GND pours + 4 mm GND stitching, In2 3V3 plane bridges, missing 3V3/GND feeds, island removal; DRC 0/0/0 (U1 lib exception), e5qc PASS
    - pours 0.21 mm (USB pair 0.3 mm via DRU rule), U17 fine-pitch pour-corner DRU exception
    - EN to C37.1 under the U1 caps (frees C36.2 GND), SW1_IN B west of C38 (C38.2 GND via), CHG_STAT B lane shifted (C2.2 GND via)
    [E0005_controller.kicad_pcb]
2026-10-28 E0005 routing: PlaceRoute fix round - U16 VBUS/V5 pours, R147 copper + CHG_PG_N via, FB network on F, 135-degree bends and square pad exits (e5qc PASS), USB retuned, routing notes (IPC-2152, hot loop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
    [E0005_controller.kicad_pcb]
2026-10-28 E0005 routing: review fixes - DRC shorts at R133/R135, R151/R152, R35/C36, D19 (four-pad X exits, ITIMER lane), V5 B.Cu west strap + USBIN_FLT_N off the In2 V5 column, SNS_P F pour widened, IPC-2152 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
    [E0005_controller.kicad_pcb]
2026-10-28 E0005: stack-up corrected to JLC04161H-3313 (L1-L2 0.2064 mm, core 1.065 mm); spec v1.5, routing notes (USB pair to be re-widened)
    [E0005_controller.kicad_pcb]
2026-10-28 Revert stack-up change 61dd2c8: false alarm, JLC04161H-3313 L1-L2 is 0.0994 mm as the board had (owner-confirmed); spec back to v1.4 text
    [E0005_controller.kicad_pcb]
2026-10-28 E0005 routing: USB pair re-widened to W 0.153 / S 0.20 mm (90 ohm per JLC calculator, JLC04161H-3313), _C segments too; skew 0.001 mm; notes
    [E0005_controller.kicad_pcb]
2026-10-28 E0005 routing: no same-net vias in pads - L1.2 V5 via moved (3 vias between L1 and C76), FET_D vias out of the Q1/Q2 tab gap (6 vias north of the tabs), sweep in notes
    [E0005_controller.kicad_pcb]
2026-10-28 E0005 fab (WIP): fab_export.sh + gerber_review.py, fab/E0005_revA package from 68121a4 (preliminary, USB re-width pending), gerber review, README/PREORDER/BOM_README, project README
    [E0005_controller-B_Cu.gbl, E0005_controller-B_Mask.gbs, E0005_controller-B_Paste.gbp, E0005_controller-B_Silkscreen.gbo, E0005_controller-Edge_Cuts.gm1, E0005_controller-F_Cu.gtl, E0005_controller-F_Mask.gts, E0005_controller-F_Paste.gtp]
2026-10-28 E0005 fab outputs rev A on 50c434e: fab_export.sh run (DRC 1 = U1 exception / 0 unconnected / 0 parity, ERC 0), JLC gerbers+drill zip, CPL, DigiKey+JLC BOM, STEP, assembly PDFs; gerber review (F-1/F-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
    [E0005_controller-B_Cu.gbl, E0005_controller-B_Mask.gbs, E0005_controller-B_Paste.gbp, E0005_controller-B_Silkscreen.gbo, E0005_controller-Edge_Cuts.gm1, E0005_controller-F_Cu.gtl, E0005_controller-F_Mask.gts, E0005_controller-F_Paste.gtp]
2026-10-28 E0005 rev A done: CPL Layer Top/Bottom (in fab_export.sh), fab README tenting line, spec status complete
    Re-run on 50c434e: only the CPL changed; every other output differed only in timestamps and was kept as committed, so the gerber zip is byte-identical.
    [E0005_revA_CPL_JLC.csv]
